asadbahauddin/thermoadapt-fryer/README.md

# ThermoAdapt Fryer

**Kontrol suhu minyak deep fryer berbahan bakar gas dengan Adaptive PID berbasis ESP32.**
Termasuk firmware mikrokontroler, telemetri WebSocket, logger data Python, serta
identifikasi sistem (FOPDT) dan tuning PID robust (SIMC) di MATLAB.

> Status: prototipe riset. Bagian yang **belum terverifikasi di hardware** ditandai di
> komentar kode. Jangan sambungkan servo ke katup gas sebelum `SERVO_SAFETY` diaktifkan.

## Struktur

| Folder / file | Isi |
|---|---|
| `dep_frayer/dep_frayer.ino` | Firmware ESP32: WiFi AP + web + WebSocket, MAX31855, servo katup gas, motor DC Z (BTS7960), stepper X (TB6600), 4 limit switch, LCD ILI9488, buzzer |
| `Python/` | Logger data uji via WebSocket: grafik live (suhu vs setpoint, bukaan servo) + CSV semua sensor/aktuator, auto-simpan CSV & PNG saat berhenti |
| `Program/` | Model Simulink Adaptive PID + simulasi (parameter plant masih asumsi) |
| `Program/step_test/` | Identifikasi FOPDT dari data step test + tuning PI SIMC + cek robustness (Ms, PM, GM) |
| `pin_scan.txt` | Sketch diagnostik pin limit switch |
| `FRITZINK.fzz` | Rangkaian (Fritzing) |

## Perangkat keras

ESP32 DevKit V1 30-pin · thermocouple K + MAX31855 · servo 180° pada katup gas ·
motor DC + BTS7960 (sumbu Z) · stepper NEMA + TB6600 (sumbu X) · TFT ILI9488 · 4 limit switch.

## Logger data (Python)

```
pip install -r Python/requirements.txt
python Python/logger.py            # laptop tersambung ke WiFi DeepFryer-ESP32
python Python/logger.py --demo     # coba tanpa hardware
python Python/uji_logger.py        # uji otomatis (parser, WebSocket, end-to-end)
```

Berhenti dengan menutup jendela grafik atau Ctrl+C. CSV (ditulis tiap sampel, aman bila
crash) dan PNG seluruh pengujian tersimpan di `Python/data/deepfryer_<tanggal>_<jam>.*`.
Satu baris per sampel suhu (1 Hz); waktu memakai jam ESP32 (`ms`) sehingga bebas jitter WiFi.
Kolom PID (firmware rev 16-17): `pid_aktif`, `pid_output_pct`, `setpoint_efektif_c`, `kp`, `ki`, `kd`
(gain yang SEDANG dipakai, berubah tiap detik saat Adaptive PID), `kp0`/`ki0`/`kd0` (gain dasar),
`pid_adaptif`, `lambda_p`/`lambda_i`/`lambda_d`,
`pid_umax_pct`. Grafik live: suhu vs setpoint vs setpoint efektif, dan sudut servo vs keluaran PID.
`suhu_c` adalah suhu tersaring firmware (Cascaded Filtering 3 tahap: Median-5 → Moving Average-5 → EMA, + hold saat sensor error);
`suhu_mentah_c`, `suhu_ditahan`, `sensor_error_total` mencatat bacaan mentah dan kondisi sensor.
Kolom `buzzer_aktif` sudah ada tetapi kosong karena
firmware belum mengirimnya.

## Alur tuning PID

1. Step test open-loop (PID mati, bukaan katup manual), rekam dengan logger Python.
2. `analisis_step_test('file.csv')` di MATLAB → model K, τ, L per titik kerja.
3. Gain PI SIMC yang aman di semua titik kerja (Ms terburuk ≤ 1.7).
4. Validasi di Simulink, lalu di alat.

Uji tanpa hardware: `uji_sintetis` di `Program/step_test/`.
