asadbahauddin/thermoadapt-fryer/FRITZINK_bb.png

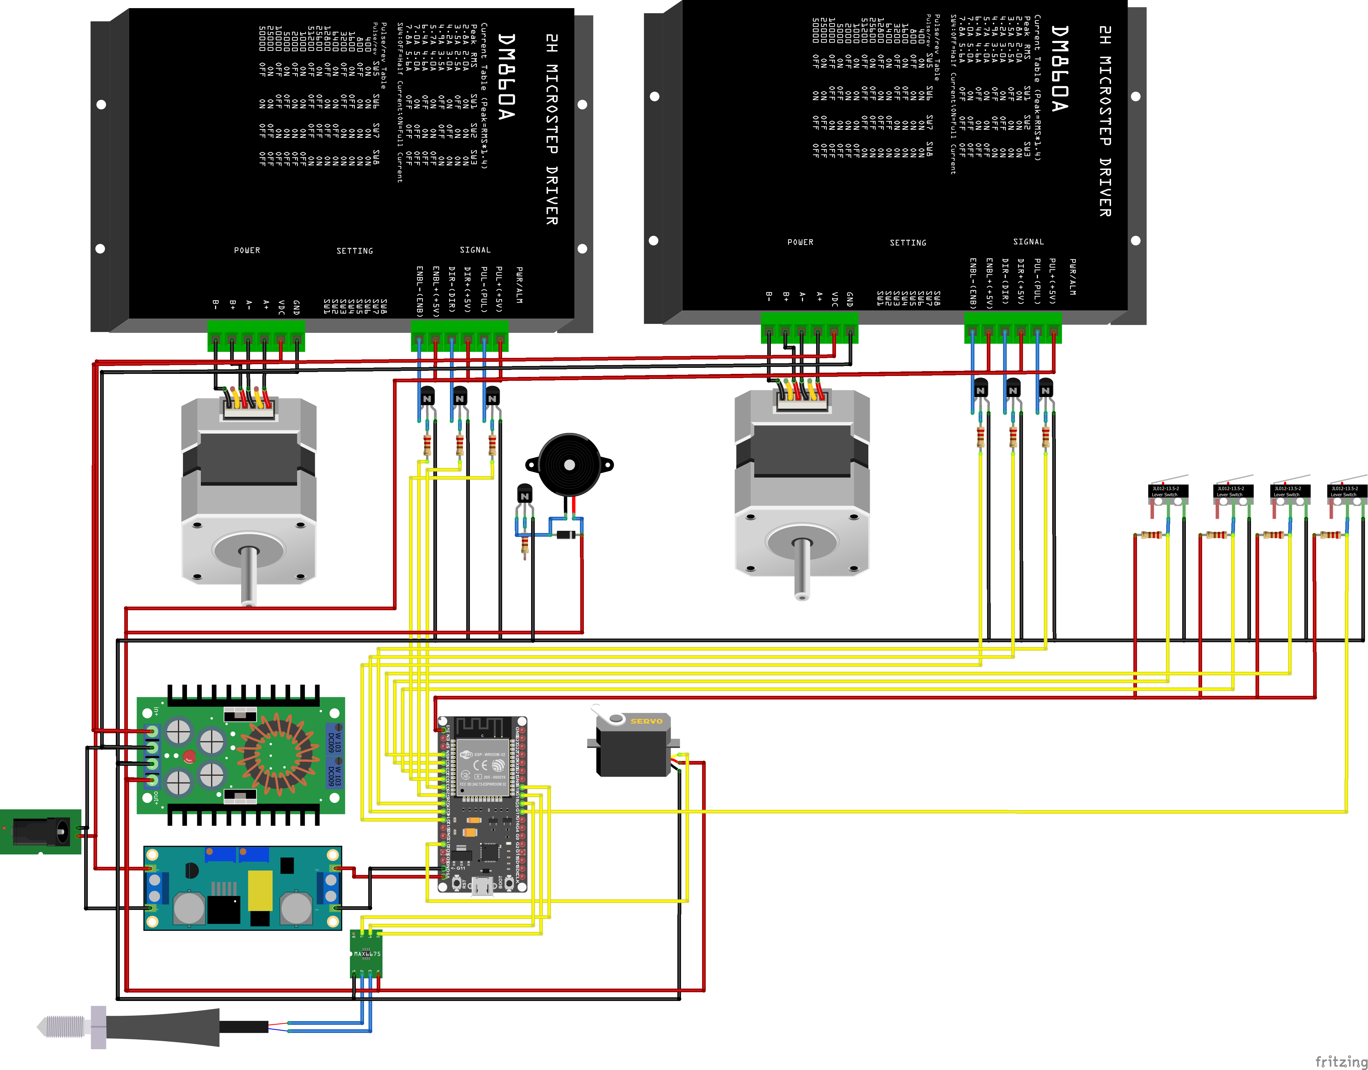
FRITZINK_bb.png
