asadbahauddin/thermoadapt-fryer/Program/deep_fryer_adaptive_pid_response.png

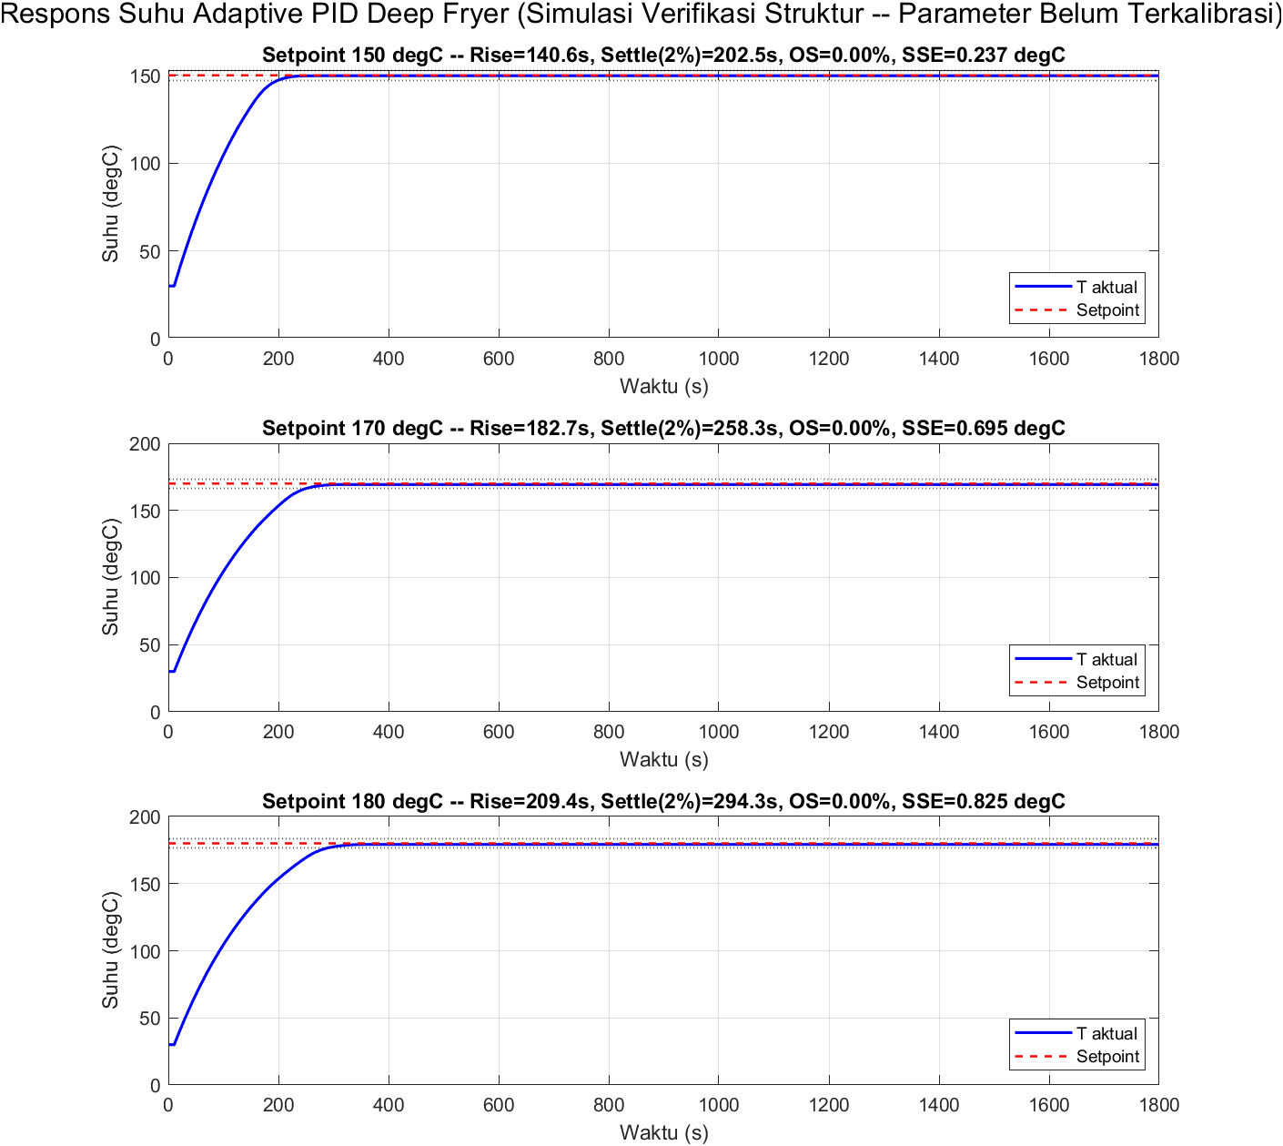
Program/deep_fryer_adaptive_pid_response.png
