asadbahauddin/thermoadapt-fryer/(list of files, drawings)

Other design files:
FRITZINK.fzz
