asadbahauddin/thermoadapt-fryer/dep_frayer/dep_frayer.ino

/*
 * DEEP FRYER CERDAS - MONITOR & KONTROL VIA WEB + LCD (rev 38)
 * ESP32 = WiFi Access Point (192.168.4.1) + WebSocket.
 * Isi: suhu MAX31855, 4 limit switch, Z = MOTOR DC (BTS7960), X = stepper (TB6600),
 *      SERVO katup gas 0-180 derajat (kalibrasi), BUZZER, LCD TFT mirror dari web.
 *
 * REV 38 (dari rev 37): integral TIDAK PERNAH dinolkan: dibekukan saat TAHAN AMAN (sensor error/
 *   data berhenti), diingat saat STOP PID/STOP dan dipakai lagi saat PID ON (berlaku kedua mode).
 *
 * REV 37 (dari rev 36): TAHAN overshoot membekukan integral (dulu dinolkan) -> tidak ada lagi
 *   penurunan suhu 7-18 C setelah tiap TAHAN (analisis log 31 Okt & 1 Nov, simulasi IAE -58..-89%).
 *
 * REV 36 (dari rev 35): Uji Sistem - Z naik 60% (55% kurang kuat), rentang stabil SP +-3 C
 *   (dulu SP-3..SP+7); tetap harus 30 dtk berturut-turut di rentang sebelum keranjang turun.
 *
 * REV 35 (dari rev 34): Uji Sistem - suhu dianggap stabil setelah 30 dtk (dulu 10 dtk)
 *   berturut-turut di SP-3..SP+7 sebelum keranjang diturunkan.
 *
 * REV 34 (dari rev 33): TOMBOL MODE PID + FEEDFORWARD BEBAN (analisis log 31 Okt)
 *   - Web: PID ADAPTIF ON ("pidm,1"), PID KONVENSIONAL ON ("pidm,0", gain dasar tetap), STOP PID.
 *   - Feedforward beban keripik: saat Uji Sistem menurunkan keranjang, keluaran + 25% meluruh
 *     (tau 90 dtk), ditahan saat suhu >= setpoint, batal saat TAHAN/PID mati. Gain dasar TIDAK
 *     diubah (identifikasi closed-loop: sudah di rentang SIMC). JSON temp: pf (FF %), am (mode).
 *
 * REV 33 (dari rev 32): UJI SISTEM / UJI KEMATANGAN OTOMATIS (perintah "uj,<detik>")
 *   - Z naik ke Z Atas -> X ke X Awal -> suhu di SP-3..SP+7 selama 10 dtk -> Z turun 50% sampai
 *     Z Bawah -> timer goreng (default 120 dtk, 5-1800 dari web) -> Z naik 55% sampai Z Atas ->
 *     X ke X Akhir (tetap di sana). Gerak uji tanpa batas waktu (limit switch yang menghentikan).
 *   - PID dinyalakan otomatis & tetap ON. STOP membatalkan uji. Gerak manual ditolak selama uji.
 *   - JSON "temp": uj (tahap 0-9), us (detik; tahap 5 = sisa timer), uf (timer); dicatat logger.
 *
 * REV 32 (dari rev 31): PEMBACAAN MAX31855 DIPERKUAT (analisis bacaan 200 C)
 *   - Tiap sampel: frame dibaca 2x berturut-turut; berbeda = data rusak di SPI -> ditolak.
 *   - Dekode sendiri dgn validasi datasheet (D16, D17, D3, 0x0/0xFFFFFFFF, cold junction -20..85 C).
 *     Library readCelsius() hanya cek D2..D0: frame rusak lolos sbg suhu "sah", 0x00000000 = 0 C.
 *   - Acuan cek kewajaran baru sah setelah 3 sampel konsisten (dulu 1: sampel rusak bisa jadi acuan).
 *   - Penghitung per jenis error + suhu chip di web (JSON "st": nf, nb, nm, nc, nj, cj) & logger.
 *
 * REV 31 (dari rev 30):
 *   - LCD DIMATIKAN (LCD_ENABLE 0): tidak diinisialisasi/digambar; bus SPI hanya untuk MAX31855.
 *     CS LCD (4) & CS touch (16) ditahan HIGH; GPIO15 (RESET LCD) tidak dikendalikan.
 *     Tombol "Reset LCD" membalas "LCD dimatikan". LCD_ENABLE 1 = perilaku rev 30.
 *   - Sudut servo paling minimum -1 derajat (manual, kalibrasi, TUTUP). TUTUP tersimpan -3 -> -1.
 *
 * REV 30 (dari rev 29): PENGAMAN 180 C DINONAKTIFKAN (keputusan pengguna, ada E-stop fisik)
 *   - PID_CUTOFF_ENABLE 0: tidak ada batas suhu otomatis di PID (kode tetap ada; ganti ke 1 untuk
 *     mengaktifkan lagi). TAHAN untuk sensor error / data berhenti / overshoot tetap ada.
 *   - Web: setpoint > 200 C minta konfirmasi (penangkal salah ketik, bukan batas).
 *   - Simulasi rev 29: tanpa batas, setpoint tinggi benar-benar dikejar; E-stop wajib memutus gas.
 *
 * REV 29 (dari rev 28): SETPOINT BEBAS
 *   - Setpoint menerima angka berapa pun (web & firmware), tanpa batas 20-165. Pengaman 180 C
 *     tetap: suhu >= 180 -> TAHAN AMAN (katup TUTUP, PID ON) sampai <= 175. Kode TAHAN 5 dihapus.
 *
 * REV 28 (dari rev 27): PID ON SELALU BISA DINYALAKAN
 *   - Dulu PID ON ditolak bila sensor tidak valid/HELD, suhu >= 175 C, setpoint > 165 C, step test
 *     berjalan, atau servo terkunci. Sekarang PID ON selalu berhasil; kondisi tidak aman ->
 *     langsung TAHAN AMAN (katup TUTUP) dan berjalan sendiri saat normal. Step test yang berjalan
 *     dihentikan otomatis.
 *   - Setpoint maks = 165 C di web & firmware (dulu web menerima sampai 200 tetapi PID menolak).
 *
 * REV 27 (dari rev 26): PID TIDAK PERNAH MATI OTOMATIS (permintaan pengguna)
 *   - PID hanya mati lewat PID OFF / STOP. Sensor error > 5 dtk, suhu >= 180 C, data suhu berhenti,
 *     setpoint > batas, dan overshoot -> TAHAN AMAN: katup TUTUP (api minimum), integral 0, PID
 *     tetap ON, lanjut sendiri saat kondisi normal (180 C: lanjut di <= 175 C). JSON "ph" = kode.
 *   - Setelah ESP restart PID tetap OFF (sengaja: api tidak menyala sendiri tanpa orang).
 *
 * REV 26 (dari rev 25): CEK KEWAJARAN SENSOR
 *   - Bacaan yang melompat lebih cepat dari SENSOR_MAX_RATE_C_S (5 C/dtk) + margin 2 C dianggap
 *     BACAAN SALAH (mis. 65 -> 200 C): nilai wajar terakhir ditahan (HELD), PID TETAP HIDUP.
 *     Bila bertahan > 3 dtk -> NAN; > 5 dtk -> PID mati "sensor error". Kenaikan nyata yang
 *     bertahap sampai 180 C tetap mematikan PID (batas akhir). Batas lolos melebar seiring waktu
 *     sejak sampel wajar terakhir (acuan TIDAK dihapus saat masa tahan habis; 65 -> 200 C baru
 *     diterima setelah ~27 dtk). Bacaan di luar -20..450 C selalu dianggap salah.
 *
 * REV 25 (dari rev 24):
 *   - WebSocket heartbeat (ping 5 dtk, 2x tanpa pong -> putus). Klien mati tidak lagi
 *     menghabiskan 5 jatah klien library (gejala: halaman tampil tapi "tidak bisa ditekan").
 *   - Jumlah klien WebSocket tampil di baris diagnosa web ("st": wc, wm).
 *   - Halaman web diuji di Chrome headless (klik mouse & sentuh HP, ESP tiruan): 55/55 tombol
 *     mengirim perintah, tanpa error JavaScript, tidak ada elemen yang menutupi tombol.
 *
 * REV 24 (dari rev 23):
 *   - OVERSHOOT tidak lagi mematikan PID: suhu >= setpoint + PID_HOLD_C (10 C) -> katup ditahan
 *     TUTUP, integral 0, PID tetap ON; normal lagi saat suhu <= setpoint + 7 C. PID MATI hanya
 *     di batas akhir TEMP_CUTOFF_C (180 C), sensor error, atau STOP. JSON "temp" + "ph" (tahan).
 *   - Step test web: hasil ditandai TIDAK VALID (gain tidak ditampilkan) bila R^2 < 0.9,
 *     kenaikan < 10 C, kemiringan tidak konsisten, atau durasi < 3 x dead time.
 *   - Gain default sementara: Kp 1.46, Ki 0.0054 (Ti 270 dtk), lambda_i 0.
 *
 * REV 23 (dari rev 22):
 *   - Reset LCD otomatis tiap 30 dtk DIMATIKAN (LCD_REINIT_MS 0): pengguna menilai rev 21 lebih
 *     stabil. Diganti tombol "Reset LCD" di web (perintah "lcdr") yang menjalankan urutan sama:
 *     pin RESET -> tft.init() -> MAX31855 begin() -> gambar ulang (non-blocking, di uiTask).
 *     Pin RESET saja TIDAK cukup: setelah reset hardware ILI9488 kembali ke kondisi awal
 *     (sleep, format warna & rotasi hilang) sehingga harus diinisialisasi ulang.
 *   - Watchdog, diagnosa, dan pola non-blocking rev 22 tetap.
 *
 * REV 22 (dari rev 21): ROBUST
 *   - LCD di-reset (hardware) + diinisialisasi ulang tiap LCD_REINIT_MS (30 dtk), lalu semua
 *     elemen digambar ulang. MAX31855 di-begin() ulang (bus SPI dipakai bersama LCD).
 *     Sampling suhu tertunda ~0.4 dtk saat itu; layar berkedip sesaat.
 *   - WATCHDOG: loop() dan uiTask diawasi; macet > WDT_TIMEOUT_S (10 dtk) -> ESP restart
 *     sendiri. Setelah restart katup ke TUTUP, PID mati, motor diam (aman, tidak lanjut sendiri).
 *   - Alasan boot terakhir (POWER_ON / TASK_WDT / BROWNOUT / PANIC ...), heap minimum,
 *     sisa stack uiTask, dan jumlah reset LCD tampil di web (JSON "st": rr, hp, sk, lr).
 *   - IP di LCD diformat tanpa String (tidak memecah heap tiap 150 ms).
 *   - NON-BLOCKING / MULTITASKING KOOPERATIF / BLINK WITHOUT DELAY:
 *       core 1 loop(): web, WebSocket, stepper, step test, servo (20 ms), motor DC (10 ms),
 *                      buzzer (pola ms), PID (tiap sampel 1 Hz), status (250 ms); semua berbasis
 *                      millis(), tanpa delay().
 *       core 0 uiTask: servis LCD (state machine reset), sampel suhu (200 ms), LCD (150 ms),
 *                      reset LCD (30 dtk); vTaskDelay(10 ms) menyerahkan CPU tiap putaran.
 *     Reset LCD dulu delay(210 ms) -> sekarang state machine millis(). Sisa tunggu: delay
 *     internal tft.init() library (~295 ms, tiap 30 dtk, hanya di core 0) dan
 *     delayMicroseconds(2) waktu setup CS MAX31855 (syarat datasheet).
 *
 * REV 21 (dari rev 20):
 *   - FILTER SUHU diganti CASCADED FILTERING 3 TAHAP: Median-5 -> Moving Average-5 -> EMA
 *     (alpha 0.3), menggantikan tolak-lonjakan + Savitzky-Golay rev 15. HOLD saat fault tetap.
 *     Jeda ~1.3 dtk, std noise ~34%, lonjakan 1-2 sampel dibuang (lihat blok FILTER).
 *   - Servo default hasil kalibrasi: TUTUP -3 derajat, BUKA 55 derajat. PID Umax default 100%
 *     (seluruh rentang). Nilai di flash (bila pernah disimpan dari web) tetap diutamakan.
 *
 * REV 20 (dari rev 19): PERBAIKAN "mentok di 0 derajat"
 *   - Tombol -1/+1 dan kotak "Sudut" (sva/svad) dulu memakai setServoAngle() yang DIAM-DIAM
 *     mengunci ke TUTUP..BUKA, sehingga di 0 derajat -1 tidak berbuat apa-apa. Sekarang semua
 *     perintah manual memakai setServoAngleManual(): -30..180 derajat, dibatasi pulsa, dan
 *     memberi pesan bila ditolak. PID & step test tetap dikunci TUTUP..BUKA.
 *   - Halaman web dikirim dengan header no-cache (HP tidak memakai halaman lama).
 *   - Versi firmware (FW_REV) tampil di judul halaman web.
 *
 * REV 19 (dari rev 18): kalibrasi boleh SUDUT NEGATIF (sampai SERVO_CAL_MIN_DEG, dibatasi pulsa
 *   >= SERVO_US_ABS_MIN), mis. TUTUP = -3 derajat bila di 0 derajat katup masih bocor.
 *
 * REV 18 (dari rev 17): KALIBRASI KATUP lewat kotak angka (tanpa slider)
 *   - Web: sudut uji 0..180 per 1 derajat ("svk,<deg>", bebas dari kunci TUTUP..BUKA), simpan
 *     sebagai TUTUP/BUKA ("svset,c|o"), koreksi pulsa 0/180 derajat ("svcal,<us0>,<us180>").
 *     Tersimpan di flash dan DIMUAT saat boot (rev 13 sempat memaku 0/55).
 *     Syarat: TUTUP < BUKA, selisih >= 5 derajat. Ditolak saat PID aktif / step test.
 *   - Slider sudut dihapus; diganti kotak sudut + tombol -1/+1.
 *   - Keputusan pengguna: TUTUP = katup RAPAT (api PADAM), tidak ada sudut api minimum.
 *     [Hasil kalibrasi di alat: servo mentok di -3 derajat dan katup masih menyisakan api kecil yang
 *      tidak mampu menaikkan suhu -> TUTUP = api minimum (berfungsi seperti pilot), BUKAN padam.]
 *     PID 0%, STOP, PID OFF, akhir step test -> gas berhenti. Saat katup membuka lagi gas keluar
 *     TANPA api kecuali ada pemantik/pilot yang selalu menyala. Harus ada orang di dekat mesin.
 *
 * REV 17 (dari rev 16): ADAPTIVE PID (BELUM diuji di alat)
 *   - Hukum adaptasi sama dgn model Simulink: Kp = Kp0 + lambda_p|e|, Ki = Ki0 + lambda_i|e|,
 *     Kd = Kd0 + lambda_d|dT/dt|, dibatasi PID_KP_MAX/KI_MAX/KD_MAX (dicek Ms, lihat konfigurasi).
 *   - Web: ADAPTIF ON/OFF (OFF = PID biasa sbg pembanding), lambda, gain yang sedang dipakai.
 *     Perintah "pida,<0|1>", "pidl,<lp>,<li>,<ld>"; disimpan di flash.
 *   - JSON "temp" + kpe/kie/kde (gain DIPAKAI tiap sampel); "st" + ad, lp, li, ld.
 *     kp/ki/kd di "st" = gain DASAR (Kp0/Ki0/Kd0).
 *   - Tanpa deadband integral (sesuai keputusan pengguna).
 *
 * REV 16 (dari rev 15): PID SUHU (pertama, BELUM diuji di alat)
 *   - Kontrol PID suhu -> bukaan katup (0..Umax persen dari rentang TUTUP..BUKA), update tiap
 *     sampel suhu TERKIRIM (1 Hz, dari nilai tersaring rev 15; dt dari gTempMs). Web: kotak
 *     "PID Suhu" (ON/OFF, Kp, Ki, Kd, Umax; disimpan di flash). Setpoint: "sp,<C>".
 *     Bentuk: u = Kp*e + I + D, Ki dalam %/(C*dtk) (= Kp/Ti), D pada PENGUKURAN (terfilter).
 *     Default dari step test web: Kp 1.9, Ti ~34 dtk (Ki 0.056), Kd 0. TEBAKAN AWAL, bukan optimum.
 *   - Setpoint efektif naik bertahap (PID_SP_RAMP_C_S) mulai dari suhu saat PID dinyalakan.
 *   - Anti-windup (integrasi bersyarat + batas), start tanpa loncatan (bumpless).
 *   - Saat suhu DITAHAN (HELD, rev 15): integral & derivatif dibekukan, keluaran tetap.
 *   - PENGAMAN: PID mati + katup TUTUP bila sensor error > SENSOR_FAULT_MS, tidak ada sampel
 *     suhu baru > SENSOR_FAULT_MS (uiTask macet), suhu >= setpoint + PID_OVER_C atau
 *     >= TEMP_CUTOFF_C - 5, tombol STOP, atau step test berjalan. Servo manual ditolak saat PID
 *     aktif. [rev 18: TUTUP kini dikalibrasi RAPAT = api PADAM, lihat REV 18.] PID tidak bisa mendinginkan.
 *   - Setpoint dibatasi <= PID_SP_MAX_C (TEMP_CUTOFF_C - 15) selama PID aktif.
 *   - JSON "temp" + pe (PID aktif), pu (keluaran %), se (setpoint efektif);
 *     "st" + kp, ki, kd, pm (Umax %). ("um" TETAP pulsa servo 0 derajat; Umax sengaja "pm".)
 *   - Perintah web > 63 karakter dibalas "terlalu panjang" (dulu dibuang diam-diam di 48).
 *   - Harus ada orang di dekat mesin. Tidak ada E-stop fisik.
 *
 * REV 15 (dari rev 14):
 *   - BTS7960 sesuai wiring terbaru: GPIO27 = RPWM | GPIO26 = LPWM | GPIO14 = R_EN + L_EN
 *     (RPWM/LPWM sempat tertukar di awal rev 15: 26/27 dibalik setelah dicek pengguna).
 *     GPIO14 mengeluarkan PWM singkat saat boot; dcInit() dijalankan PERTAMA di setup() dan
 *     menahan EN LOW, tetapi selama bootloader (sebelum setup) firmware belum berjalan:
 *     WAJIB pull-down 10k ke GND di EN (14), RPWM (27), dan LPWM (26).
 *     DC_POS_USES_RPWM dikembalikan ke true. ARAH NAIK/TURUN HARUS DIUJI ULANG.
 *   - SENSOR SUHU: sampling 200 ms, tolak lonjakan > SENSOR_MAX_JUMP_C, HOLD nilai terakhir
 *     maks SENSOR_HOLD_MS saat error, lalu Savitzky-Golay kausal (11 titik, orde 2).
 *     gTemp = nilai tersaring. Pesan "temp" (tetap 1 Hz) ditambah "tr" (mentah), "held", "ec".
 *     SENSOR_FILTER_ENABLE 0 = perilaku lama (tanpa tolak lonjakan/hold/SG).
 *
 * REV 14 (dari rev 13):
 *   - STEP TEST open-loop (tampil di web saja): servo dipindah ke satu bukaan tetap dari
 *     TUTUP, suhu dicatat tiap 1 dtk oleh browser, lalu web menghitung kemiringan (R), dead
 *     time (L) dan USULAN awal Kp/Ki/Kd (Ziegler-Nichols kurva reaksi, dan PI konservatif).
 *     Perintah: "stt,<sudut>,<batasC>,<menit>" (mulai), "stx" (batal), tombol STOP juga membatalkan.
 *     Pengaman: berhenti + katup ke TUTUP bila suhu >= batas, sensor error >5 dtk, batas waktu,
 *     atau dibatalkan. Selama test, perintah servo manual ditolak. Ada api menyala TANPA PID:
 *     harus ada orang di dekat mesin. Tidak ada E-stop fisik.
 *   - Data hilang bila browser terputus/ditutup saat test (firmware tidak menyimpan sampel).
 *
 * REV 13 (dari rev 12):
 *   - LIMIT SWITCH: penamaan dipetakan ulang (hasil pengujian fisik: Z Atas/Z Bawah dan
 *     X Awal/X Akhir sebelumnya tertukar):
 *       GPIO17 = Z Atas | GPIO35 = Z Bawah | GPIO39 = X Awal | GPIO34 = X Akhir
 *     Perilaku pengaman tidak berubah (tiap pin tetap memblok arah yang sama): "naik" (+) memeriksa
 *     switch Z Atas, "+" X memeriksa switch X Akhir. Semua interlock AKTIF.
 *   - SERVO: hanya TUTUP (0) dan BUKA (55). Tombol TUTUP/BUKA, bukaan %, penyetelan halus.
 *     Kalibrasi/simpan sudut/tes pulsa dihapus dari web. Sudut dikunci 0..55 di firmware
 *     dan sudut tutup/buka dipaku (tidak diambil dari flash).
 *
 * REV 12 (dari rev 11):
 *   - SETPOINT suhu: diatur dari web (perintah "sp,<C>", 20-200 C), disimpan di flash,
 *     digambar putus-putus (oranye) di grafik suhu web. BELUM ada PID.
 *   - Pesan WebSocket "temp" ditambah "sp", "seq", "ms"; pesan "st" ditambah "sp".
 *
 * REV 11 (dari v10):
 *   - STEPPER Z DIHAPUS dari kode. Pin 26/27/14 sekarang milik BTS7960
 *       (pemetaan rev 11 di bawah KELIRU, sudah diganti di rev 15: 27 = RPWM, 26 = LPWM, 14 = EN):
 *       GPIO26 = EN (R_EN + L_EN disatukan) | GPIO27 = LPWM | GPIO14 = RPWM
 *     Satu-satunya stepper: X (STEP32, DIR33, EN25).
 *     Pull-down 10k di EN, LPWM, RPWM ke GND (GPIO14 mengeluarkan PWM sesaat saat boot;
 *     karena EN ada di GPIO26 dan ditarik LOW, motor tetap diam saat boot).
 *     [Alasan ini TIDAK berlaku lagi sejak rev 15: EN sekarang di GPIO14; lihat REV 15.]
 *   - SERVO 180 derajat, MODE KALIBRASI TANPA PEMBATAS (servo belum dipasang ke gas):
 *       * Slider/tombol sudut 0-180, tombol relatif +-1/+-5/+-10.
 *       * "Simpan sebagai TUTUP/BUKA": menyimpan sudut yang sedang dipakai ke flash.
 *       * Kalibrasi pulsa: us untuk 0 derajat dan 180 derajat (default 500/2500, BELUM
 *         terverifikasi; sesuaikan dgn servo-mu).
 *       * Tes pulsa mentah (us) untuk mencari ujung jangkauan servo.
 *       * Kunci pengaman (sensor error / suhu lewat batas) DIMATIKAN (SERVO_SAFETY false).
 *         Nyalakan lagi sebelum servo terhubung ke gas!
 *       * Tanpa batas laju (SERVO_SLEW_DEG_S = 0): servo melompat ke target. Lonjakan arus
 *         servo bisa mengganggu rel 5V / pembacaan suhu.
 *       * HATI-HATI: pulsa di luar jangkauan mekanik servo membuat servo menekan stopper
 *         (panas, bunyi dengung, bisa rusak). Cari ujung jangkauan pelan-pelan dgn tes pulsa
 *         mentah, jangan langsung ke nilai ekstrem.
 *   - Motor DC Z: duty dibatasi MOTOR_RATED_V / MOTOR_SUPPLY_V = 12/24 = 50% ("100%" di web =
 *     rata-rata 12 V; motor tetap melihat pulsa 24 V). PWM 20 kHz, naik bertahap, batas waktu
 *     gerak 8 s, berhenti seketika bila limit kena (BENCH_MODE false & limit interlock).
 *   - LCD: reset manual ke GPIO15 sebelum tft.init(). User_Setup.h: TFT_RST -1.
 *   - Buzzer aktif di GPIO2 (via BC547). Bip pendek saat boot, kotak "Cek Buzzer" di web.
 *
 * LIBRARY: TFT_eSPI (Bodmer), Adafruit MAX31855 (+BusIO), WebSockets (Markus Sattler),
 *          AccelStepper. WiFi, WebServer, Preferences bawaan core.
 * User_Setup.h: lihat User_Setup_DeepFryer.txt.
 *
 * PERINGATAN:
 *   - BENCH_MODE true: interlock limit & batas jog NONAKTIF. WAJIB false sebelum motor
 *     dipasang ke mekanik.
 *   - Belum ada E-stop fisik. Firmware ini belum dikompilasi/diuji di hardware oleh penulisnya.
 */

#include <WiFi.h>
#include <WebServer.h>
#include <WebSocketsServer.h>
#include <SPI.h>
#include <Preferences.h>
#include <TFT_eSPI.h>
#include <Adafruit_MAX31855.h>
#include <AccelStepper.h>
#include <esp_task_wdt.h>         // rev 22: watchdog (ESP restart sendiri bila macet)

#define FW_REV "rev 38"     // tampil di judul halaman web: cek apakah firmware terbaru sudah ter-upload

// ---- ROBUST (rev 22) ----
#define LCD_ENABLE      0         // rev 31: 0 = LCD DIMATIKAN; bus SPI hanya untuk MAX31855 (fokus termokopel).
                                  //   CS LCD (TFT_CS) & CS touch (TOUCH_CS) ditahan HIGH. GPIO15 (RESET LCD)
                                  //   sengaja TIDAK dikendalikan (bila RESET disolder ke 3V3, LOW = hubung singkat).
#define LCD_REINIT_MS   0UL       // rev 23: reset LCD otomatis MATI (rev 22 tiap 30 dtk terasa kurang stabil);
                                  // reset manual lewat tombol "Reset LCD" di web. >0 = reset otomatis tiap N ms
#define WDT_TIMEOUT_S   10        // loop() atau uiTask macet > 10 dtk -> ESP restart
#define WS_PING_MS          5000  // rev 25: heartbeat WebSocket (buang klien mati)
#define WS_PONG_TIMEOUT_MS  3000
#define WS_PONG_MISS        2
                                  // (setelah restart: katup ke TUTUP, PID mati, motor diam)

// ---------------- PIN ----------------
#define PIN_MAX_SCK 18
#define PIN_MAX_CS  5
#define PIN_MAX_SO  19

#define PIN_X_STEP 32
#define PIN_X_DIR  33
#define PIN_X_EN   25

// BTS7960 (rev 15, wiring terbaru; dicek kontinuitas oleh pengguna).
// Pull-down 10k ke GND di ketiga pin: GPIO14 mengeluarkan PWM singkat saat boot.
#define PIN_DC_RPWM 27
#define PIN_DC_LPWM 26
#define PIN_DC_EN   14     // R_EN + L_EN BTS7960 (disatukan)

#define PIN_SERVO   13
#define PIN_TFT_RST 15     // RESET modul layar (dipulsa manual di uiTask)
#define PIN_BUZZ     2     // buzzer aktif via BC547 (GPIO2 = pin strapping)
#define BUZZER_ACTIVE_HIGH true

// ---------------- LIMIT SWITCH (TABEL KONFIGURASI) ----------------
// activeHigh = true : HIGH berarti KENA. false : LOW berarti KENA (bebas = HIGH).
// verified   = true : tampil normal. false = kuning (?)
// interlock  = true : dipakai sebagai pengaman gerak (hanya jika BENCH_MODE false)
enum { LS_ZATAS = 0, LS_ZBAWAH, LS_XAWAL, LS_XAKHIR, LS_COUNT };

struct LimitCfg { const char* name; uint8_t pin; bool activeHigh; bool verified; bool interlock; };
LimitCfg LS[LS_COUNT] = {
  // PEMETAAN (rev 13, hasil pengujian fisik): GPIO17 = Z Atas | GPIO35 = Z Bawah |
  //                                           GPIO39 = X Awal | GPIO34 = X Akhir
  // interlock = true: gerak berhenti saat limit di arah geraknya kena. Semua AKTIF.
  // Jika satu switch ternyata tidak bereaksi/terbalik, set interlock false untuk pin itu.
  { "Z Atas",  17, false, true, true },
  { "Z Bawah", 35, false, true, true },
  { "X Awal",  39, false, true, true },
  { "X Akhir", 34, false, true, true },
};

// ---------------- KONFIGURASI ----------------
const char* AP_SSID = "DeepFryer-ESP32";
const char* AP_PASS = "fryer1234";             // minimal 8 karakter
IPAddress AP_IP(192, 168, 4, 1);
IPAddress AP_GW(192, 168, 4, 1);
IPAddress AP_MASK(255, 255, 255, 0);

#define BENCH_MODE             false   // false = interlock limit AKTIF (Z DC berhenti di Z Atas/Z Bawah; X jog tanpa limit terverifikasi dibatasi 200 step). true = meja uji tanpa pengaman
#define EN_HIGH_MEANS_ENABLED  false   // TB6600 (X): GPIO LOW = driver AKTIF (hasil ukur)
#define Z_PLUS_TOWARD_ATAS     true    // arah + Z (naik) menuju limit "atas"
#define X_PLUS_TOWARD_AKHIR    true    // arah + (KANAN) menuju switch GPIO34 ("X Akhir" setelah pemetaan ulang)
#define X_DIR_INVERT           false

#define MAX_JOG_STEPS        2000000000L
#define MAX_JOG_UNVERIFIED   200
#define DEFAULT_SPEED_X  3000
#define DEFAULT_ACCEL_X  3000
#define MIN_SPEED 50
#define MAX_SPEED 10000
#define MIN_ACCEL 50
#define MAX_ACCEL 12000

// ---- MOTOR DC Z (BTS7960) ----
#define MOTOR_SUPPLY_V      24.0f    // tegangan catu modul BTS7960 (ukur dgn multimeter)
#define MOTOR_RATED_V       12.0f    // tegangan motor; duty maks = RATED / SUPPLY
#define DC_POS_USES_RPWM    true     // positif (naik) memakai RPWM (GPIO27); false = LPWM (GPIO26)
                                     // Dikembalikan ke default (rev 15): koreksi "false" sebelumnya
                                     // dibuat saat pin masih keliru. ARAH BELUM TERVERIFIKASI: uji
                                     // "Naik 25%" sambil tangan di saklar catu daya; bila terbalik
                                     // ubah ke false. Interlock limit Z bergantung pada arah ini.
#define DC_PWM_FREQ         20000
#define DC_PWM_BITS         10
#define DC_LEDC_CH_R        2        // hanya core ESP32 v2 (servo memakai kanal 0)
#define DC_LEDC_CH_L        3
#define DC_RAMP_PCT_S       100.0f   // laju naik/turun keluaran (persen per detik)
#define DC_MAX_PCT          100      // batas perintah motor DC Z (persen web); belum diuji dengan beban, turunkan ke 50 bila perlu
#define DC_MAX_RUN_MS       8000UL   // batas waktu 1x gerak
#define DC_BRAKE_WHEN_IDLE  true     // true: EN HIGH saat diam (rem); false: EN LOW (bebas)

// ---- SERVO / KATUP (kalibrasi, tanpa pembatas) ----
#define SERVO_FREQ_HZ           50
#define SERVO_PWM_BITS          14
#define SERVO_LEDC_CH           0        // hanya core ESP32 v2
#define SERVO_US_ABS_MIN        300      // batas kewajaran input pulsa mentah
#define SERVO_US_ABS_MAX        3000
#define DEFAULT_SERVO_US_MIN    500      // us untuk 0 derajat   (BELUM terverifikasi)
#define DEFAULT_SERVO_US_MAX    2500     // us untuk 180 derajat (BELUM terverifikasi)
#define DEFAULT_SERVO_CLOSED_DEG -1      // rev 31: TUTUP = -1 derajat (sudut minimum untuk uji berikut).
                                         // rev 21 sempat -3 (servo mentok, api sangat kecil)
                                         // (servo mentok; api sangat kecil yang tidak menaikkan suhu)
#define DEFAULT_SERVO_OPEN_DEG   55      // sudut katup BUKA  (hasil kalibrasi: membuka di 55 derajat)
#define SERVO_SLEW_DEG_S        0.0f     // 0 = tanpa batas laju (melompat ke target)
#define SERVO_MIN_SPAN_DEG      5        // rev 18: BUKA - TUTUP minimal (derajat)
#define SERVO_CAL_MIN_DEG       -1       // rev 31: SUDUT PALING MINIMUM -1 (manual, kalibrasi, TUTUP).
                                         // TUTUP tersimpan < -1 (mis. -3) gagal servoAnglesOk -> default -1.
                                         // rev 19: kalibrasi boleh di bawah 0 derajat (sudut negatif =
                                         // pulsa < pulsa 0 derajat, mis. -1 = 500 - 11 = ~489 us).
                                         // Batas sebenarnya: pulsa >= SERVO_US_ABS_MIN (~ -18 derajat default)

#define SERVO_SAFETY           false    // true: paksa katup ke sudut TUTUP bila sensor error/suhu lewat batas
#define SENSOR_FAULT_MS        5000UL
#define TEMP_CUTOFF_C          180.0f   // NILAI AWAL: cek titik asap minyak
#define PID_CUTOFF_ENABLE      0        // rev 30: 0 = PID TANPA batas suhu (keputusan pengguna: ada E-stop
                                        // fisik). 1 = suhu >= TEMP_CUTOFF_C -> TAHAN AMAN (katup TUTUP).
                                        // E-stop HARUS memutus GAS (solenoid/keran), bukan hanya listrik.

// ---- PENANGANAN SENSOR SUHU (rev 15) ----
#define SENSOR_FILTER_ENABLE   1        // 0 = perilaku lama: gTemp = bacaan mentah (tanpa filter cascade/hold)
#define SENSOR_SAMPLE_MS       200UL    // periode baca MAX31855 (konversi internal ~100 ms)
#define SENSOR_PUBLISH_EVERY   5        // kirim ke web/logger & grafik LCD tiap 5 sampel = 1 Hz (seperti sebelumnya)
                                        // (minyak fisik tidak berubah 5 C dalam 200 ms)
#define SENSOR_HOLD_MS         3000UL   // tahan nilai tersaring terakhir maks selama ini saat error
// rev 26: CEK KEWAJARAN. Minyak tidak bisa berubah > SENSOR_MAX_RATE_C_S. Bacaan yang melompat lebih
// jauh dari (margin + laju x waktu sejak sampel wajar terakhir) = BACAAN SALAH (bukan suhu nyata):
// nilai terakhir DITAHAN dan PID TETAP HIDUP. Bila bacaan salah bertahan > SENSOR_HOLD_MS -> NAN,
// dan > SENSOR_FAULT_MS -> PID mati "sensor error" (tetap aman). Kenaikan nyata bertahap tetap lolos.
#define SENSOR_MAX_RATE_C_S    5.0f     // C per detik (pemanasan/ubi masuk jauh di bawah ini)
#define SENSOR_JUMP_MARGIN_C   2.0f     // toleransi noise + kuantisasi 0.25 C
#define SENSOR_REF_N           3        // rev 32: acuan baru sah setelah 3 sampel berturut-turut konsisten
#define SENSOR_RANGE_MIN_C    -20.0f    // di luar rentang ini = bacaan salah (mencegah sampah jadi acuan)
#define SENSOR_RANGE_MAX_C    450.0f
static_assert(SENSOR_HOLD_MS < SENSOR_FAULT_MS, "SENSOR_HOLD_MS harus < SENSOR_FAULT_MS (pengaman sensor)");

// ---- PID SUHU (rev 16) ----
#define PID_DEFAULT_KP     1.46f     // rev 24: PI konservatif step test 28 Okt (Ti 270 dtk). SEMENTARA:
#define PID_DEFAULT_KI     0.0054f   //   step test itu R^2 0.296 (tidak valid); ulangi step test lebih
                                     //   besar & lama. Ki lama 0.056 (Ti 34 dtk) terlalu cepat utk L ~80 dtk.
#define PID_DEFAULT_KD     0.0f      // mulai 0: derivatif memperbesar noise sensor
#define PID_DEFAULT_UMAX   100.0f    // rev 21: PID boleh memakai seluruh rentang TUTUP(-3)..BUKA(55)
                                     // (40% hanya sampai ~20 derajat). Bisa diturunkan dari web.
#define PID_SP_RAMP_C_S    0.15f     // laju maks perubahan setpoint efektif (C/dtk) = 9 C/menit
                                     // (simulasi model dugaan: ramp 0.30 -> overshoot ~7 C, 0.15 -> ~4 C)
#define PID_HOLD_C         10.0f     // rev 24: suhu >= setpoint + ini -> katup TUTUP, PID TETAP ON
#define PID_HOLD_HYST_C    3.0f      //   keluar dari tahan bila suhu <= setpoint + HOLD - HYST
                                     // PID baru MATI total bila suhu >= TEMP_CUTOFF_C (batas akhir)
#define PID_D_FILTER       0.8f      // filter derivatif orde-1 (0..1; makin besar makin halus)
// rev 34: FEEDFORWARD BEBAN KERIPIK (Uji Sistem). Saat keranjang mulai turun (tahap 4), keluaran
// ditambah FF = PID_FF_PCT * exp(-t / PID_FF_TAU_S). Sama untuk mode adaptif & konvensional.
// FF ditahan (= 0) selama suhu >= setpoint efektif dan dibatalkan saat TAHAN overshoot/PID mati.
// Simulasi plant terkalibrasi data 31 Okt (a 0.015 C/s per %, beban SP150 turun ke 137 C):
// suhu terendah 136.3 -> 142.2 C, IAE -29%, suhu maks +0.4 C (L 10 s); tetap aman pada L 30 s.
#define PID_FF_PCT         25.0f     // 0 = feedforward MATI
#define PID_FF_TAU_S       90.0f

// ---- ADAPTIVE PID (rev 17), hukum adaptasi SAMA dgn model Simulink (build_deep_fryer_model.m) ----
//   Kp(k) = min(Kp0 + lambda_p*|e(k)|,     max(Kp0, PID_KP_MAX))
//   Ki(k) = min(Ki0 + lambda_i*|e(k)|,     max(Ki0, PID_KI_MAX))
//   Kd(k) = min(Kd0 + lambda_d*|dT/dt|,    max(Kd0, PID_KD_MAX))   (dT/dt terfilter, C/dtk)
// e = setpoint EFEKTIF - suhu. Adaptif OFF (atau semua lambda = 0) = PID biasa (pembanding).
// Batas "max(K0, K_MAX)": adaptasi tidak pernah MENURUNKAN gain di bawah nilai dasar.
// Integral disimpan dalam satuan keluaran (I += Ki(k)*e*dt), BUKAN Ki(k)*sum(e) seperti di
// Simulink: perubahan Ki tidak menimbulkan loncatan keluaran (bentuk Simulink terbukti memicu
// umpan balik positif, lihat catatan FIX #2 di model).
// BATAS (dicek dgn Ms, model FOPDT dugaan K 1.9-4 C/%, tau 180-600 s, L 10-20 s, Ts 1 s):
//   Kp 6 / Ki 0.2 -> Ms 2.6..125 (TIDAK aman). Kp 3 / Ki 0.065 / Kd 5 -> Ms tidak lebih buruk
//   dari gain dasar (1.9/0.056). Ki paling cepat merusak kestabilan -> hampir tidak diadaptasi.
//   Catatan: gain dasar sendiri Ms 2.9-3.8 bila dead time ternyata ~20 s -> verifikasi step test.
#define PID_ADAPT_DEFAULT  true
#define PID_DEFAULT_LP     0.06f     // %/(C*C):  Kp = 1.9 -> 3.0 pada |e| ~ 18 C
#define PID_DEFAULT_LI     0.0f      // rev 24: Ki TIDAK diadaptasi (dead time ~80 dtk: Ki besar = overshoot)
#define PID_DEFAULT_LD     5.0f      // Kd naik saat suhu berubah cepat (|dT/dt| 1 C/dtk -> +5)
#define PID_KP_MAX         3.0f
#define PID_KI_MAX         0.065f
#define PID_KD_MAX         5.0f

// ---- SETPOINT SUHU (rev 12) ----
// Saat ini HANYA referensi untuk grafik web & logger; belum ada PID yang memakainya.
#define DEFAULT_SETPOINT_C     160.0f
// rev 29: setpoint BEBAS (tanpa batas min/maks). Pengaman: TEMP_CUTOFF_C (180 C) -> TAHAN AMAN.

// ---------------- OBJEK ----------------
Adafruit_MAX31855 thermocouple(PIN_MAX_CS);
TFT_eSPI tft = TFT_eSPI();
AccelStepper stepX(AccelStepper::DRIVER, PIN_X_STEP, PIN_X_DIR);
WebServer server(80);
WebSocketsServer ws(81);
Preferences prefs;

volatile float gTemp = NAN;
volatile bool  gTempFresh = false;
volatile uint32_t gLastValidMs = 0;
char gMsg[64] = "";
volatile uint8_t gFault = 0;
bool driversEnabled = false;                 // driver stepper X
int  spdX = DEFAULT_SPEED_X, accX = DEFAULT_ACCEL_X;
unsigned long lastStatus = 0;

volatile uint32_t gRaw = 0;
volatile uint32_t gTempSeq = 0;              // nomor urut sampel suhu (deteksi paket hilang)
volatile uint32_t gTempMs  = 0;              // millis() saat sampel suhu diambil
volatile float gSetpoint = DEFAULT_SETPOINT_C;
volatile float gTempRaw = NAN;               // bacaan mentah MAX31855 terakhir (NAN bila fault)
volatile bool  gTempHeld = false;            // true: gTemp = nilai ditahan (sensor error sesaat)
volatile uint32_t gErrCount = 0;             // jumlah sampel tidak valid (fault/lonjakan) sejak boot
// rev 32: penghitung per jenis (sejak boot) -> menunjukkan SUMBER masalah di web & logger
volatile uint32_t gCntFault = 0;             // fault termokopel dari MAX31855 (open/short GND/short VCC)
volatile uint32_t gCntFrame = 0;             // frame tidak sah (0x00000000, 0xFFFFFFFF, bit D17/D3 = 1)
volatile uint32_t gCntMismatch = 0;          // 2 pembacaan berturut-turut BERBEDA = data rusak di kabel SPI
volatile uint32_t gCntCj = 0;                // suhu cold junction (chip) di luar -20..85 C = frame rusak
volatile uint32_t gCntJump = 0;              // lompatan suhu mustahil (cek kewajaran rev 26)
volatile float    gCjTemp = NAN;             // suhu cold junction (suhu chip MAX31855), C
volatile bool  pidOn = false;                // PID suhu aktif (rev 16)
volatile bool  gUiForce = false;             // rev 22: paksa gambar ulang semua elemen LCD
volatile uint32_t gLcdResets = 0;            // rev 22: jumlah reset LCD sejak boot
volatile bool  gLcdResetReq = false;         // rev 23: permintaan reset LCD manual dari web (loop -> uiTask)
TaskHandle_t   gUiTask = nullptr;            // rev 22: untuk cek sisa stack uiTask
char gResetWhy[24] = "?";                    // rev 22: alasan reset/boot terakhir

// Snapshot sampel TERKIRIM (1 Hz) untuk PID (rev 16). Ditulis uiTask (core 0), dibaca loop()
// (core 1). volatile menjamin tiap nilai 32-bit utuh, tapi TIDAK menjamin suhu/waktu/flag
// berasal dari sampel yang sama -> dibaca/ditulis bersama di dalam critical section.
portMUX_TYPE gSnapMux = portMUX_INITIALIZER_UNLOCKED;
struct TempSnap { float t; uint32_t ms; bool held; };
TempSnap gPub = { NAN, 0, false };
TempSnap readPubSnap() {
  portENTER_CRITICAL(&gSnapMux);
  TempSnap s = gPub;
  portEXIT_CRITICAL(&gSnapMux);
  return s;
}

// servo state
int   svUsMin = DEFAULT_SERVO_US_MIN;
int   svUsMax = DEFAULT_SERVO_US_MAX;
int   svClosedDeg = DEFAULT_SERVO_CLOSED_DEG;
int   svOpenDeg   = DEFAULT_SERVO_OPEN_DEG;
volatile float svTargetDeg = DEFAULT_SERVO_CLOSED_DEG;
volatile float svCurDeg    = DEFAULT_SERVO_CLOSED_DEG;
volatile int   svRawUs     = 0;              // >0: mode tes pulsa mentah
volatile uint8_t svLock    = 0;              // 0 normal, 1 sensor error, 2 suhu lewat batas

// Baca frame mentah 32-bit MAX31855 (bus SPI bersama; hanya dari uiTask)
uint32_t maxReadRaw() {
  SPI.beginTransaction(SPISettings(1000000, MSBFIRST, SPI_MODE0));
  digitalWrite(PIN_MAX_CS, LOW);
  delayMicroseconds(2);
  uint32_t v = 0;
  for (int i = 0; i < 4; i++) v = (v << 8) | SPI.transfer(0x00);
  digitalWrite(PIN_MAX_CS, HIGH);
  SPI.endTransaction();
  return v;
}

// rev 32: dekode SATU frame MAX31855 dgn validasi lengkap (datasheet): D16 = fault, D17 & D3 selalu 0,
// D2..D0 = jenis fault, D31..D18 suhu termokopel (14 bit, 0.25 C), D15..D4 cold junction (12 bit,
// 0.0625 C). Library Adafruit readCelsius() hanya memeriksa D2..D0, sehingga frame rusak lolos
// sebagai suhu "sah" (mis. 200 C) dan 0x00000000 terbaca 0 C.
// Kode *code: 0 ok | 1/2/4 fault termokopel | 0x10 frame tidak sah | 0x40 cold junction tidak wajar
float maxDecode(uint32_t v, uint8_t* code) {
  *code = 0;
  if (v == 0x00000000UL || v == 0xFFFFFFFFUL || (v & 0x00020008UL)) { *code = 0x10; return NAN; }
  if (v & 0x00010000UL) { *code = (v & 0x7) ? (uint8_t)(v & 0x7) : 0x10; return NAN; }
  int16_t cj = (int16_t)((v >> 4) & 0x0FFF);
  if (cj & 0x0800) cj -= 0x1000;
  float cjC = cj * 0.0625f;
  gCjTemp = cjC;
  if (cjC < -20.0f || cjC > 85.0f) { *code = 0x40; return NAN; }
  int32_t t = (int32_t)((v >> 18) & 0x3FFF);
  if (t & 0x2000) t -= 0x4000;
  return t * 0.25f;
}

const char* rawDiag(uint32_t v) {
  if (v == 0x00000000UL) return "SO stuck LOW: cek VCC 3V3, GND, CS5, SO19";
  if (v == 0xFFFFFFFFUL) return "SO stuck HIGH/mengambang: SO19 atau CS5 tdk terhubung";
  if (v & 0x00020008UL)  return "frame tidak valid (bit17/bit3=1): noise atau wiring buruk";
  if (v & 0x00010000UL) {
    if (v & 1) return "FAULT: thermocouple LEPAS (open)";
    if (v & 2) return "FAULT: thermocouple short ke GND";
    if (v & 4) return "FAULT: thermocouple short ke VCC";
    return "FAULT (bit16=1)";
  }
  return "frame valid";
}

// ---------------- HALAMAN WEB ----------------
const char INDEX_HTML[] PROGMEM = R"rawliteral(
<!DOCTYPE html>
<html lang="id">
<head>
<meta charset="utf-8">
<meta name="viewport" content="width=device-width, initial-scale=1">
<title>Deep Fryer Monitor</title>
<style>
  body{font-family:system-ui,Arial,sans-serif;background:#111;color:#eee;margin:0;padding:12px;text-align:center}
  h1{font-size:18px;margin:4px 0;color:#aaa}
  h2{font-size:14px;margin:0 0 8px;color:#aaa;text-transform:uppercase;letter-spacing:1px}
  .box{background:#1b1b1b;border-radius:8px;padding:12px;margin:10px auto;max-width:640px}
  #temp{font-size:64px;font-weight:700;margin:4px 0}
  .ok{color:#4ade80}.err{color:#f87171}
  canvas{width:100%;height:160px;background:#151515;border-radius:6px}
  .grid{display:grid;grid-template-columns:repeat(auto-fit,minmax(120px,1fr));gap:8px}
  .led{padding:8px;border-radius:6px;font-size:13px;background:#222}
  .led b{display:block;font-size:12px;margin-top:4px}
  .led i{display:block;font-size:11px;color:#999;font-style:normal;margin-top:2px}
  .on{background:#4a1515;color:#f87171}.off{background:#12301c;color:#4ade80}.unk{background:#3a3210;color:#fbbf24}
  button{background:#2a2a2a;color:#eee;border:1px solid #444;border-radius:6px;padding:10px 6px;font-size:14px;margin:3px;min-width:56px}
  button:active{background:#444}
  .stop{background:#7f1d1d;border-color:#ef4444;font-weight:700;width:90%;padding:14px}
  .pos{font-size:20px;margin:6px 0}
  input{width:70px;background:#111;color:#eee;border:1px solid #444;border-radius:4px;padding:6px}
  input[type=range]{width:85%;padding:0}
  #log{font-size:12px;color:#fbbf24;min-height:16px;margin-top:6px}
  small{color:#777}
</style>
</head>
<body>
  <h1>Deep Fryer - Monitor &amp; Kontrol <small id="fw" style="color:#777">(firmware ?)</small></h1>
  <div id="bench" class="err" style="font-weight:700"></div>

  <div class="box">
    <h2>Suhu Minyak</h2>
    <div id="temp">--.- &deg;C</div>
    <div id="status" class="err">Menghubungkan...</div>
    <canvas id="c" width="640" height="160"></canvas>
    <div><small><span style="color:#4ade80">&#9473; suhu</span> &nbsp;
      <span style="color:#f59e0b">&#9476; setpoint</span></small></div>
    <div style="margin-top:6px">Setpoint: <b id="spv">--</b> &deg;C &nbsp;
      <input id="spin" type="text" inputmode="decimal" placeholder="mis. 160"
             onkeydown="if(event.key==='Enter')sendSp()">
      <button onclick="sendSp()">Set</button></div>
    <div><small>Cara uji: isi setpoint &rarr; Set &rarr; klik <b>PID ADAPTIF ON</b> atau <b>PID KONVENSIONAL ON</b> di kotak PID Suhu.</small></div>
    <small>Setpoint bebas, TANPA batas suhu otomatis (pakai E-stop bila perlu). Setpoint &gt; 200 &deg;C
    minta konfirmasi untuk mencegah salah ketik.</small>
  </div>

  <div class="box">
    <h2>PID Suhu</h2>
    <div class="pos"><span id="pids" class="err">PID mati</span>
      <small>&nbsp; keluaran <b id="pidu">0.0</b>% &nbsp; setpoint efektif <b id="pide">--</b> &deg;C</small></div>
    <button onclick="send('pidm,1')" style="font-size:1.1em">PID ADAPTIF ON</button>
    <button onclick="send('pidm,0')" style="font-size:1.1em">PID KONVENSIONAL ON</button>
    <button class="stop" onclick="send('pid,0')" style="font-size:1.1em;width:auto">STOP PID</button>
    <div style="margin-top:8px">
      Kp <input id="pkp" type="number" step="0.1" min="0" max="50">
      Ki <input id="pki" type="number" step="0.001" min="0" max="5">
      Kd <input id="pkd" type="number" step="0.1" min="0" max="200">
      Umax <input id="pum" type="number" step="1" min="5" max="100"> %
      <button onclick="pidSet()">Simpan</button></div>
    <div style="margin-top:8px">Mode: <b id="pada">--</b> &nbsp; <small>feedforward beban <b id="pff">0</b>%</small></div>
    <div style="margin-top:6px">
      &lambda;p <input id="plp" type="number" step="0.01" min="0" max="1">
      &lambda;i <input id="pli" type="number" step="0.0001" min="0" max="0.01">
      &lambda;d <input id="pld" type="number" step="0.5" min="0" max="50">
      <button onclick="pidLam()">Simpan &lambda;</button></div>
    <div style="margin-top:6px">Gain dipakai: Kp <b id="kpe">--</b> &nbsp; Ki <b id="kie">--</b> &nbsp; Kd <b id="kde">--</b></div>
    <small>Adaptive PID: Kp = Kp0 + &lambda;p&middot;|e|, Ki = Ki0 + &lambda;i&middot;|e|, Kd = Kd0 + &lambda;d&middot;|dT/dt|,
    dibatasi Kp &le; 3, Ki &le; 0,065, Kd &le; 5 (atau nilai dasar bila lebih besar). Kp/Ki/Kd di atas = nilai DASAR.</small><br>
    <small>u = Kp&middot;e + &int;Ki&middot;e + D (D pada pengukuran). Satuan: % bukaan per &deg;C. Ki = Kp/Ti.
    Setpoint diatur di kotak Suhu Minyak. Setpoint efektif naik bertahap 0,15 &deg;C/dtk.
    PID hanya MATI bila Anda menekan STOP PID / STOP. Konvensional = gain dasar tetap (tanpa adaptasi).
    Feedforward: saat Uji Sistem menurunkan keranjang, katup ditambah 25% yang meluruh (&tau; 90 dtk), hanya selama suhu &lt; setpoint. TAHAN (katup TUTUP, PID tetap ON, lanjut sendiri):
    suhu &ge; setpoint+10 &deg;C (lanjut di +7). Integral tidak pernah dinolkan: dibekukan saat TAHAN, diingat saat STOP, sensor error &gt;5 dtk, data suhu berhenti.
    Tidak ada batas suhu otomatis: gunakan E-stop (harus memutus gas).
    TUTUP = sudut terkecil hasil kalibrasi (di alat ini masih api kecil, bukan padam). Servo BUKAN pemutus gas:
    mematikan api tetap lewat keran/solenoid. Harus ada orang di dekat mesin.</small>
  </div>

  <div class="box">
    <h2>Servo Katup Gas</h2>
    <div class="pos">Sudut: <span id="sva">0</span>&deg;
      <small>(target <span id="svg">0</span>&deg; | &asymp; <span id="svp">0</span>% bukaan <span id="svr"></span>)</small><br>
      <small>Pulsa dikirim ke servo: <b id="svus">-</b> &micro;s (bila angka ini turun tapi servo tidak bergerak,
      servo sudah mentok secara mekanis)</small></div>
    <div id="svl" class="err" style="font-weight:700;min-height:18px"></div>
    <button onclick="send('sv,0')" style="font-size:1.2em">TUTUP (<span class="lcd">0</span>&deg;)</button>
    <button onclick="send('sv,100')" style="font-size:1.2em">BUKA (<span class="lod">55</span>&deg;)</button><br>
    <div style="margin-top:8px">Bukaan:
      <button onclick="send('sv,0')">0%</button>
      <button onclick="send('sv,25')">25%</button>
      <button onclick="send('sv,50')">50%</button>
      <button onclick="send('sv,75')">75%</button>
      <button onclick="send('sv,100')">100%</button></div>
    <div style="margin-top:8px">Sudut: <input id="sva_in" type="text" inputmode="text" placeholder="derajat"
        onkeydown="if(event.key==='Enter')svAngle()"> &deg; <button onclick="svAngle()">Gerak</button>
      &nbsp; <button onclick="send('svad,-1')">-1&deg;</button><button onclick="send('svad,1')">+1&deg;</button></div>
    <small>Manual (kotak sudut, -1/+1): -1..180&deg; (-1&deg; = sudut paling minimum).
    PID &amp; step test dikunci antara TUTUP (<span class="lcd">0</span>&deg;) dan BUKA (<span class="lod">55</span>&deg;).</small>

    <div style="margin-top:12px;border-top:1px solid #333;padding-top:8px;text-align:left">
      <b>Kalibrasi katup</b> (PID harus OFF, step test tidak berjalan)<br>
      Sudut uji: <input id="svk_in" type="text" inputmode="text" placeholder="-1..180"
        onkeydown="if(event.key==='Enter')svCalGo(0)"> &deg;
      <button onclick="svCalGo(0)">Gerak</button>
      <button onclick="svCalGo(-1)">-1&deg;</button><button onclick="svCalGo(1)">+1&deg;</button><br>
      <button onclick="send('svset,c')">Simpan sudut ini sbg TUTUP</button>
      <button onclick="send('svset,o')">Simpan sudut ini sbg BUKA</button><br>
      Tersimpan: TUTUP <b id="svcd">-</b>&deg;, BUKA <b id="svod">-</b>&deg;<br>
      Pulsa servo: 0&deg; = <input id="sumin" type="text" inputmode="numeric"> &micro;s,
      180&deg; = <input id="sumax" type="text" inputmode="numeric"> &micro;s
      <button onclick="svCalPulse()">Simpan pulsa</button><br>
      <small>Cara: gerakkan per 1&deg; ke arah menutup sampai api sekecil mungkin, lalu "Simpan sbg TUTUP".
      Sudut paling minimum -1&deg;. Berhenti di sudut terakhir yang servonya masih DIAM; bila berdengung/menekan
      stopper, naikkan 1&deg;. Api kecil di TUTUP harus tidak mampu menaikkan suhu (uji: minyak panas, TUTUP
      10 menit, suhu turun/diam). <b>PERINGATAN:</b> servo BUKAN pemutus gas; bila api di TUTUP sampai padam,
      gas keluar TANPA api saat katup membuka lagi. Harus ada orang di dekat mesin.</small>
    </div>
  </div>

  <div class="box">
    <h2>Uji Sistem (Kematangan)</h2>
    <div>Timer goreng: <input id="ujf" type="number" value="120" min="5" max="1800" step="5"> detik
      <button onclick="ujStart()" style="font-size:1.1em">MULAI UJI</button>
      <button class="stop" onclick="send('stop')" style="width:auto">STOP</button></div>
    <div id="ujs" class="pos" style="margin:6px 0">Siap.</div>
    <small>Urutan: Z naik ke Z Atas &rarr; X ke X Awal &rarr; tunggu suhu di setpoint &plusmn;3 &deg;C selama
    30 dtk &rarr; Z TURUN 50% sampai Z Bawah &rarr; timer &rarr; Z NAIK 60% sampai Z Atas &rarr; X ke X Akhir
    (berhenti di sana). PID dinyalakan otomatis dan tetap ON. Gerak tanpa batas waktu: berhenti oleh limit
    switch, jadi pastikan keempat limit berfungsi. STOP membatalkan uji (PID ikut mati).</small>
  </div>

  <div class="box">
    <h2>Step Test (open-loop)</h2>
    <div>Bukaan: <input id="stang" type="number" value="30" min="1" max="55" step="1"> &deg; (maks <span class="lod">55</span>)
      &nbsp; Batas suhu: <input id="stmax" type="number" value="170" min="60" max="175"> &deg;C
      &nbsp; Durasi: <input id="stdur" type="number" value="20" min="1" max="60"> menit</div>
    <button onclick="startStep()" style="font-size:1.1em">MULAI TEST</button>
    <button class="stop" onclick="send('stx')" style="width:auto">BATAL</button>
    <div id="sts" style="margin:6px 0">Siap.</div>
    <canvas id="sc" width="640" height="200"></canvas>
    <div id="sres" style="text-align:left;margin-top:6px;font-size:14px"></div>
    <small>Mulai dari minyak DINGIN dan stabil. Katup dibuka ke bukaan tetap; suhu direkam tiap 1 dtk
    oleh browser (jangan tutup/refresh halaman). Berhenti sendiri bila suhu mencapai batas atau waktu habis.
    Api menyala TANPA PID: harus ada orang di dekat mesin. Hasil Kp/Ki/Kd hanya USULAN awal.</small>
  </div>

  <div class="box" id="dcbox">
    <h2>Motor DC Z (BTS7960)</h2>
    <div class="pos">Keluaran: <span id="dcc">0</span>% <small>(target <span id="dct">0</span>%, rata-rata &asymp; <span id="dcv">0.0</span> V)</small></div>
    <input id="dcs" type="range" min="-100" max="100" value="0"
           oninput="$('dcsv').textContent=this.value" onchange="send('dcz,'+this.value)">
    <div>Slider: <span id="dcsv">0</span>% (positif = naik, negatif = turun)</div>
    <button onclick="send('dcz,-100')">Turun 100%</button>
    <button onclick="send('dcz,-50')">Turun 50%</button>
    <button onclick="send('dcz,-25')">Turun 25%</button><br>
    <button onclick="send('dcz,25')">Naik 25%</button>
    <button onclick="send('dcz,50')">Naik 50%</button>
    <button onclick="send('dcz,100')">Naik 100%</button><br>
    <button onclick="send('dcz,0')">Berhenti halus</button>
    <button class="stop" onclick="send('stop')">STOP SEKETIKA</button><br>
    <small>100% = rata-rata 12 V (duty dibatasi di firmware). Berhenti otomatis saat limit kena
    atau lewat batas waktu.<br>Pin: RPWM GPIO27, LPWM GPIO26, EN GPIO14 (arah belum diverifikasi).</small>
  </div>

  <div class="box">
    <h2>Cek Buzzer</h2>
    <button onclick="send('bz,1')">Bip pendek</button>
    <button onclick="send('bz,2')">Bip ganda</button>
    <button onclick="send('bz,3')">Bip panjang</button>
    <button onclick="send('bz,4')">Tes urutan</button>
    <button onclick="send('bz,0')">Diam</button><br>
    <small>Tes urutan: 3 bip pendek lalu 1 panjang.</small>
  </div>

  <div class="box">
    <h2>Limit Switch</h2>
    <div class="grid" id="leds"></div>
    <small>Kuning = belum terverifikasi (hanya tampil, tidak jadi pengaman).<br>
    GPIO mentah (H/L) ditampilkan untuk membantu identifikasi switch.</small>
  </div>

  <div class="box">
    <h2>Driver &amp; Kecepatan Stepper X</h2>
    <button id="enbtn" onclick="toggleEn()">Driver X: ?</button><br>
    <div>X: speed <input id="spdX" type="number" min="50" max="10000"> step/s
    accel <input id="accX" type="number" min="50" max="12000">
    <button onclick="setSA('X')">Set X</button></div>
  </div>

  <div id="cards"></div>

  <div class="box">
    <button class="stop" onclick="send('stop')">STOP SEMUA GERAK</button>
    <div id="log"></div>
  </div>
  <small id="info"></small><br>
  <small id="diag"></small><br>
  <button onclick="send('lcdr')">Reset LCD</button> <small>(LCD saat ini dimatikan di firmware)</small>
  <small>Pin RESET LCD + inisialisasi ulang + gambar ulang (~0,5 dtk). Pakai bila layar putih/membeku.</small>

<script>
  const MAXPTS = 120, data = [];
  const $ = id => document.getElementById(id);
  const cv = $('c'), g = cv.getContext('2d');
  let sock = null, enState = 0, ledsBuilt = false;

  function send(m){ if (sock && sock.readyState === 1) sock.send(m); else $('log').textContent='Belum terhubung'; }
  function setSA(ax){ send('spd,'+ax+','+$('spd'+ax).value); send('acc,'+ax+','+$('acc'+ax).value); clean(['spd'+ax,'acc'+ax]); }
  function toggleEn(){ send('en,' + (enState ? 0 : 1)); }
  function pidSet(){
    const k = ['pkp','pki','pkd','pum'].map(id => parseFloat($(id).value));
    if (k.some(x => !isFinite(x))) { $('log').textContent = 'Parameter PID tidak valid'; return; }
    // dibulatkan supaya perintah tidak melebihi panjang maksimum di firmware
    send('pidk,' + k[0].toFixed(3) + ',' + k[1].toFixed(5) + ',' + k[2].toFixed(3) + ',' + k[3].toFixed(1));
    clean(['pkp','pki','pkd','pum']);
  }
  // ---- servo & kalibrasi (rev 18) ----
  let svCd = 0, svOd = 55, svSg = 0;
  function num(id){ return parseFloat(String($(id).value).replace(',', '.')); }
  function svAngle(){
    const d = Math.round(num('sva_in'));
    if (!isFinite(d)) { $('log').textContent = 'Sudut tidak valid'; return; }
    send('sva,' + d); clean(['sva_in']);
  }
  function svCalGo(step){
    const now = Math.round(num('svk_in'));                 // dasar = isi kotak (langsung terbarui tiap klik)
    let d = step === 0 ? now : (isFinite(now) ? now : svSg) + step;
    if (!isFinite(d) || d < -1 || d > 180) { $('log').textContent = 'Sudut uji harus -1..180'; return; }
    $('svk_in').value = d; clean(['svk_in']);
    send('svk,' + d);
  }
  function svCalPulse(){
    const a = Math.round(num('sumin')), b = Math.round(num('sumax'));
    if (!isFinite(a) || !isFinite(b)) { $('log').textContent = 'Pulsa tidak valid'; return; }
    send('svcal,' + a + ',' + b); clean(['sumin','sumax']);
  }
  function pidLam(){
    const l = ['plp','pli','pld'].map(id => parseFloat($(id).value));
    if (l.some(x => !isFinite(x))) { $('log').textContent = 'Lambda tidak valid'; return; }
    send('pidl,' + l[0].toFixed(4) + ',' + l[1].toFixed(5) + ',' + l[2].toFixed(3));
    clean(['plp','pli','pld']);
  }
  function ujStart(){
    const f = parseInt($('ujf').value, 10);
    if (!(f >= 5 && f <= 1800)) { $('log').textContent = 'Timer 5-1800 detik'; return; }
    send('uj,' + f);
  }
  const UJ_TAHAP = {0:'Siap.', 1:'1/7 Z naik ke Z Atas', 2:'2/7 X ke X Awal', 3:'3/7 Menunggu suhu dekat setpoint',
    4:'4/7 Z TURUN', 5:'5/7 MENGGORENG', 6:'6/7 Z NAIK', 7:'7/7 X ke X Akhir', 8:'SELESAI (X di X Akhir)', 9:'DIBATALKAN'};
  function ujFeed(m){
    let s = UJ_TAHAP[m.uj] || ('tahap ' + m.uj);
    if (m.uj === 3) s += ' - di rentang ' + m.us + '/30 dtk';
    else if (m.uj === 5) s += ' - sisa ' + Math.floor(m.us / 60) + ':' + String(m.us % 60).padStart(2, '0');
    else if (m.uj >= 1 && m.uj <= 7) s += ' (' + m.us + ' dtk)';
    $('ujs').textContent = s;
    $('ujs').className = (m.uj === 9) ? 'pos err' : (m.uj === 8 ? 'pos ok' : 'pos');
  }
  function sendSp(){
    const v = parseFloat(String($('spin').value).replace(',', '.'));   // "160,5" juga diterima
    if (!isFinite(v)) { $('log').textContent = 'Setpoint harus berupa angka'; return; }   // rev 29: bebas
    // rev 30: bukan batas, hanya penangkal salah ketik (mis. 1600 untuk 160)
    if (v > 200 && !confirm('Setpoint ' + v + ' C (di atas 200 C). Yakin? Tidak ada batas suhu otomatis.')) return;
    send('sp,' + v.toFixed(1));
    clean(['spin']);
    $('log').textContent = 'Mengirim setpoint ' + v.toFixed(1) + ' C...';
  }

  // ---------- STEP TEST: rekam, gambar, identifikasi ----------
  let stPts = [], stRun = false, stFit = null;
  const SC = $('sc'), sg = SC.getContext('2d');

  function startStep(){
    const a = parseFloat($('stang').value), mx = parseFloat($('stmax').value), du = parseInt($('stdur').value);
    if (!isFinite(a) || !isFinite(mx) || !isFinite(du)) { $('log').textContent = 'Parameter step test tidak valid'; return; }
    stPts = []; stFit = null; $('sres').innerHTML = '';
    send('stt,' + a + ',' + mx + ',' + du);
  }

  function regress(p, i0, i1){            // regresi linear t -> T pada p[i0..i1-1]
    let n = i1 - i0, sx = 0, sy = 0, sxx = 0, sxy = 0, syy = 0;
    for (let i = i0; i < i1; i++) { const x = p[i][0], y = p[i][1]; sx += x; sy += y; sxx += x*x; sxy += x*y; syy += y*y; }
    const den = n*sxx - sx*sx;
    if (den === 0) return null;
    const s = (n*sxy - sx*sy) / den, a = (sy - s*sx) / n;
    const ssTot = syy - sy*sy/n;
    let ssRes = 0; for (let i = i0; i < i1; i++) { const e = p[i][1] - (a + s*p[i][0]); ssRes += e*e; }
    return {s: s, a: a, r2: ssTot > 0 ? 1 - ssRes/ssTot : 0};
  }

  function drawStep(){
    sg.clearRect(0,0,SC.width,SC.height);
    if (stPts.length < 2) return;
    const tmax = Math.max(60, stPts[stPts.length-1][0]);
    let lo = Infinity, hi = -Infinity;
    stPts.forEach(p => { lo = Math.min(lo, p[1]); hi = Math.max(hi, p[1]); });
    if (hi - lo < 5) { const m=(hi+lo)/2; lo=m-2.5; hi=m+2.5; }
    const X = t => 30 + t/tmax*(SC.width-40), Y = v => SC.height-14 - (v-lo)/(hi-lo)*(SC.height-28);
    sg.strokeStyle='#4ade80'; sg.lineWidth=2; sg.beginPath();
    stPts.forEach((p,i)=>{ if(i) sg.lineTo(X(p[0]),Y(p[1])); else sg.moveTo(X(p[0]),Y(p[1])); });
    sg.stroke();
    if (stFit){                              // garis singgung + garis dead time
      sg.strokeStyle='#f59e0b'; sg.setLineDash([6,4]); sg.beginPath();
      const t1 = Math.max(0, (lo - stFit.a)/stFit.s), t2 = Math.min(tmax, (hi - stFit.a)/stFit.s);
      sg.moveTo(X(t1), Y(stFit.a + stFit.s*t1)); sg.lineTo(X(t2), Y(stFit.a + stFit.s*t2));
      sg.stroke(); sg.setLineDash([]);
    }
    sg.fillStyle='#777'; sg.font='12px sans-serif';
    sg.fillText(hi.toFixed(1)+' C',2,12); sg.fillText(lo.toFixed(1)+' C',2,SC.height-2);
    sg.fillText(Math.round(tmax)+' s',SC.width-50,SC.height-2);
  }

  function analyzeStep(){
    const p = stPts, n = p.length;
    if (n < 30) { $('sres').textContent = 'Data terlalu sedikit (<30 detik): tidak bisa dianalisis.'; return; }
    // rev 24: jendela = 1/5 durasi (60..300 dtk). Jendela tetap 60 dtk memilih potongan curam akibat
    // noise -> kemiringan terlalu besar & dead time salah (uji: L asli 80 dtk terbaca 225 dtk).
    const W = Math.max(Math.min(60, Math.floor(n/2)), Math.min(300, Math.floor(n/5)));
    let best = null;
    for (let i = 0; i + W <= n; i++) {
      const f = regress(p, i, i + W);
      if (f && (best === null || f.s > best.s)) best = f;
    }
    if (!best || !(best.s > 0)) { $('sres').textContent = 'Suhu tidak naik: respons tidak valid (cek api/sensor).'; return; }
    const k = Math.min(5, n);
    let T0 = 0; for (let i = 0; i < k; i++) T0 += p[i][1]; T0 /= k;
    const rise = p[n-1][1] - T0;
    const L = (T0 - best.a) / best.s;                  // waktu garis singgung memotong T0 (dtk)
    const ang = parseFloat($('stang').value), u = (ang - svCd) / (svOd - svCd) * 100;   // % bukaan dari TUTUP..BUKA tersimpan
    const Kp_ = best.s / u;                            // gain proses: degC/dtk per % bukaan
    stFit = best; drawStep();
    let h = '<b>Hasil identifikasi</b><br>'
      + 'Kenaikan total: ' + rise.toFixed(1) + ' &deg;C dalam ' + p[n-1][0] + ' dtk (bukaan ' + ang + '&deg; = ' + u.toFixed(0) + '%)<br>'
      + 'Kemiringan maks R = ' + (best.s*60).toFixed(2) + ' &deg;C/menit (R&sup2; ' + best.r2.toFixed(3) + ', jendela ' + W + ' dtk)<br>';
    if (!(L > 0) || !isFinite(L)) {
      h += '<span class="err">Dead time tidak valid (L=' + L.toFixed(1) + ' dtk): kemungkinan awal data tidak bersih/api sudah menyala sebelum test.</span>';
      $('sres').innerHTML = h; return;
    }
    h += 'Dead time L = ' + L.toFixed(1) + ' dtk<br>';
    // rev 24: uji kelayakan. Hasil tidak layak -> Kp/Ki/Kd TIDAK ditampilkan.
    const dur = p[n-1][0], alasan = [];
    if (best.r2 < 0.9) alasan.push('R&sup2; ' + best.r2.toFixed(3) + ' &lt; 0,9 (garis tidak cocok dgn data)');
    if (rise < 10) alasan.push('kenaikan total ' + rise.toFixed(1) + ' &deg;C &lt; 10 &deg;C (terlalu kecil dibanding noise sensor)');
    if (best.s * W > Math.max(rise, 0) * 1.5 + 1) alasan.push('kemiringan maks tidak sesuai kenaikan total (noise/lonjakan)');
    if (dur < 3 * L) alasan.push('durasi ' + dur + ' dtk &lt; 3 &times; dead time (' + (3*L).toFixed(0) + ' dtk)');
    if (alasan.length) {
      h += '<div class="err" style="font-weight:700;margin-top:6px">HASIL TIDAK VALID - JANGAN pakai untuk tuning:<br>- '
        + alasan.join('<br>- ') + '<br>Ulangi: bukaan lebih besar (mis. 30-40%), tahan sampai suhu naik &ge; 20 &deg;C '
        + '(&ge; 20-40 menit), rekam dgn logger Python.</div>';
      $('sres').innerHTML = h; return;
    }
    const kZN = 1.2/(Kp_*L), tiZN = 2*L, tdZN = 0.5*L;
    const kPI = 0.9/(Kp_*L), tiPI = 3.33*L;
    h += '<br><b>Usulan awal (satuan: output % bukaan per &deg;C, waktu dtk)</b><br>'
      + 'PI konservatif: Kp = ' + kPI.toFixed(2) + ', Ti = ' + tiPI.toFixed(0) + ' dtk, Ki = ' + (kPI/tiPI).toFixed(4) + '/dtk<br>'
      + 'PID Z-N kurva reaksi: Kp = ' + kZN.toFixed(2) + ', Ti = ' + tiZN.toFixed(0) + ' dtk, Td = ' + tdZN.toFixed(0)
      + ' dtk, Ki = ' + (kZN/tiZN).toFixed(4) + ', Kd = ' + (kZN*tdZN).toFixed(2) + '<br>'
      + '<small>Peringatan: model integrator + dead time hanya berlaku di rentang suhu yang diuji; dead time mencakup '
      + 'lag sensor/probe; Z-N agresif (overshoot), mulai dari PI konservatif. Ulangi test bila R&sup2; &lt; 0,98 atau hasil aneh.</small>';
    $('sres').innerHTML = h;
  }

  function stepFeed(m){                    // dipanggil dari pesan 'temp'
    const names = {0:'Siap.', 1:'BERJALAN', 2:'SELESAI', 3:'BERHENTI (pengaman/batal)'};
    if (m.st === 1) {
      if (!stRun) { stRun = true; if (stPts.length && stPts[stPts.length-1][0] > m.te) stPts = []; }
      if (m.ok && m.t !== null && (stPts.length === 0 || m.te > stPts[stPts.length-1][0])) stPts.push([m.te, m.t]);
      $('sts').textContent = 'BERJALAN: ' + m.te + ' dtk' + (m.t !== null ? ', suhu ' + m.t.toFixed(1) + ' C' : '');
      drawStep();
    } else {
      if (stRun) { stRun = false; $('sts').textContent = names[m.st] || 'Selesai'; analyzeStep(); }
    }
  }

  function card(ax, name){
    const steps = [-5000,-1000,-200,-50,50,200,1000,5000];
    const btns = steps.map(s => '<button onclick="send(\'jog,'+ax+','+s+'\')">'+(s>0?'+':'')+s+'</button>').join('');
    return '<div class="box"><h2>Stepper '+name+'</h2>'
      + '<div class="pos">Posisi: <span id="pos_'+ax+'">0</span> step <small id="mv_'+ax+'"></small></div>'
      + '<div>Level pin DIR: <b id="dir_'+ax+'">?</b></div>'
      + btns + '<br><button onclick="send(\'jog,'+ax+',-1000000000\')">&#9664; Putar terus KIRI (-)</button>'
      + '<button onclick="send(\'jog,'+ax+',1000000000\')">Putar terus KANAN (+) &#9654;</button>'
      + '<br><button onclick="send(\'dir,'+ax+',0\')">DIR=LOW (tahan)</button><button onclick="send(\'dir,'+ax+',1\')">DIR=HIGH (tahan)</button>'
      + '</div>';
  }
  $('cards').innerHTML = card('X','X (Conveyor)');

  // data[i] = {t: suhu|null, sp: setpoint|null}; skala Y mencakup suhu DAN setpoint
  function draw(){
    g.clearRect(0,0,cv.width,cv.height);
    const v = [];
    data.forEach(p => { if (p.t !== null) v.push(p.t); if (p.sp !== null) v.push(p.sp); });
    if (v.length < 2) return;
    let lo = Math.min(...v), hi = Math.max(...v);
    if (hi - lo < 5) { const m=(hi+lo)/2; lo=m-2.5; hi=m+2.5; }
    const X = i => i*(cv.width/(MAXPTS-1));
    const Y = val => cv.height-10 - (val-lo)/(hi-lo)*(cv.height-20);
    function line(key, color, dash){
      g.strokeStyle=color; g.lineWidth=2; g.setLineDash(dash); g.beginPath();
      let started=false;
      data.forEach((p,i)=>{
        const val = p[key];
        if (val === null) { started=false; return; }
        if(!started){g.moveTo(X(i),Y(val));started=true;} else g.lineTo(X(i),Y(val));
      });
      g.stroke(); g.setLineDash([]);
    }
    line('sp', '#f59e0b', [6,4]);
    line('t',  '#4ade80', []);
    g.fillStyle='#777'; g.font='12px sans-serif';
    g.fillText(hi.toFixed(1)+' C',4,12); g.fillText(lo.toFixed(1)+' C',4,cv.height-2);
  }

  const NAMES = ['Z Atas','Z Bawah','X Awal','X Akhir'];
  function updLeds(m){
    if (!ledsBuilt){
      $('leds').innerHTML = NAMES.map((n,i)=>'<div class="led" id="led'+i+'">'+n+'<b></b><i></i></div>').join('');
      ledsBuilt = true;
    }
    for (let i=0;i<4;i++){
      const el = $('led'+i);
      const hit = m.ls[i], ver = m.vr[i];
      el.className = 'led ' + (!ver ? 'unk' : (hit ? 'on' : 'off'));
      el.querySelector('b').textContent = (hit ? 'KENA' : 'BEBAS') + (ver ? '' : ' (?)');
      el.querySelector('i').textContent = 'GPIO ' + m.pn[i] + ' = ' + (m.raw[i] ? 'H' : 'L') + (m.il[i] ? '' : ' | tanpa interlock');
    }
  }

  // Isian yang sudah diketik pengguna (dirty) TIDAK ditimpa status dari ESP sampai dikirim.
  // Dulu: klik tombol membuat isian kehilangan fokus sesaat, status (tiap 250 ms) menimpanya,
  // sehingga nilai LAMA yang terkirim -> setpoint/Kp "tidak bisa diubah".
  function setField(id, val){ const el=$(id); if (document.activeElement !== el && !el.dirty) el.value = val; }
  document.addEventListener('input', ev => { if (ev.target.tagName === 'INPUT' && ev.target.type !== 'range') ev.target.dirty = true; });
  function clean(ids){ ids.forEach(id => { $(id).dirty = false; }); }

  function onMsg(m){
    if (m.type === 'temp'){
      const sp = (typeof m.sp === 'number') ? m.sp : null;
      if (sp !== null) $('spv').textContent = sp.toFixed(1);
      if (m.ok && m.t !== null){
        $('temp').innerHTML = m.t.toFixed(1)+' &deg;C';
        if (m.held) { $('status').textContent='HELD: nilai ditahan (sensor error sesaat)'; $('status').className='err'; }
        else { $('status').textContent='Sensor OK'; $('status').className='ok'; }
        data.push({t: m.t, sp: sp});
      } else {
        $('temp').innerHTML='ERR';
        $('status').textContent='SENSOR ERROR: ' + ({1:'thermocouple LEPAS (open circuit)',2:'short ke GND',4:'short ke VCC',16:'frame data rusak (cek kabel SPI)',32:'data berubah saat dibaca (gangguan kabel SPI)',64:'suhu chip tidak wajar (frame rusak)'}[m.f] || 'tidak ada data (cek SCK/CS/SO & VCC 3V3)'); $('status').className='err'; data.push({t: null, sp: sp});
      }
      if (data.length > MAXPTS) data.shift();
      if (typeof m.st === 'number') stepFeed(m);
      if (typeof m.uj === 'number') ujFeed(m);
      if (typeof m.pe === 'number') {
        const TAHAN = {1:'overshoot', 2:'SENSOR ERROR', 3:'SUHU >= 180 C', 4:'DATA SUHU BERHENTI'};
        const MODE = (typeof m.am === 'number') ? (m.am ? ' ADAPTIF' : ' KONVENSIONAL') : '';
        $('pids').textContent = m.pe ? (m.ph ? 'PID' + MODE + ' AKTIF - TAHAN AMAN (' + (TAHAN[m.ph] || m.ph) + ', katup TUTUP)' : 'PID' + MODE + ' AKTIF') : 'PID mati';
        if (typeof m.pf === 'number') $('pff').textContent = m.pf.toFixed(1);
        $('pids').className = m.pe ? 'ok' : 'err';
        $('pidu').textContent = m.pu.toFixed(1);
        $('pide').textContent = (m.pe && typeof m.se === 'number') ? m.se.toFixed(1) : '--';
      }
      if (typeof m.kpe === 'number') {
        $('kpe').textContent = m.kpe.toFixed(3); $('kie').textContent = m.kie.toFixed(4); $('kde').textContent = m.kde.toFixed(3);
      }
      $('info').textContent = 'Uptime ' + m.up + ' s | MAX31855 raw ' + m.raw + ' | ' + m.d
        + (typeof m.ec === 'number' ? ' | error sensor: ' + m.ec : '')
        + (typeof m.tr === 'number' ? ' | mentah ' + m.tr.toFixed(2) + ' C' : (m.tr === null ? ' | mentah: -' : ''));
      draw();
    } else if (m.type === 'st'){
      updLeds(m);
      $('bench').textContent = m.bn ? 'MODE BENCH: pengaman limit & batas jog NONAKTIF' : '';
      $('pos_X').textContent = m.xp;
      $('mv_X').textContent = m.xm ? '(bergerak)' : '';
      $('dir_X').textContent = m.dx ? 'HIGH (GPIO 3.3V)' : 'LOW (GPIO 0V)';
      enState = m.en;
      $('enbtn').textContent = 'Driver X: ' + (m.en ? 'AKTIF (klik = matikan)' : 'MATI (klik = aktifkan)');
      setField('spdX', m.sx); setField('accX', m.ax);
      if (typeof m.sp === 'number') { $('spv').textContent = m.sp.toFixed(1); setField('spin', m.sp); }
      // Umax memakai key "pm"; "um" tetap pulsa servo 0 derajat (kotak tersembunyi sumin)
      if (typeof m.kp === 'number') { setField('pkp', m.kp); setField('pki', m.ki); setField('pkd', m.kd); setField('pum', m.pm); }
      if (typeof m.ad === 'number') {
        $('pada').textContent = m.ad ? 'PID ADAPTIF' : 'PID KONVENSIONAL (gain dasar tetap)'; $('pada').className = m.ad ? 'ok' : '';
        setField('plp', m.lp); setField('pli', m.li); setField('pld', m.ld);
      }

      // servo
      $('sva').textContent = m.sa; $('svg').textContent = m.sg;
      const span = m.od - m.cd;
      $('svp').textContent = span ? Math.round((m.sa - m.cd) / span * 100) : 0;
      $('svr').textContent = m.sr ? '| PULSA MENTAH ' + m.sr + ' us' : '';
      if (typeof m.fw === 'string') $('fw').textContent = '(firmware ' + m.fw + ')';
      if (typeof m.rr === 'string')                         // rev 22: diagnosa ketahanan
        $('diag').textContent = 'Boot terakhir: ' + m.rr + ' | heap min ' + m.hp + ' B | sisa stack LCD '
          + m.sk + ' B | reset LCD ' + m.lr + 'x'
          + (typeof m.wc === 'number' ? ' | klien WS ' + m.wc + '/' + m.wm : '')
          + (typeof m.nf === 'number' ? ' || SENSOR sejak boot: fault TC ' + m.nf + ', frame rusak ' + m.nb
             + ', baca-2x beda ' + m.nm + ', CJ aneh ' + m.nc + ', lompatan ' + m.nj
             + ' | suhu chip ' + (m.cj > -90 ? m.cj.toFixed(1) + ' C' : '-') : '');
      $('svus').textContent = m.sr ? m.sr : Math.round(m.um + (m.ux - m.um) * m.sa / 180);
      $('svcd').textContent = m.cd; $('svod').textContent = m.od;
      svCd = m.cd; svOd = m.od; svSg = m.sg;
      document.querySelectorAll('.lcd').forEach(el => el.textContent = m.cd);
      document.querySelectorAll('.lod').forEach(el => el.textContent = m.od);
      $('stang').max = m.od;
      setField('sva_in', m.sg); setField('svk_in', m.sg);
      setField('sumin', m.um); setField('sumax', m.ux);
      $('svl').textContent = m.sl == 1 ? 'TERKUNCI: sensor suhu bermasalah, katup dipaksa ke sudut TUTUP'
                           : m.sl == 2 ? 'TERKUNCI: suhu melewati batas ' + m.tc + ' C, katup dipaksa ke sudut TUTUP' : '';

      // motor DC Z
      $('dcc').textContent = m.dcc; $('dct').textContent = m.dct;
      $('dcv').textContent = (Math.abs(m.dcc) / 100 * (m.dcm / 100) * m.dcv).toFixed(1);
      if (document.activeElement !== $('dcs')) { $('dcs').value = m.dct; $('dcsv').textContent = m.dct; }
    } else if (m.type === 'msg'){
      $('log').textContent = m.text;
    }
  }

  function connect(){
    sock = new WebSocket('ws://' + location.hostname + ':81/');
    sock.onopen  = () => { $('status').textContent='Terhubung'; $('status').className='ok'; };
    sock.onclose = () => { $('status').textContent='Terputus, mencoba lagi...'; $('status').className='err'; setTimeout(connect,1500); };
    sock.onmessage = e => onMsg(JSON.parse(e.data));
  }
  connect();
</script>
</body>
</html>
)rawliteral";

// ---------------- LIMIT SWITCH ----------------
inline bool lsRaw(int i) { return digitalRead(LS[i].pin) == HIGH; }
inline bool lsHit(int i) { bool h = lsRaw(i); return LS[i].activeHigh ? h : !h; }

int limitIdx(char ax, int dir) {
  if (ax == 'Z') {
    bool toward = (dir > 0) ? Z_PLUS_TOWARD_ATAS : !Z_PLUS_TOWARD_ATAS;
    return toward ? LS_ZATAS : LS_ZBAWAH;
  } else {
    bool toward = (dir > 0) ? X_PLUS_TOWARD_AKHIR : !X_PLUS_TOWARD_AKHIR;
    return toward ? LS_XAKHIR : LS_XAWAL;
  }
}

bool limitBlocks(char ax, int dir) {
  if (BENCH_MODE) return false;
  int i = limitIdx(ax, dir);
  return LS[i].interlock && lsHit(i);
}
bool dirUnprotected(char ax, int dir) { if (BENCH_MODE) return false; return !LS[limitIdx(ax, dir)].interlock; }

// ---------------- UTIL ----------------
void sendMsg(const char* text) {
  strncpy(gMsg, text, sizeof(gMsg) - 1); gMsg[sizeof(gMsg) - 1] = 0;
  char b[160];
  snprintf(b, sizeof(b), "{\"type\":\"msg\",\"text\":\"%s\"}", text);
  ws.broadcastTXT(b);
  Serial.println(text);
}

void setDrivers(bool en) {                    // driver stepper X (TB6600)
  driversEnabled = en;
  bool level = EN_HIGH_MEANS_ENABLED ? en : !en;
  digitalWrite(PIN_X_EN, level ? HIGH : LOW);
}

void hardStop(AccelStepper& s) { s.setCurrentPosition(s.currentPosition()); }

void applySpeedAccel() {
  stepX.setMaxSpeed(spdX); stepX.setAcceleration(accX);
}

// ---------------- BUZZER (non-blocking, pola on/off bergantian dalam ms; 0 = akhir) ----------------
static const uint16_t BZ_PAT1[] = { 150, 0 };                                   // bip pendek
static const uint16_t BZ_PAT2[] = { 120, 120, 120, 0 };                         // bip ganda
static const uint16_t BZ_PAT3[] = { 800, 0 };                                   // bip panjang
static const uint16_t BZ_PAT4[] = { 100, 100, 100, 100, 100, 300, 600, 0 };     // tes: 3 pendek + 1 panjang
const uint16_t* bzPat = nullptr;
uint8_t  bzIdx = 0;
uint32_t bzNext = 0;

void buzzWrite(bool on) {
  digitalWrite(PIN_BUZZ, (on == BUZZER_ACTIVE_HIGH) ? HIGH : LOW);
}

void buzzInit() {
  pinMode(PIN_BUZZ, OUTPUT);
  buzzWrite(false);
}

void buzzPlay(int id) {
  switch (id) {
    case 1: bzPat = BZ_PAT1; break;
    case 2: bzPat = BZ_PAT2; break;
    case 3: bzPat = BZ_PAT3; break;
    case 4: bzPat = BZ_PAT4; break;
    default: bzPat = nullptr; buzzWrite(false); return;
  }
  bzIdx = 0;
  bzNext = millis();
}

void buzzerUpdate() {
  if (!bzPat) return;
  uint32_t now = millis();
  if ((int32_t)(now - bzNext) < 0) return;
  uint16_t d = bzPat[bzIdx];
  if (d == 0) { buzzWrite(false); bzPat = nullptr; return; }
  buzzWrite((bzIdx % 2) == 0);      // indeks genap = bunyi, ganjil = diam
  bzNext = now + d;
  bzIdx++;
}

// ---------------- MOTOR DC Z (BTS7960, PWM 20 kHz) ----------------
float        dcCur    = 0;        // keluaran terhaluskan, persen dari batas (-100..100)
volatile int dcTarget = 0;        // target persen (-100..100); positif = naik
uint32_t     dcRunStart = 0;
bool         dcLimitStop = false; // rev 33: true = gerak terakhir dihentikan limit (tahan pantulan kontak)
bool         dcNoTimeout = false; // rev 33: true = gerak Uji Sistem (berhenti oleh limit, tanpa batas waktu)

float dcCap() {                   // duty maksimum sebagai pecahan (RATED / SUPPLY, maks 1)
  float c = MOTOR_RATED_V / MOTOR_SUPPLY_V;
  return c > 1.0f ? 1.0f : c;
}

void dcPwmWrite(bool rSide, uint32_t duty) {
#if ESP_ARDUINO_VERSION_MAJOR >= 3
  ledcWrite(rSide ? PIN_DC_RPWM : PIN_DC_LPWM, duty);
#else
  ledcWrite(rSide ? DC_LEDC_CH_R : DC_LEDC_CH_L, duty);
#endif
}

void dcInit() {
  pinMode(PIN_DC_EN, OUTPUT);
  digitalWrite(PIN_DC_EN, LOW);            // EN LOW lebih dulu: motor lepas
#if ESP_ARDUINO_VERSION_MAJOR >= 3
  ledcAttach(PIN_DC_RPWM, DC_PWM_FREQ, DC_PWM_BITS);
  ledcAttach(PIN_DC_LPWM, DC_PWM_FREQ, DC_PWM_BITS);
#else
  ledcSetup(DC_LEDC_CH_R, DC_PWM_FREQ, DC_PWM_BITS);
  ledcSetup(DC_LEDC_CH_L, DC_PWM_FREQ, DC_PWM_BITS);
  ledcAttachPin(PIN_DC_RPWM, DC_LEDC_CH_R);
  ledcAttachPin(PIN_DC_LPWM, DC_LEDC_CH_L);
#endif
  dcPwmWrite(true, 0);
  dcPwmWrite(false, 0);
}

// tulis keluaran: hanya SATU sisi PWM yang aktif; sisi lain 0
void dcWrite(float pct) {
  if (pct == 0) { dcPwmWrite(true, 0); dcPwmWrite(false, 0); return; }
  float a = fabsf(pct) / 100.0f * dcCap();                    // 0..cap
  uint32_t duty = (uint32_t)(a * (float)((1UL << DC_PWM_BITS) - 1));
  bool useR = (pct > 0) ? DC_POS_USES_RPWM : !DC_POS_USES_RPWM;
  dcPwmWrite(!useR, 0);
  dcPwmWrite(useR, duty);
}

void dcStop() {                   // berhenti SEKETIKA
  dcTarget = 0; dcCur = 0;
  dcWrite(0);
}

void dcSetTarget(int pct) {
  pct = constrain(pct, -DC_MAX_PCT, DC_MAX_PCT);
  if (pct != 0 && limitBlocks('Z', pct > 0 ? 1 : -1)) {
    sendMsg("Ditolak: limit Z di arah itu sedang kena"); return;
  }
  dcTarget = pct;
  dcRunStart = millis();
  dcNoTimeout = false;
  dcLimitStop = false;
}

// dipanggil tiap loop; kerja tiap 10 ms
void dcUpdate() {
  static uint32_t last = 0;
  uint32_t now = millis();
  if (now - last < 10) return;
  float dt = (now - last) / 1000.0f;
  last = now;

  if (dcTarget != 0 && limitBlocks('Z', dcTarget > 0 ? 1 : -1)) {
    dcStop(); dcLimitStop = true; sendMsg("Limit Z kena: motor DC berhenti");
  }
  if (dcTarget != 0 && !dcNoTimeout && (now - dcRunStart) > DC_MAX_RUN_MS) {
    dcStop(); sendMsg("Batas waktu motor DC: berhenti"); buzzPlay(3);
  }

  float diff = (float)dcTarget - dcCur;
  float step = DC_RAMP_PCT_S * dt;
  float next = (fabsf(diff) <= step) ? (float)dcTarget : dcCur + (diff > 0 ? step : -step);
  if ((dcCur > 0 && next < 0) || (dcCur < 0 && next > 0)) next = 0;   // lewati 0 dulu
  dcCur = next;
  dcWrite(dcCur);

  bool active = (dcTarget != 0) || (dcCur != 0);
  digitalWrite(PIN_DC_EN, (active || DC_BRAKE_WHEN_IDLE) ? HIGH : LOW);
}

// ---------------- SERVO (LEDC langsung, 0-180 derajat) ----------------
void servoPwmBegin() {
#if ESP_ARDUINO_VERSION_MAJOR >= 3
  ledcAttach(PIN_SERVO, SERVO_FREQ_HZ, SERVO_PWM_BITS);
#else
  ledcSetup(SERVO_LEDC_CH, SERVO_FREQ_HZ, SERVO_PWM_BITS);
  ledcAttachPin(PIN_SERVO, SERVO_LEDC_CH);
#endif
}

void servoPwmWrite(uint32_t duty) {
#if ESP_ARDUINO_VERSION_MAJOR >= 3
  ledcWrite(PIN_SERVO, duty);
#else
  ledcWrite(SERVO_LEDC_CH, duty);
#endif
}

void servoWriteUs(float us) {
  us = constrain(us, (float)SERVO_US_ABS_MIN, (float)SERVO_US_ABS_MAX);
  uint32_t maxDuty = (1UL << SERVO_PWM_BITS) - 1;
  servoPwmWrite((uint32_t)(us / (1000000.0f / SERVO_FREQ_HZ) * maxDuty));
}

float servoUsFromDeg(float deg) {
  return (float)svUsMin + (float)(svUsMax - svUsMin) * deg / 180.0f;
}

bool servoPulseOk(int a, int b) {
  return a >= SERVO_US_ABS_MIN && a <= SERVO_US_ABS_MAX && b >= SERVO_US_ABS_MIN && b <= SERVO_US_ABS_MAX && abs(a - b) >= 200;
}

bool servoAnglesOk(int c, int o) {
  return c >= SERVO_CAL_MIN_DEG && o <= 180 && o - c >= SERVO_MIN_SPAN_DEG;
}

void servoSaveCal() {
  prefs.begin("fryer", false);
  prefs.putInt("usmin", svUsMin); prefs.putInt("usmax", svUsMax);
  prefs.putInt("cdeg", svClosedDeg); prefs.putInt("odeg", svOpenDeg);
  prefs.end();
}

void setServoAngle(float deg) {
  deg = constrain(deg, (float)svClosedDeg, (float)svOpenDeg);   // dikunci tutup..buka
  if (svLock && fabsf(deg - (float)svClosedDeg) > 0.5f) {
    sendMsg("Servo terkunci pengaman: hanya boleh ke sudut TUTUP"); return;
  }
  svRawUs = 0;
  svTargetDeg = deg;
}

// rev 20: gerak MANUAL (kotak sudut, -1/+1, kalibrasi). Tidak dikunci TUTUP..BUKA: boleh
// SERVO_CAL_MIN_DEG..180, asalkan pulsa tetap SERVO_US_ABS_MIN..MAX. PID & step test tetap memakai
// setServoAngle() yang dikunci TUTUP..BUKA. Saat PID/step test aktif, perintah manual sudah ditolak.
void setServoAngleManual(float deg) {
  if (deg < SERVO_CAL_MIN_DEG || deg > 180.0f) {
    char m[48]; snprintf(m, sizeof(m), "Sudut harus %d..180 derajat", SERVO_CAL_MIN_DEG); sendMsg(m); return;
  }
  float us = servoUsFromDeg(deg);
  if (us < SERVO_US_ABS_MIN || us > SERVO_US_ABS_MAX) {
    char m[64]; snprintf(m, sizeof(m), "Ditolak: pulsa %.0f us di luar %d-%d us", us, SERVO_US_ABS_MIN, SERVO_US_ABS_MAX);
    sendMsg(m); return;
  }
  if (svLock && fabsf(deg - (float)svClosedDeg) > 0.5f) {
    sendMsg("Servo terkunci pengaman: hanya boleh ke sudut TUTUP"); return;
  }
  svRawUs = 0;
  svTargetDeg = deg;
}

void setServoPct(int pct) {
  pct = constrain(pct, 0, 100);
  setServoAngle((float)svClosedDeg + (float)(svOpenDeg - svClosedDeg) * pct / 100.0f);
}

// dipanggil tiap loop; kerja tiap 20 ms: pengaman (opsional) + gerak + tulis PWM
void servoUpdate() {
  static uint32_t last = 0;
  uint32_t now = millis();
  if (now - last < 20) return;
  float dt = (now - last) / 1000.0f;
  last = now;

#if SERVO_SAFETY
  static bool overLatched = false;
  float t = gTemp;
  bool sensorBad = isnan(t) && (now - gLastValidMs > SENSOR_FAULT_MS);
  if (!isnan(t)) {
    if (t >= TEMP_CUTOFF_C) overLatched = true;
    else if (t <= TEMP_CUTOFF_C - 10.0f) overLatched = false;
  }
  uint8_t lock = sensorBad ? 1 : (overLatched ? 2 : 0);
  if (lock != svLock) {
    svLock = lock;
    if (lock) buzzPlay(3);
    if (lock == 1)      sendMsg("PENGAMAN: sensor suhu error, katup ke sudut TUTUP");
    else if (lock == 2) sendMsg("PENGAMAN: suhu melewati batas, katup ke sudut TUTUP");
    else                sendMsg("Kunci katup dilepas");
  }
  if (svLock) { svRawUs = 0; svTargetDeg = (float)svClosedDeg; }
#endif

  if (svRawUs > 0) { servoWriteUs((float)svRawUs); return; }

  float diff = svTargetDeg - svCurDeg;
  if (SERVO_SLEW_DEG_S <= 0.0f) {
    svCurDeg = svTargetDeg;
  } else {
    float step = SERVO_SLEW_DEG_S * dt;
    if (fabsf(diff) <= step) svCurDeg = svTargetDeg;
    else svCurDeg += (diff > 0 ? step : -step);
  }
  servoWriteUs(servoUsFromDeg(svCurDeg));
}

// ---------------- STEP TEST OPEN-LOOP (rev 14) ----------------
// stState: 0 siap, 1 berjalan, 2 selesai normal, 3 dihentikan pengaman/batal
#define ST_MAX_MIN       60
volatile uint8_t stState = 0;
float    stAngle = 30, stMaxC = 170;
uint32_t stDurMs = 0, stStartMs = 0;

uint32_t stElapsedS() { return (stState == 1) ? (millis() - stStartMs) / 1000UL : 0; }

void stepTestEnd(uint8_t newState, const char* why) {
  stState = newState;
  setServoAngle((float)svClosedDeg);          // katup ke TUTUP
  sendMsg(why);
  buzzPlay(newState == 2 ? 2 : 3);
}

void stepTestStart(float angle, float maxC, int durMin) {
  float t = gTemp;
  if (stState == 1) { sendMsg("Step test sudah berjalan"); return; }
  if (pidOn) { sendMsg("Step test ditolak: matikan PID dulu"); return; }
  if (isnan(t)) { sendMsg("Step test ditolak: sensor suhu tidak valid"); return; }
  if (svLock || svRawUs > 0) { sendMsg("Step test ditolak: servo terkunci/mode pulsa"); return; }
  if (!(angle > (float)svClosedDeg + 0.5f && angle <= (float)svOpenDeg)) {
    sendMsg("Step test ditolak: sudut harus di atas TUTUP dan maks BUKA"); return;
  }
  if (!(maxC >= 60.0f && maxC <= TEMP_CUTOFF_C - 5.0f)) {
    char m[64]; snprintf(m, sizeof(m), "Step test ditolak: batas suhu 60-%.0f C", TEMP_CUTOFF_C - 5.0f);
    sendMsg(m); return;
  }
  if (t >= maxC - 10.0f) { sendMsg("Step test ditolak: suhu awal terlalu dekat batas"); return; }
  if (durMin < 1 || durMin > ST_MAX_MIN) { sendMsg("Step test ditolak: durasi 1-60 menit"); return; }
  stAngle = angle; stMaxC = maxC;
  stDurMs = (uint32_t)durMin * 60000UL;
  stStartMs = millis();
  stState = 1;
  setServoAngle(angle);
  sendMsg("Step test MULAI");
}

void stepTestUpdate() {
  if (stState != 1) return;
  uint32_t now = millis();
  float t = gTemp;
  if (isnan(t) && (now - gLastValidMs) > SENSOR_FAULT_MS) { stepTestEnd(3, "Step test BERHENTI: sensor suhu error"); return; }
  if (!isnan(t) && t >= stMaxC)                           { stepTestEnd(3, "Step test BERHENTI: suhu mencapai batas"); return; }
  if ((now - stStartMs) >= stDurMs)                       { stepTestEnd(2, "Step test SELESAI"); return; }
}

// ---------------- PID SUHU (rev 16) ----------------
float pidKp = PID_DEFAULT_KP, pidKi = PID_DEFAULT_KI, pidKd = PID_DEFAULT_KD, pidUmax = PID_DEFAULT_UMAX;  // gain DASAR (Kp0, Ki0, Kd0)
bool  pidAdapt = PID_ADAPT_DEFAULT;                                       // rev 17: adaptif ON/OFF
float pidLp = PID_DEFAULT_LP, pidLi = PID_DEFAULT_LI, pidLd = PID_DEFAULT_LD;   // lambda_p, lambda_i, lambda_d
float pidKpEff = PID_DEFAULT_KP, pidKiEff = PID_DEFAULT_KI, pidKdEff = PID_DEFAULT_KD;  // gain yang SEDANG dipakai
float pidI = 0;                   // suku integral (persen bukaan)
float pidIMem = 0;                // rev 38: integral terakhir saat PID di-STOP, dipakai lagi saat PID ON
float pidOut = 0;                 // keluaran terakhir (persen bukaan, 0..Umax)
float pidSpEff = 0;               // setpoint efektif (dengan ramp)
float pidPrevT = 0, pidDf = 0;    // untuk derivatif pada pengukuran
bool  pidPrevValid = false;       // false setelah sampel NAN: derivatif diinisialisasi ulang
bool  pidHold = false;            // rev 24: overshoot -> katup ditahan TUTUP, PID tetap ON
// rev 27: PID HANYA dimatikan pengguna (PID OFF / STOP). Kondisi bahaya -> TAHAN AMAN: katup TUTUP,
// integral 0, PID TETAP ON, lanjut sendiri saat kondisi normal. Kode (JSON "ph"):
//   1 overshoot (>= sp + 10)   2 sensor error > 5 dtk   3 suhu >= 180 C   4 data suhu berhenti   5 setpoint > batas
uint8_t pidSafeWhy = 0;
uint32_t pidLastMs = 0;
bool     pidFfOn = false;         // rev 34: feedforward beban sedang berjalan
uint32_t pidFfMs = 0;             //   waktu mulai FF
float    pidFf = 0;               //   FF yang dipakai sampel terakhir (persen, untuk web/logger)

void pidFfStart() { if (PID_FF_PCT > 0 && pidOn) { pidFfOn = true; pidFfMs = millis(); } }
void pidFfCancel() { pidFfOn = false; pidFf = 0; }

float servoOpeningPct() {         // bukaan servo sekarang (target) dalam persen TUTUP..BUKA
  float span = (float)(svOpenDeg - svClosedDeg);
  return span > 0 ? constrain(((float)svTargetDeg - (float)svClosedDeg) / span * 100.0f, 0.0f, 100.0f) : 0.0f;
}

void pidAdaptGains(float e, float dTdt);   // didefinisikan di bawah

void pidDisable(const char* why) {
  bool was = pidOn;
  if (pidOn) pidIMem = pidI;                 // rev 38: integral DIINGAT (tidak dibuang) untuk PID ON berikutnya
  pidOn = false; pidOut = 0;
  pidFfCancel();
  pidAdaptGains(0.0f, 0.0f);                 // rev 17: gain dipakai kembali = gain dasar
  setServoAngle((float)svClosedDeg);         // katup ke TUTUP (api minimum hasil kalibrasi)
  if (was && why) { sendMsg(why); buzzPlay(3); }
}

// rev 27: TAHAN AMAN (pengganti pidDisable otomatis). Pesan & buzzer hanya saat masuk/ganti alasan.
void pidSafeEnter(uint8_t why, const char* msg) {
  if (pidSafeWhy != why) { pidSafeWhy = why; sendMsg(msg); buzzPlay(3); }
  pidOut = 0; pidPrevValid = false;          // rev 38: integral DIBEKUKAN (dulu dinolkan), lanjut saat normal
  pidFfCancel();
  setServoAngle((float)svClosedDeg);         // katup TUTUP (api minimum)
}

void pidSafeExit(float T, uint32_t ms) {
  pidSafeWhy = 0;
  pidSpEff = T;                              // setpoint efektif mulai lagi dari suhu sekarang (tanpa loncatan)
  pidLastMs = ms;
  sendMsg("Kondisi normal: kontrol PID lanjut");
}

// rev 17: hukum adaptasi (lihat blok ADAPTIVE PID di konfigurasi). Adaptif OFF -> gain dasar.
void pidAdaptGains(float e, float dTdt) {
  if (!pidAdapt) { pidKpEff = pidKp; pidKiEff = pidKi; pidKdEff = pidKd; return; }
  pidKpEff = fminf(pidKp + pidLp * fabsf(e),    fmaxf(pidKp, PID_KP_MAX));
  pidKiEff = fminf(pidKi + pidLi * fabsf(e),    fmaxf(pidKi, PID_KI_MAX));
  pidKdEff = fminf(pidKd + pidLd * fabsf(dTdt), fmaxf(pidKd, PID_KD_MAX));
}

// rev 28: PID ON SELALU berhasil (dulu ditolak 7 syarat: sensor tidak valid/HELD, suhu >= 175,
// setpoint > 165, step test, servo terkunci). Kondisi yang tidak aman -> langsung TAHAN AMAN
// (katup TUTUP, PID tetap ON) dan berjalan sendiri saat normal, sama seperti rev 27.
void pidEnable() {
  if (pidOn) { sendMsg("PID sudah aktif"); return; }
  if (stState == 1) stepTestEnd(3, "Step test dihentikan: PID dinyalakan");
  svRawUs = 0;                                // keluar dari mode pulsa mentah (bila ada)
  TempSnap s = readPubSnap();
  float t = s.t;
  pidHold = false;
  pidSafeWhy = 0;
  pidAdaptGains(0.0f, 0.0f);                  // gain efektif = gain dasar saat start
  // rev 38: integral awal = integral terakhir sebelum STOP (bukaan tunak), atau bukaan katup sekarang
  // bila lebih besar. Dulu = bukaan katup saja, yang setelah STOP selalu 0% -> PID butuh menit-an
  // untuk membangun ulang bukaan tunak (~10%) dgn Ki kecil.
  pidI = constrain(fmaxf(servoOpeningPct(), pidIMem), 0.0f, pidUmax);
  pidOut = pidI;
  pidDf = 0;
  pidLastMs = s.ms;
  pidOn = true;
  if (isnan(t) || s.held) {                   // sensor belum bisa dipercaya: tunggu, katup TUTUP
    pidSpEff = gSetpoint;
    pidSafeEnter(2, "PID AKTIF - TAHAN AMAN: sensor belum valid, katup TUTUP");
    return;
  }
  pidSpEff = t;                               // ramp dimulai dari suhu sekarang
  pidPrevT = t; pidPrevValid = true;
#if PID_CUTOFF_ENABLE
  if (t >= TEMP_CUTOFF_C) {
    pidSafeEnter(3, "PID AKTIF - TAHAN AMAN: suhu >= 180 C, katup TUTUP");
    return;
  }
#endif
  sendMsg("PID AKTIF");
}

// Dipanggil SEKALI per sampel suhu TERKIRIM (gTempFresh, 1 Hz). dt dari waktu sampel (gPub.ms).
void pidUpdate() {
  if (!pidOn) return;
  TempSnap s = readPubSnap();
  float T = s.t;
  uint32_t nowMs = millis();
  if (isnan(T)) {                             // sampel buruk: tahan keluaran; TAHAN AMAN bila terlalu lama
    pidPrevValid = false;
    if (nowMs - gLastValidMs > SENSOR_FAULT_MS)
      pidSafeEnter(2, "SENSOR ERROR: katup TUTUP, PID tetap ON (lanjut saat sensor normal)");
    return;
  }
  // rev 27: tidak ada yang mematikan PID otomatis. rev 30: batas suhu hanya bila PID_CUTOFF_ENABLE 1
#if PID_CUTOFF_ENABLE
  if (T >= TEMP_CUTOFF_C) { pidSafeEnter(3, "SUHU >= 180 C: katup TUTUP, PID tetap ON"); return; }
#endif
  if (pidSafeWhy) {                           // keluar dari TAHAN AMAN hanya dgn pengukuran baru yang wajar
    if (s.held) return;
    if (pidSafeWhy == 3 && T > TEMP_CUTOFF_C - 5.0f) { setServoAngle((float)svClosedDeg); return; }
    pidSafeExit(T, s.ms);
    return;
  }

  float dt = (float)(s.ms - pidLastMs) / 1000.0f;
  pidLastMs = s.ms;
  if (dt < 0.05f || dt > 5.0f) dt = 1.0f;

  // ramp setpoint efektif (tetap jalan saat HELD: hanya bergantung waktu)
  float tgt = gSetpoint, stp = PID_SP_RAMP_C_S * dt;
  if (fabsf(tgt - pidSpEff) <= stp) pidSpEff = tgt; else pidSpEff += (tgt > pidSpEff ? stp : -stp);

  if (s.held) return;                         // nilai ditahan = bukan pengukuran baru: I & D beku, keluaran tetap

  // rev 24: OVERSHOOT -> katup ditahan TUTUP (api minimum), PID TETAP ON.
  // rev 37: integral DIBEKUKAN (dulu dinolkan). Data 31 Okt-1 Nov: setelah tiap TAHAN suhu jatuh
  // 7-18 C di bawah SP karena integral (= bukaan tunak ~10%) harus dibangun ulang dari 0 dgn Ki kecil.
  // Simulasi plant terkalibrasi: IAE -58..-89%, suhu maks tidak bertambah (L 10 & 30 s).
  // TUTUP (-3 derajat) = api sangat kecil yang tidak menaikkan suhu, jadi aman ditahan di sini.
  if (!pidHold && T >= gSetpoint + PID_HOLD_C) {
    pidHold = true;
    sendMsg("Overshoot: katup TUTUP sementara, PID tetap ON");
    buzzPlay(1);
  } else if (pidHold && T <= gSetpoint + PID_HOLD_C - PID_HOLD_HYST_C) {
    pidHold = false;
    sendMsg("Suhu turun: kontrol PID normal lagi");
  }
  if (pidHold) {
    pidOut = 0;                               // rev 37: pidI TIDAK dinolkan (beku), dipakai lagi saat lanjut
    pidFfCancel();
    pidPrevT = T; pidDf = 0;
    pidAdaptGains(pidSpEff - T, 0.0f);
    setServoAngle((float)svClosedDeg);
    return;
  }

  float e = pidSpEff - T;
  if (!pidPrevValid) { pidPrevT = T; pidDf = 0; pidPrevValid = true; }   // cegah lonjakan D setelah gangguan
  float dRaw = (T - pidPrevT) / dt; pidPrevT = T;
  pidDf = PID_D_FILTER * pidDf + (1.0f - PID_D_FILTER) * dRaw;

  pidAdaptGains(e, pidDf);                    // rev 17: Kp/Ki/Kd efektif dari |e| dan |dT/dt|
  pidFf = 0;                                  // rev 34: feedforward beban (lihat PID_FF_PCT)
  if (pidFfOn) {
    float tf = (float)(int32_t)(s.ms - pidFfMs) / 1000.0f;   // bertanda: sampel bisa sedikit lebih tua dari mulai FF
    if (tf < 0.0f) tf = 0.0f;
    if (tf > 5.0f * PID_FF_TAU_S) pidFfOn = false;
    else if (T < pidSpEff) pidFf = PID_FF_PCT * expf(-tf / PID_FF_TAU_S);
  }
  float uUnsat = pidKpEff * e + pidI - pidKdEff * pidDf + pidFf;
  float u = constrain(uUnsat, 0.0f, pidUmax);
  bool windup = (uUnsat > pidUmax && e > 0) || (uUnsat < 0.0f && e < 0);     // integrasi bersyarat
  if (!windup) pidI = constrain(pidI + pidKiEff * e * dt, 0.0f, pidUmax);
  pidOut = u;
  setServoAngle((float)svClosedDeg + (float)(svOpenDeg - svClosedDeg) * u / 100.0f);
}

// Tiap loop: PID mati bila tidak ada sampel suhu terkirim > SENSOR_FAULT_MS (mis. uiTask/SPI macet).
// Tanpa ini pidUpdate() tidak pernah dipanggil lagi dan katup tetap pada bukaan terakhir.
void pidWatchdog() {
  if (!pidOn) return;
  TempSnap s = readPubSnap();
  if (millis() - s.ms > SENSOR_FAULT_MS)          // rev 27: TAHAN AMAN, PID tetap ON
    pidSafeEnter(4, "DATA SUHU BERHENTI: katup TUTUP, PID tetap ON");
}

void pidSave() {
  prefs.begin("fryer", false);
  prefs.putFloat("pkp", pidKp); prefs.putFloat("pki", pidKi);
  prefs.putFloat("pkd", pidKd); prefs.putFloat("pum", pidUmax);
  prefs.putFloat("plp", pidLp); prefs.putFloat("pli", pidLi); prefs.putFloat("pld", pidLd);
  prefs.putBool("pad", pidAdapt);
  prefs.end();
}

bool pidParamsOk(float kp, float ki, float kd, float um) {
  return isfinite(kp) && isfinite(ki) && isfinite(kd) && isfinite(um) &&
         kp >= 0 && kp <= 50 && ki >= 0 && ki <= 5 && kd >= 0 && kd <= 200 && um >= 5 && um <= 100;
}

bool pidLambdaOk(float lp, float li, float ld) {
  return isfinite(lp) && isfinite(li) && isfinite(ld) &&
         lp >= 0 && lp <= 1 && li >= 0 && li <= 0.01f && ld >= 0 && ld <= 50;
}

// ---------------- PENGAMAN STEPPER X (tiap loop) ----------------
// ---------------- UJI SISTEM / UJI KEMATANGAN (rev 33) ----------------
// Urutan: 1 Z naik ke Z Atas -> 2 X ke X Awal -> 3 tunggu suhu di SP-3..SP+3 selama 30 dtk
// berturut-turut -> 4 Z turun (50%) sampai Z Bawah -> 5 goreng (timer, default 2 menit) ->
// 6 Z naik (60%) sampai Z Atas -> 7 X ke X Akhir -> 8 SELESAI (X tetap di X Akhir).
// Gerak Z/X TANPA batas waktu: berhenti oleh limit switch. Tombol STOP membatalkan (9).
// PID dinyalakan otomatis saat mulai dan tetap ON setelah selesai.
#define UJ_BAND_LO_C      3.0f      // batas bawah "dekat setpoint" = SP - 3
#define UJ_BAND_HI_C      3.0f      // batas atas = SP + 3 (contoh SP 160 -> 157..163); rev 36: dulu +7
#define UJ_STABLE_MS      30000UL   // lama suhu harus di dalam rentang (berturut-turut); rev 35: 10 -> 30 dtk
#define UJ_PCT_DOWN       50        // kecepatan Z turun (persen)
#define UJ_PCT_UP         60        // kecepatan Z naik (persen); rev 36: dulu 55 (kurang kuat)
#define UJ_FRY_DEFAULT_S  120       // timer goreng default (detik)
#define UJ_FRY_MIN_S      5
#define UJ_FRY_MAX_S      1800
#define UJ_X_FAR          1000000000L   // "jauh sekali": X berhenti oleh limit
volatile uint8_t ujState = 0;       // 0 siap, 1..7 berjalan, 8 selesai, 9 dibatalkan
uint32_t ujFryMs = UJ_FRY_DEFAULT_S * 1000UL;
uint32_t ujT0 = 0;                  // awal tahap sekarang
uint32_t ujInBandMs = 0;            // awal suhu masuk rentang (0 = di luar)
bool     xLimitStop = false;        // gerak X terakhir dihentikan limit (tahan pantulan kontak)

bool ujRunning() { return ujState >= 1 && ujState <= 7; }

// detik untuk web/logger: tahap 3 = lama suhu di rentang, tahap 5 = SISA timer, lainnya = lama tahap
long ujSecs() {
  uint32_t now = millis();
  if (ujState == 3) return ujInBandMs ? (long)((now - ujInBandMs) / 1000UL) : 0;
  if (ujState == 5) { uint32_t el = now - ujT0; return el >= ujFryMs ? 0 : (long)((ujFryMs - el + 999UL) / 1000UL); }
  if (ujRunning()) return (long)((now - ujT0) / 1000UL);
  return 0;
}

void ujEnd(uint8_t st, const char* why) {
  dcStop(); hardStop(stepX);
  ujState = st;
  sendMsg(why);
  buzzPlay(st == 8 ? 2 : 3);
}

void ujMoveX(int dir) {             // dir +1 = ke X Akhir, -1 = ke X Awal
  if (!driversEnabled) setDrivers(true);
  long s = X_PLUS_TOWARD_AKHIR ? UJ_X_FAR : -UJ_X_FAR;
  xLimitStop = false;
  stepX.move(dir > 0 ? s : -s);
}

void ujMoveZ(int pct) { dcSetTarget(pct); dcNoTimeout = true; }

void ujEnter(uint8_t st) {
  ujState = st; ujT0 = millis();
  switch (st) {
    case 1: if (!lsHit(LS_ZATAS)) { ujMoveZ(UJ_PCT_UP); sendMsg("Uji: Z naik ke Z Atas"); } break;
    case 2: if (!lsHit(LS_XAWAL)) { ujMoveX(-1); sendMsg("Uji: X ke X Awal"); } break;
    case 3: ujInBandMs = 0; sendMsg("Uji: menunggu suhu dekat setpoint (30 dtk)"); break;
    case 4: ujMoveZ(-UJ_PCT_DOWN); pidFfStart(); sendMsg("Uji: Z TURUN"); break;
    case 5: buzzPlay(1); sendMsg("Uji: Z Bawah kena - TIMER GORENG mulai"); break;
    case 6: buzzPlay(1); ujMoveZ(UJ_PCT_UP); sendMsg("Uji: timer habis - Z NAIK"); break;
    case 7: ujMoveX(1); sendMsg("Uji: X ke X Akhir"); break;
  }
}

void ujStart(int fryS) {
  if (ujRunning()) { sendMsg("Uji sistem sudah berjalan"); return; }
  if (BENCH_MODE) { sendMsg("Uji ditolak: BENCH_MODE aktif (limit tidak mengamankan)"); return; }
  if (fryS < UJ_FRY_MIN_S || fryS > UJ_FRY_MAX_S) { sendMsg("Uji ditolak: timer 5-1800 detik"); return; }
  if (stState == 1) { sendMsg("Uji ditolak: step test sedang berjalan"); return; }
  if (lsHit(LS_ZATAS) && lsHit(LS_ZBAWAH)) { sendMsg("Uji ditolak: Z Atas & Z Bawah kena bersamaan (cek kabel)"); return; }
  if (lsHit(LS_XAWAL) && lsHit(LS_XAKHIR)) { sendMsg("Uji ditolak: X Awal & X Akhir kena bersamaan (cek kabel)"); return; }
  ujFryMs = (uint32_t)fryS * 1000UL;
  if (!pidOn) pidEnable();
  sendMsg("Uji sistem MULAI");
  ujEnter(1);
}

void ujUpdate() {
  if (!ujRunning()) return;
  uint32_t now = millis();
  switch (ujState) {
    case 1: case 6:                                    // Z naik sampai Z Atas
      if (lsHit(LS_ZATAS) || dcLimitStop) { dcStop(); ujEnter(ujState == 1 ? 2 : 7); }
      else if (dcTarget <= 0) ujEnd(9, "Uji DIBATALKAN: gerak Z naik terhenti");
      break;
    case 4:                                            // Z turun sampai Z Bawah
      if (lsHit(LS_ZBAWAH) || dcLimitStop) { dcStop(); ujEnter(5); }
      else if (dcTarget >= 0) ujEnd(9, "Uji DIBATALKAN: gerak Z turun terhenti");
      break;
    case 2: case 7: {                                  // X sampai limit
      int li = (ujState == 2) ? LS_XAWAL : LS_XAKHIR;
      if (lsHit(li) || xLimitStop) { hardStop(stepX); if (ujState == 2) ujEnter(3); else ujEnd(8, "Uji sistem SELESAI (X di X Akhir)"); }
      else if (stepX.distanceToGo() == 0) ujEnd(9, "Uji DIBATALKAN: gerak X terhenti");
      break; }
    case 3: {                                          // tunggu suhu dekat setpoint
      float t = gTemp, sp = gSetpoint;
      bool in = !isnan(t) && t >= sp - UJ_BAND_LO_C && t <= sp + UJ_BAND_HI_C;
      if (!in) ujInBandMs = 0;
      else if (!ujInBandMs) ujInBandMs = now ? now : 1;
      else if (now - ujInBandMs >= UJ_STABLE_MS) ujEnter(4);
      break; }
    case 5:
      if (now - ujT0 >= ujFryMs) ujEnter(6);
      break;
  }
}

void enforceSafety() {
  long dx = stepX.distanceToGo();
  if (dx != 0 && limitBlocks('X', dx > 0 ? 1 : -1)) { hardStop(stepX); xLimitStop = true; sendMsg("Limit X kena: gerak dihentikan"); }
}

// ---------------- PERINTAH DARI WEB ----------------
void handleCommand(const char* cmd) {
  char ax; long steps; int v, a, b;

  // ---- rev 33: Uji Sistem "uj,<detik goreng>". Selama uji, gerak manual Z/X ditolak.
  if (sscanf(cmd, "uj,%d", &v) == 1) { ujStart(v); return; }
  if (ujRunning() && (strncmp(cmd, "jog,", 4) == 0 || strncmp(cmd, "dcz,", 4) == 0 || strncmp(cmd, "en,", 3) == 0
                      || strncmp(cmd, "stt,", 4) == 0 || strncmp(cmd, "dir,", 4) == 0)) {
    sendMsg("Uji sistem berjalan: gerak manual ditolak (STOP untuk batal)"); return;
  }
  if (sscanf(cmd, "jog,%c,%ld", &ax, &steps) == 2) {
    if (ax == 'Z') { sendMsg("Z = motor DC: pakai kotak Motor DC Z"); return; }
    if (ax != 'X') { sendMsg("Axis tidak dikenal"); return; }
    if (!driversEnabled) { sendMsg("Aktifkan driver X dulu"); return; }
    if (steps == 0 || labs(steps) > MAX_JOG_STEPS) { sendMsg("Jumlah step tidak valid"); return; }
    int dir = steps > 0 ? 1 : -1;
    if (limitBlocks('X', dir)) { sendMsg("Ditolak: limit di arah itu sedang kena"); return; }
    if (dirUnprotected('X', dir) && labs(steps) > MAX_JOG_UNVERIFIED) {
      sendMsg("Arah ini TANPA pengaman limit (tdk terverifikasi): jog dibatasi kecil"); return;
    }
    stepX.move(steps);
    return;
  }
  if (sscanf(cmd, "dir,%c,%d", &ax, &v) == 2) {
    if (ax != 'X') { sendMsg("Hanya axis X yang punya pin DIR"); return; }
    if (stepX.distanceToGo() != 0) { sendMsg("Axis sedang bergerak: STOP dulu"); return; }
    digitalWrite(PIN_X_DIR, v ? HIGH : LOW);
    sendMsg(v ? "DIR X ditahan HIGH" : "DIR X ditahan LOW");
    return;
  }
  if (strcmp(cmd, "stop") == 0) {
    hardStop(stepX); dcStop();
    if (ujRunning()) ujEnd(9, "Uji sistem DIBATALKAN (STOP)");
    bool hadPid = pidOn;
    if (hadPid) pidDisable("PID MATI (STOP): katup ke TUTUP");
    if (stState == 1) { stepTestEnd(3, "Step test DIBATALKAN (STOP)"); return; }
    if (!hadPid) sendMsg("Semua gerak dihentikan");   // pesan PID tidak ditimpa
    return;
  }
  // ---- rev 23: "lcdr" reset LCD manual. Hanya memasang flag; reset dikerjakan uiTask (core 0)
  // karena hanya task itu yang memakai bus SPI LCD/MAX31855 (tidak ada akses SPI dari 2 core).
  if (strcmp(cmd, "lcdr") == 0) {
#if !LCD_ENABLE
    sendMsg("LCD dimatikan di firmware (LCD_ENABLE 0)"); return;
#endif
    gLcdResetReq = true;
    sendMsg("Reset LCD diminta");
    return;
  }
  // ---- rev 34: "pidm,<1|0>" = PID ADAPTIF ON / PID KONVENSIONAL ON (pilih mode + nyalakan).
  // Konvensional = gain dasar Kp0/Ki0/Kd0 tetap. Ganti mode saat PID jalan: tanpa loncatan
  // (integral dalam satuan keluaran), berlaku di sampel berikutnya.
  if (sscanf(cmd, "pidm,%d", &v) == 1) {
    pidAdapt = (v != 0);
    if (!pidOn) pidAdaptGains(0.0f, 0.0f);
    pidSave();
    if (!pidOn) pidEnable();
    sendMsg(pidAdapt ? "PID ADAPTIF ON" : "PID KONVENSIONAL ON (gain dasar tetap)");
    return;
  }
  // ---- rev 17: "pida,<0|1>" adaptif ON/OFF (OFF = PID biasa, untuk pembanding) ----
  if (sscanf(cmd, "pida,%d", &v) == 1) {
    pidAdapt = (v != 0);
    if (!pidOn) pidAdaptGains(0.0f, 0.0f);   // saat aktif: berlaku di sampel berikutnya
    pidSave();
    sendMsg(pidAdapt ? "Mode ADAPTIVE PID" : "Mode PID BIASA (adaptif OFF)");
    return;
  }
  // ---- PID (rev 16): "pid,<0|1>" dan "pidk,<kp>,<ki>,<kd>,<umax>" ----
  if (sscanf(cmd, "pid,%d", &v) == 1) {
    if (v) pidEnable(); else { if (pidOn) pidDisable("PID dimatikan, katup ke TUTUP"); else sendMsg("PID sudah mati"); }
    return;
  }
  { float fk, fi, fd, fu;
    // rev 17: "pidl,<lambda_p>,<lambda_i>,<lambda_d>"
    if (sscanf(cmd, "pidl,%f,%f,%f", &fk, &fi, &fd) == 3) {
      if (!pidLambdaOk(fk, fi, fd)) { sendMsg("Lambda ditolak: lp 0-1, li 0-0.01, ld 0-50"); return; }
      pidLp = fk; pidLi = fi; pidLd = fd;
      pidSave();
      sendMsg("Lambda adaptif disimpan");
      return;
    }
    if (sscanf(cmd, "pidk,%f,%f,%f,%f", &fk, &fi, &fd, &fu) == 4) {
      if (!pidParamsOk(fk, fi, fd, fu)) {
        sendMsg("Parameter PID ditolak: Kp 0-50, Ki 0-5, Kd 0-200, Umax 5-100"); return;
      }
      pidKp = fk; pidKi = fi; pidKd = fd; pidUmax = fu;
      if (!pidOn) pidAdaptGains(0.0f, 0.0f);
      if (pidI > pidUmax) pidI = pidUmax;      // Ki disimpan dlm satuan keluaran: ganti Ki tanpa loncatan
      pidSave();
      sendMsg(pidOn ? "Parameter PID disimpan (berlaku sampel berikutnya)" : "Parameter PID disimpan");
      return;
    }
  }
  if (strcmp(cmd, "stx") == 0) {
    if (stState == 1) stepTestEnd(3, "Step test DIBATALKAN");
    else sendMsg("Tidak ada step test berjalan");
    return;
  }
  { float fa, fm; int dm;
    if (sscanf(cmd, "stt,%f,%f,%d", &fa, &fm, &dm) == 3) { stepTestStart(fa, fm, dm); return; } }
  if (stState == 1 && strncmp(cmd, "sv", 2) == 0) { sendMsg("Step test berjalan: servo dikunci (batal dulu)"); return; }
  if (pidOn && strncmp(cmd, "sv", 2) == 0) { sendMsg("PID aktif: servo manual ditolak (PID OFF dulu)"); return; }
  if (sscanf(cmd, "en,%d", &v) == 1) {
    if (v == 0) hardStop(stepX);
    setDrivers(v != 0);
    return;
  }
  if (sscanf(cmd, "spd,%c,%d", &ax, &v) == 2 && ax == 'X') {
    spdX = constrain(v, MIN_SPEED, MAX_SPEED);
    applySpeedAccel(); return;
  }
  if (sscanf(cmd, "acc,%c,%d", &ax, &v) == 2 && ax == 'X') {
    accX = constrain(v, MIN_ACCEL, MAX_ACCEL);
    applySpeedAccel(); return;
  }
  // ---- servo ----
  if (sscanf(cmd, "svcal,%d,%d", &a, &b) == 2) {
    if (!servoPulseOk(a, b)) {
      sendMsg("Kalibrasi pulsa ditolak: 300-3000 us dan selisih minimal 200"); return;
    }
    svUsMin = a; svUsMax = b;
    servoSaveCal();
    sendMsg("Kalibrasi pulsa disimpan");
    return;
  }
  // rev 18: kalibrasi - gerak ke sudut ABSOLUT 0..180 tanpa kunci TUTUP..BUKA.
  // (Ditolak saat PID aktif / step test lewat cek awalan "sv" di atas.)
  if (sscanf(cmd, "svk,%d", &v) == 1) { setServoAngleManual((float)v); return; }
  if (sscanf(cmd, "svset,%c", &ax) == 1 && (ax == 'c' || ax == 'o')) {
    if (svRawUs > 0) { sendMsg("Keluar dari mode pulsa mentah dulu (Kembali ke sudut)"); return; }
    int deg = (int)lroundf(svTargetDeg);   // rev 19: benar juga utk sudut negatif
    // rev 18: arah menutup = sudut mengecil (hasil kalibrasi awal: tutup 0, buka 55);
    // TUTUP harus lebih kecil dari BUKA minimal SERVO_MIN_SPAN_DEG agar % bukaan bermakna.
    if (ax == 'c' && deg > svOpenDeg - SERVO_MIN_SPAN_DEG) {
      sendMsg("Ditolak: TUTUP harus lebih kecil dari BUKA (selisih min 5 derajat)"); return;
    }
    if (ax == 'o' && deg < svClosedDeg + SERVO_MIN_SPAN_DEG) {
      sendMsg("Ditolak: BUKA harus lebih besar dari TUTUP (selisih min 5 derajat)"); return;
    }
    if (ax == 'c') svClosedDeg = deg; else svOpenDeg = deg;
    servoSaveCal();
    char m[48]; snprintf(m, sizeof(m), "%s = %d derajat disimpan", ax == 'c' ? "TUTUP" : "BUKA", deg);
    sendMsg(m);
    return;
  }
  if (sscanf(cmd, "svus,%d", &v) == 1) {
    if (v == 0) { svRawUs = 0; sendMsg("Kembali ke mode sudut"); return; }
    if (v < SERVO_US_ABS_MIN || v > SERVO_US_ABS_MAX) { sendMsg("Pulsa di luar 300-3000 us"); return; }
    svRawUs = v;
    return;
  }
  if (sscanf(cmd, "svad,%d", &v) == 1) { setServoAngleManual(lroundf(svTargetDeg) + v); return; }   // rev 20
  if (sscanf(cmd, "sva,%d", &v) == 1)  { setServoAngleManual((float)v); return; }                   // rev 20
  if (sscanf(cmd, "sv,%d", &v) == 1)   { setServoPct(v); return; }
  // ---- setpoint suhu (rev 12): "sp,<derajat C>" ----
  if (strncmp(cmd, "sp,", 3) == 0) {
    char* end = nullptr;
    float spv = strtof(cmd + 3, &end);
    if (end == cmd + 3 || !isfinite(spv)) { sendMsg("Setpoint tidak valid"); return; }
    // rev 29: setpoint BEBAS (permintaan pengguna). Pengaman tetap: suhu >= TEMP_CUTOFF_C (180 C)
    // -> TAHAN AMAN (katup TUTUP) sampai <= 175 C, jadi setpoint > 180 tidak membuat minyak > 180.
    gSetpoint = spv;
    prefs.begin("fryer", false);
    prefs.putFloat("sp", spv);
    prefs.end();
    sendMsg("Setpoint disimpan");
    return;
  }
  // ---- motor DC Z ----
  if (sscanf(cmd, "dcz,%d", &v) == 1) { dcSetTarget(v); return; }
  // ---- buzzer ----
  if (sscanf(cmd, "bz,%d", &v) == 1) { buzzPlay(v); return; }
  sendMsg("Perintah tidak dikenal");
}

void onWsEvent(uint8_t num, WStype_t type, uint8_t* payload, size_t length) {
  if (type != WStype_TEXT || length == 0) return;
  if (length >= 64) { sendMsg("Perintah ditolak: terlalu panjang"); return; }   // dulu dibuang diam-diam
  char buf[64];
  memcpy(buf, payload, length);
  buf[length] = 0;
  handleCommand(buf);
}

// ---------------- BROADCAST ----------------
void broadcastStatus() {
  char b[900];
  int n = snprintf(b, sizeof(b), "{\"type\":\"st\",\"ls\":[%d,%d,%d,%d],\"raw\":[%d,%d,%d,%d],\"vr\":[%d,%d,%d,%d],\"il\":[%d,%d,%d,%d],\"pn\":[%d,%d,%d,%d],",
    lsHit(0), lsHit(1), lsHit(2), lsHit(3),
    lsRaw(0), lsRaw(1), lsRaw(2), lsRaw(3),
    LS[0].verified, LS[1].verified, LS[2].verified, LS[3].verified,
    LS[0].interlock, LS[1].interlock, LS[2].interlock, LS[3].interlock,
    LS[0].pin, LS[1].pin, LS[2].pin, LS[3].pin);
  snprintf(b + n, sizeof(b) - n,
    "\"bn\":%d,\"dx\":%d,\"xp\":%ld,\"xm\":%d,\"en\":%d,\"sx\":%d,\"ax\":%d,"
    "\"sa\":%d,\"sg\":%d,\"sr\":%d,\"sl\":%d,\"um\":%d,\"ux\":%d,\"cd\":%d,\"od\":%d,\"tc\":%d,"
    "\"dcc\":%d,\"dct\":%d,\"dcm\":%d,\"dcv\":%d,\"sp\":%.1f,"
    "\"kp\":%.3f,\"ki\":%.5f,\"kd\":%.3f,\"pm\":%.1f,"           // rev 16: pm = Umax PID (um = pulsa servo); kp/ki/kd = gain DASAR
    "\"ad\":%d,\"lp\":%.4f,\"li\":%.5f,\"ld\":%.3f,"             // rev 17: adaptif ON/OFF + lambda
    "\"fw\":\"%s\",\"rr\":\"%s\",\"hp\":%lu,\"sk\":%u,\"lr\":%lu,\"wc\":%d,\"wm\":%d,"
    "\"nf\":%lu,\"nb\":%lu,\"nm\":%lu,\"nc\":%lu,\"nj\":%lu,\"cj\":%.2f}",          // rev 32: penghitung error sensor  // rev 20 versi; rev 22 diagnosa; rev 25 klien WS
    (int)BENCH_MODE, digitalRead(PIN_X_DIR), stepX.currentPosition(), stepX.distanceToGo() != 0,
    driversEnabled, spdX, accX,
    (int)lroundf(svCurDeg), (int)lroundf(svTargetDeg), (int)svRawUs, (int)svLock, svUsMin, svUsMax, svClosedDeg, svOpenDeg, (int)TEMP_CUTOFF_C,
    (int)lroundf(dcCur), (int)dcTarget, (int)(dcCap() * 100.0f + 0.5f), (int)MOTOR_SUPPLY_V, (float)gSetpoint,
    pidKp, pidKi, pidKd, pidUmax,
    (int)pidAdapt, pidLp, pidLi, pidLd, FW_REV,
    gResetWhy, (unsigned long)ESP.getMinFreeHeap(),
    gUiTask ? (unsigned)uxTaskGetStackHighWaterMark(gUiTask) : 0u, (unsigned long)gLcdResets,
    ws.connectedClients(), (int)WEBSOCKETS_SERVER_CLIENT_MAX,
    (unsigned long)gCntFault, (unsigned long)gCntFrame, (unsigned long)gCntMismatch, (unsigned long)gCntCj,
    (unsigned long)gCntJump, isnan(gCjTemp) ? -99.0f : (float)gCjTemp);
  ws.broadcastTXT(b);
}

void broadcastTemp() {
  // rev 16: t/ms/held dari snapshot terkirim yang SAMA dengan yang dipakai PID
  TempSnap s = readPubSnap();
  float t = s.t;
  uint32_t r = gRaw;
  const char* d = rawDiag(r);
  float sp = gSetpoint;
  unsigned long seq = gTempSeq, ms = s.ms;
  // rev 15: tr = mentah (null bila fault), held = nilai ditahan, ec = jumlah error sejak boot
  float tr = gTempRaw;
  char trs[16];
  if (isnan(tr)) strcpy(trs, "null"); else snprintf(trs, sizeof(trs), "%.2f", tr);
  int held = s.held ? 1 : 0;
  unsigned long ec = gErrCount;
  // rev 16: pe = PID aktif, pu = keluaran PID (%), se = setpoint efektif (null bila PID mati)
  // rev 17: kpe/kie/kde = gain yang SEDANG dipakai (adaptif); saat PID mati = gain dasar
  bool pe = pidOn;
  char ses[16];
  if (pe) snprintf(ses, sizeof(ses), "%.2f", pidSpEff); else strcpy(ses, "null");
  char b[700];
  // rev 34: pf = feedforward beban (%), am = mode PID (1 adaptif, 0 konvensional)
  // rev 33: uj = tahap Uji Sistem, us = detik tahap (tahap 5 = SISA timer), uf = timer goreng (dtk)
  // sp, seq, ms (rev 12): setpoint, nomor urut sampel, waktu sampel ESP32 (ms)
  if (isnan(t)) snprintf(b, sizeof(b), "{\"type\":\"temp\",\"t\":null,\"ok\":false,\"f\":%d,\"raw\":\"%08lX\",\"d\":\"%s\",\"up\":%lu,\"sp\":%.1f,\"seq\":%lu,\"ms\":%lu,\"st\":%d,\"te\":%lu,\"tr\":%s,\"held\":%d,\"ec\":%lu,\"pe\":%d,\"pu\":%.2f,\"se\":%s,\"kpe\":%.4f,\"kie\":%.5f,\"kde\":%.4f,\"ph\":%d,\"uj\":%d,\"us\":%ld,\"uf\":%lu,\"pf\":%.1f,\"am\":%d}",
                         (int)gFault, (unsigned long)r, d, millis() / 1000, sp, seq, ms, (int)stState, (unsigned long)stElapsedS(), trs, held, ec, (int)pe, pidOut, ses, pidKpEff, pidKiEff, pidKdEff, pe ? (pidSafeWhy ? (int)pidSafeWhy : (pidHold ? 1 : 0)) : 0, (int)ujState, ujSecs(), (unsigned long)(ujFryMs / 1000UL), pidFf, (int)pidAdapt);
  else          snprintf(b, sizeof(b), "{\"type\":\"temp\",\"t\":%.2f,\"ok\":true,\"raw\":\"%08lX\",\"d\":\"%s\",\"up\":%lu,\"sp\":%.1f,\"seq\":%lu,\"ms\":%lu,\"st\":%d,\"te\":%lu,\"tr\":%s,\"held\":%d,\"ec\":%lu,\"pe\":%d,\"pu\":%.2f,\"se\":%s,\"kpe\":%.4f,\"kie\":%.5f,\"kde\":%.4f,\"ph\":%d,\"uj\":%d,\"us\":%ld,\"uf\":%lu,\"pf\":%.1f,\"am\":%d}",
                         t, (unsigned long)r, d, millis() / 1000, sp, seq, ms, (int)stState, (unsigned long)stElapsedS(), trs, held, ec, (int)pe, pidOut, ses, pidKpEff, pidKiEff, pidKdEff, pe ? (pidSafeWhy ? (int)pidSafeWhy : (pidHold ? 1 : 0)) : 0, (int)ujState, ujSecs(), (unsigned long)(ujFryMs / 1000UL), pidFf, (int)pidAdapt);
  ws.broadcastTXT(b);
}

// ---------------- UI TFT + BACA MAX31855 (task di core 0) ----------------
struct Field { char last[96]; uint16_t color; Field() { last[0] = 1; last[1] = 0; color = 0; } };

void putText(Field& f, const char* str, int x, int y, int size, uint16_t color, int pad) {
  if (f.color == color && strcmp(f.last, str) == 0) return;
  strncpy(f.last, str, sizeof(f.last) - 1); f.last[sizeof(f.last) - 1] = 0; f.color = color;
  tft.setTextSize(size);
  tft.setTextColor(color, TFT_BLACK);
  tft.setTextPadding(pad);
  tft.drawString(str, x, y);
}

void drawLimitBox(int i, bool hit, bool raw, bool il) {
  int x = 6 + i * 118, y = 112;
  uint16_t bg = hit ? TFT_MAROON : TFT_DARKGREEN;
  tft.fillRect(x, y, 112, 62, bg);
  tft.setTextColor(TFT_WHITE, bg);
  tft.setTextPadding(0);
  tft.setTextSize(2);
  tft.drawString(LS[i].name, x + 6, y + 6);
  tft.drawString(hit ? "KENA" : "BEBAS", x + 6, y + 28);
  tft.setTextSize(1);
  char b[28];
  snprintf(b, sizeof(b), "GPIO%d=%c%s", LS[i].pin, raw ? 'H' : 'L', il ? "" : " no-IL");
  tft.drawString(b, x + 6, y + 50);
}

#define CH_N 100
float chartBuf[CH_N];
int   chartCnt = 0;

void chartPush(float v) {
  if (chartCnt < CH_N) chartBuf[chartCnt++] = v;
  else { memmove(chartBuf, chartBuf + 1, (CH_N - 1) * sizeof(float)); chartBuf[CH_N - 1] = v; }
}

void chartDraw() {
  const int X = 270, Y = 28, W = 204, H = 74;
  tft.fillRect(X, Y, W, H, TFT_BLACK);
  tft.drawRect(X, Y, W, H, TFT_DARKGREY);
  float lo = 1e9, hi = -1e9; int n = 0;
  for (int k = 0; k < chartCnt; k++) if (!isnan(chartBuf[k])) { lo = min(lo, chartBuf[k]); hi = max(hi, chartBuf[k]); n++; }
  if (n < 2) return;
  if (hi - lo < 5) { float m = (hi + lo) / 2; lo = m - 2.5; hi = m + 2.5; }
  int px = -1, py = 0;
  for (int k = 0; k < chartCnt; k++) {
    if (isnan(chartBuf[k])) { px = -1; continue; }
    int x = X + 2 + k * (W - 4) / (CH_N - 1);
    int y = Y + H - 3 - (int)((chartBuf[k] - lo) / (hi - lo) * (H - 6));
    if (px >= 0) tft.drawLine(px, py, x, y, TFT_GREEN);
    px = x; py = y;
  }
  tft.setTextColor(TFT_LIGHTGREY, TFT_BLACK);
  tft.setTextPadding(0);
  tft.setTextSize(1);
  char b[16];
  snprintf(b, sizeof(b), "%.0f", hi); tft.drawString(b, X + 4, Y + 3);
  snprintf(b, sizeof(b), "%.0f", lo); tft.drawString(b, X + 4, Y + H - 11);
}

void uiStatic() {
  tft.fillScreen(TFT_BLACK);
  tft.setTextDatum(TL_DATUM);
  tft.setTextColor(TFT_CYAN, TFT_BLACK);
  tft.setTextPadding(0);
  tft.setTextSize(2);
  tft.drawString("DEEP FRYER CERDAS", 6, 4);
  if (BENCH_MODE) {
    tft.setTextColor(TFT_WHITE, TFT_RED);
    tft.drawString(" BENCH ", 380, 4);
  }
  tft.drawFastHLine(0, 24, tft.width(), TFT_DARKGREY);
}

void fieldReset(Field& f) { f.last[0] = 1; f.last[1] = 0; f.color = 0; }

void uiUpdate() {
  static Field fTemp, fSens, fZ, fX, fDrv, fSv, fMsg, fWifi;
  static int8_t lHit[LS_COUNT] = { -1, -1, -1, -1 }, lRaw[LS_COUNT] = { -1, -1, -1, -1 };
  char b[80];

  if (gUiForce) {                    // rev 22: LCD baru di-reset -> semua elemen digambar ulang
    gUiForce = false;
    Field* all[] = { &fTemp, &fSens, &fZ, &fX, &fDrv, &fSv, &fMsg, &fWifi };
    for (Field* f : all) fieldReset(*f);
    for (int i = 0; i < LS_COUNT; i++) { lHit[i] = -1; lRaw[i] = -1; }
  }

  float t = gTemp;
  if (isnan(t)) {
    putText(fTemp, "ERR", 10, 34, 6, TFT_RED, 250);
    const char* why = (gFault & 1) ? "thermocouple LEPAS" : (gFault & 2) ? "short ke GND" : (gFault & 4) ? "short ke VCC"
                    : (gFault == 0x20) ? "SPI terganggu" : (gFault == 0x10 || gFault == 0x40) ? "frame rusak" : "tdk ada data";
    snprintf(b, sizeof(b), "ERR %08lX %s", (unsigned long)gRaw, gRaw == 0 ? "SO=LOW" : (gRaw == 0xFFFFFFFFUL ? "SO=HIGH" : why));
    putText(fSens, b, 10, 86, 2, TFT_RED, 470);
  } else {
    bool held = gTempHeld;
    snprintf(b, sizeof(b), "%.1f C", t);
    putText(fTemp, b, 10, 34, 6, held ? TFT_YELLOW : TFT_WHITE, 250);
    if (held) snprintf(b, sizeof(b), "HELD (error sesaat) raw %08lX", (unsigned long)gRaw);
    else      snprintf(b, sizeof(b), "Sensor OK  raw %08lX", (unsigned long)gRaw);
    putText(fSens, b, 10, 86, 2, held ? TFT_YELLOW : TFT_GREEN, 470);
  }

  for (int i = 0; i < LS_COUNT; i++) {
    int8_t h = lsHit(i), r = lsRaw(i);
    if (h != lHit[i] || r != lRaw[i]) { lHit[i] = h; lRaw[i] = r; drawLimitBox(i, h, r, LS[i].interlock); }
  }

  snprintf(b, sizeof(b), "Z DC: %d%% (tgt %d%%) %s", (int)lroundf(dcCur), (int)dcTarget, dcTarget > 0 ? "NAIK" : (dcTarget < 0 ? "TURUN" : "diam"));
  putText(fZ, b, 10, 180, 2, TFT_WHITE, 470);
  snprintf(b, sizeof(b), "X: %ld step %s D:%c", stepX.currentPosition(), stepX.distanceToGo() ? "[gerak]" : "", digitalRead(PIN_X_DIR) ? 'H' : 'L');
  putText(fX, b, 10, 202, 2, TFT_WHITE, 470);

  snprintf(b, sizeof(b), "Drv X:%s %d/%d", driversEnabled ? "AKTIF" : "MATI", spdX, accX);
  putText(fDrv, b, 10, 224, 2, driversEnabled ? TFT_GREEN : TFT_LIGHTGREY, 470);

  uint8_t lk = svLock;
  int raw = svRawUs;
  if (raw > 0) snprintf(b, sizeof(b), "Servo: PULSA %d us", raw);
  else         snprintf(b, sizeof(b), "Servo: %d deg (tgt %d)%s", (int)lroundf(svCurDeg), (int)lroundf(svTargetDeg),
                        lk == 1 ? " KUNCI:SENSOR" : (lk == 2 ? " KUNCI:SUHU" : ""));
  putText(fSv, b, 10, 246, 2, lk ? TFT_RED : TFT_CYAN, 470);

  char m[40];
  strncpy(m, gMsg[0] ? gMsg : "-", sizeof(m) - 1); m[sizeof(m) - 1] = 0;
  putText(fMsg, m, 10, 270, 2, TFT_YELLOW, 470);

  // rev 22: IP diformat langsung (tanpa String -> tidak membebani/memecah heap tiap 150 ms)
  snprintf(b, sizeof(b), "WiFi AP: %s  IP: %u.%u.%u.%u  klien:%d  up:%lus", AP_SSID,
           AP_IP[0], AP_IP[1], AP_IP[2], AP_IP[3], WiFi.softAPgetStationNum(), millis() / 1000);
  putText(fWifi, b, 6, 302, 1, TFT_DARKGREY, 470);
}

// rev 22: reset LCD NON-BLOCKING (pola blink-without-delay). Dulu delay(10)+delay(50)+delay(150)
// menghentikan uiTask 210 ms. Sekarang tiap tahap hanya memeriksa millis() lalu kembali, sehingga
// pembacaan suhu tetap berjalan selama pin RESET LCD ditahan.
enum LcdState : uint8_t { LCD_START, LCD_RST_HIGH, LCD_RST_LOW, LCD_RST_WAIT, LCD_READY };
LcdState lcdState = LCD_START;
uint32_t lcdT0 = 0;
bool     sensorReady = false;       // MAX31855 sudah di-begin() (setelah init LCD pertama)

// ---------------- FILTER SENSOR SUHU: CASCADED FILTERING 3 TAHAP (rev 21) ----------------
// Menggantikan Savitzky-Golay (rev 15). Per sampel valid (200 ms):
//   Tahap 1  MEDIAN-5      : median 5 sampel terakhir -> membuang lonjakan 1-2 sampel berturut
//                            (frame MAX31855 rusak/noise EMI) tanpa ambang tetap.
//   Tahap 2  MOVING AVG-5  : rata-rata 5 keluaran median -> menekan noise acak (std / ~sqrt(5)).
//   Tahap 3  EMA (alpha)   : low-pass orde-1  y += alpha*(x - y) -> menghaluskan sisa riak.
// SIFAT (simulasi Python, Ts 200 ms, alpha 0.3; lihat Python/uji_filter_sensor.py):
//   - jeda pada suhu yang naik/turun linear ~6.3 sampel = ~1.3 dtk (median 2 + MA 2 + EMA 2.3).
//     Jeda ini IKUT masuk ke dead time hasil step test dan ke loop PID (kecil dibanding dead
//     time plant ~10-20 dtk, tetapi tidak nol).
//   - std noise acak turun ke ~34% (SG rev 15: ~76%).
//   - lonjakan 1 atau 2 sampel berturut dibuang 100%; 3 sampel berturut lolos sebagian (~45%).
//   - respons loncatan: tanpa overshoot, 90% tercapai ~2 dtk.
//   - pengaman suhu-lebih (TEMP_CUTOFF, PID_OVER) memakai nilai tersaring -> ikut tertunda ~1.3 dtk.
// Awal data / setelah reset: median & MA memakai sampel yang ada (1..5), EMA mulai dari nilai
// pertama -> tidak menunggu jendela penuh.
// FAULT (NaN dari MAX31855): HOLD nilai tersaring terakhir maks SENSOR_HOLD_MS (filter dibekukan,
// tidak diisi); lewat itu gTemp = NAN (pengaman servo/step test/PID bekerja seperti semula) dan
// seluruh filter direset. gLastValidMs hanya diperbarui oleh sampel valid.
#define FILT_MED_N      5
#define FILT_MA_N       5
#define FILT_EMA_ALPHA  0.3f

struct SensorFilter {
  float    med[FILT_MED_N]; uint8_t mn = 0, mh = 0;   // tahap 1: buffer sirkular median
  float    ma[FILT_MA_N];   uint8_t an = 0, ah = 0;   // tahap 2: buffer sirkular moving average
  float    ema = NAN;                                  // tahap 3
  bool     have = false;                               // sudah ada sampel valid sejak reset
  float    lastOut = NAN;                              // keluaran terakhir (yang ditahan saat error)
  float    lastRaw = NAN;                              // rev 26: bacaan mentah wajar terakhir
  float    cand = NAN;  uint8_t candN = 0;             // rev 32: calon acuan (perlu SENSOR_REF_N sampel)
  bool     ref = false;                                // rev 26: lastRaw/lastGoodMs berlaku sebagai acuan.
                                                       // TIDAK dihapus saat masa tahan habis: batas lompatan
                                                       // melebar 5 C/dtk x waktu sejak bacaan wajar terakhir.
  uint32_t lastGoodMs = 0;

  void reset() { mn = mh = an = ah = 0; ema = NAN; have = false; }

  float stage1Median(float v) {
    med[mh] = v; mh = (mh + 1) % FILT_MED_N; if (mn < FILT_MED_N) mn++;
    float t[FILT_MED_N];
    for (int i = 0; i < mn; i++) t[i] = med[i];          // urutan tidak penting untuk median
    for (int i = 1; i < mn; i++) {                       // insertion sort (n <= 5)
      float x = t[i]; int j = i - 1;
      while (j >= 0 && t[j] > x) { t[j + 1] = t[j]; j--; }
      t[j + 1] = x;
    }
    return (mn % 2) ? t[mn / 2] : 0.5f * (t[mn / 2 - 1] + t[mn / 2]);
  }
  float stage2MovAvg(float v) {
    ma[ah] = v; ah = (ah + 1) % FILT_MA_N; if (an < FILT_MA_N) an++;
    float sum = 0;
    for (int i = 0; i < an; i++) sum += ma[i];           // dijumlah ulang: tanpa drift pembulatan
    return sum / an;
  }
  float stage3Ema(float v) {
    ema = isnan(ema) ? v : ema + FILT_EMA_ALPHA * (v - ema);
    return ema;
  }
};
SensorFilter sf;
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
void loop() {
  esp_task_wdt_reset();             // rev 22: loop() masih hidup
  server.handleClient();
  ws.loop();

  enforceSafety();
  stepX.run();
  stepTestUpdate();
  ujUpdate();                       // rev 33: Uji Sistem (sebelum dcUpdate: limit dicek di sini dulu)
  servoUpdate();
  dcUpdate();
  buzzerUpdate();

  pidWatchdog();
  if (gTempFresh) { gTempFresh = false; pidUpdate(); broadcastTemp(); }   // PID 1 Hz, dari nilai tersaring

  unsigned long now = millis();
  if (now - lastStatus >= 250) { lastStatus = now; broadcastStatus(); }
}
