asadbahauddin/thermoadapt-fryer/Python/uji_pid.py

"""Uji logika (Adaptive) PID firmware rev 17 TANPA hardware:  python uji_pid.py

Pid = porting baris-per-baris pidAdaptGains()/pidEnable()/pidUpdate()/pidWatchdog() dari dep_frayer.ino
(tidak ada compiler C++ host). Konstanta dibaca dari .ino. Plant = FOPDT DUGAAN
(K, tau, L di bawah), BUKAN model alat: hasil overshoot hanya ilustrasi logika, bukan tuning.
"""
import math
import os
import re
import unittest

INO = os.path.join(os.path.dirname(os.path.abspath(__file__)), "..", "dep_frayer", "dep_frayer.ino")
SRC = open(INO, encoding="utf-8").read()


def c(nama):
    return float(re.search(r"#define\s+%s\s+([-\d.]+)f?" % nama, SRC).group(1))


KP, KI, KD, UMAX = c("PID_DEFAULT_KP"), c("PID_DEFAULT_KI"), c("PID_DEFAULT_KD"), c("PID_DEFAULT_UMAX")
RAMP, HOLD, HYST, DF = c("PID_SP_RAMP_C_S"), c("PID_HOLD_C"), c("PID_HOLD_HYST_C"), c("PID_D_FILTER")
CUTOFF, FAULT_MS = c("TEMP_CUTOFF_C"), c("SENSOR_FAULT_MS")
SP_MAX = CUTOFF - 15
CUTOFF_ON = bool(int(re.search(r"#define\s+PID_CUTOFF_ENABLE\s+(\d)", SRC).group(1)))   # rev 30
LP, LI, LD = c("PID_DEFAULT_LP"), c("PID_DEFAULT_LI"), c("PID_DEFAULT_LD")
KP_MAX, KI_MAX, KD_MAX = c("PID_KP_MAX"), c("PID_KI_MAX"), c("PID_KD_MAX")
FF_PCT, FF_TAU = c("PID_FF_PCT"), c("PID_FF_TAU_S")                   # rev 34


class Pid:
    def __init__(self, kp=KP, ki=KI, kd=KD, umax=UMAX, adapt=True, lp=LP, li=LI, ld=LD):
        self.kp, self.ki, self.kd, self.umax = kp, ki, kd, umax
        self.adapt, self.lp, self.li, self.ld = adapt, lp, li, ld
        self.kpe, self.kie, self.kde = kp, ki, kd
        self.hold = False
        self.safe = 0                                    # rev 27: kode TAHAN AMAN (0 = normal)
        self.on = False
        self.I = self.out = self.sp_eff = self.prev_t = self.df = 0.0
        self.prev_valid = False
        self.last_ms = 0
        self.alasan_mati = None
        self.ff_on, self.ff_ms, self.ff = False, 0, 0.0      # rev 34: feedforward beban
        self.I_mem = 0.0                                     # rev 38: integral terakhir saat STOP

    def ff_start(self, ms):                              # pidFfStart (dipanggil di tahap 4 Uji Sistem)
        if FF_PCT > 0 and self.on:
            self.ff_on, self.ff_ms = True, ms

    def ff_cancel(self):
        self.ff_on, self.ff = False, 0.0

    def gains(self, e, dTdt):
        if not self.adapt:
            self.kpe, self.kie, self.kde = self.kp, self.ki, self.kd
            return
        self.kpe = min(self.kp + self.lp * abs(e), max(self.kp, KP_MAX))
        self.kie = min(self.ki + self.li * abs(e), max(self.ki, KI_MAX))
        self.kde = min(self.kd + self.ld * abs(dTdt), max(self.kd, KD_MAX))

    def safe_enter(self, why):                           # rev 27: pidSafeEnter
        self.safe = why
        self.out = 0.0                                   # rev 38: integral dibekukan
        self.prev_valid = False
        self.ff_cancel()

    def disable(self, why):
        if self.on:
            self.I_mem = self.I                          # rev 38: integral diingat
        self.on, self.out = False, 0.0
        self.ff_cancel()
        self.alasan_mati = why

    def enable(self, t, ms, held, setpoint, opening_pct):   # rev 28: SELALU berhasil
        self.hold = False
        self.safe = 0
        self.gains(0.0, 0.0)
        self.I = min(max(opening_pct, self.I_mem, 0.0), self.umax)   # rev 38
        self.out = self.I
        self.df = 0.0
        self.last_ms = ms
        self.on = True
        if math.isnan(t) or held:
            self.sp_eff = setpoint
            self.safe_enter(2)
            return True
        self.sp_eff, self.prev_t, self.prev_valid = t, t, True
        if CUTOFF_ON and t >= CUTOFF:
            self.safe_enter(3)
        return True

    def update(self, t, ms, held, setpoint, now_ms, last_valid_ms):
        if not self.on:
            return
        if math.isnan(t):
            self.prev_valid = False
            if now_ms - last_valid_ms > FAULT_MS:
                self.safe_enter(2)                       # rev 27: TAHAN AMAN, tetap ON
            return
        if CUTOFF_ON and t >= CUTOFF:
            self.safe_enter(3); return
        if self.safe:                                    # keluar hanya dgn pengukuran baru yang wajar
            if held:
                return
            if self.safe == 3 and t > CUTOFF - 5:
                return
            self.safe, self.sp_eff, self.last_ms = 0, t, ms
            return
        dt = (ms - self.last_ms) / 1000.0
        self.last_ms = ms
        if dt < 0.05 or dt > 5.0:
            dt = 1.0
        stp = RAMP * dt
        self.sp_eff = setpoint if abs(setpoint - self.sp_eff) <= stp else self.sp_eff + (stp if setpoint > self.sp_eff else -stp)
        if held:
            return
        if not self.hold and t >= setpoint + HOLD:        # rev 24: overshoot -> tahan TUTUP, tetap ON
            self.hold = True
        elif self.hold and t <= setpoint + HOLD - HYST:
            self.hold = False
        if self.hold:
            self.out = 0.0                               # rev 37: integral DIBEKUKAN (tidak dinolkan)
            self.ff_cancel()
            self.prev_t, self.df = t, 0.0
            self.gains(self.sp_eff - t, 0.0)
            return
        e = self.sp_eff - t
        if not self.prev_valid:
            self.prev_t, self.df, self.prev_valid = t, 0.0, True
        d_raw = (t - self.prev_t) / dt
        self.prev_t = t
        self.df = DF * self.df + (1 - DF) * d_raw
        self.gains(e, self.df)
        self.ff = 0.0
        if self.ff_on:
            tf = max((ms - self.ff_ms) / 1000.0, 0.0)
            if tf > 5.0 * FF_TAU:
                self.ff_on = False
            elif t < self.sp_eff:
                self.ff = FF_PCT * math.exp(-tf / FF_TAU)
        u_unsat = self.kpe * e + self.I - self.kde * self.df + self.ff
        u = min(max(u_unsat, 0.0), self.umax)
        windup = (u_unsat > self.umax and e > 0) or (u_unsat < 0 and e < 0)
        if not windup:
            self.I = min(max(self.I + self.kie * e * dt, 0.0), self.umax)
        self.out = u

    def watchdog(self, now_ms, pub_ms):
        if self.on and now_ms - pub_ms > FAULT_MS:
            self.safe_enter(4)                           # rev 27: TAHAN AMAN, tetap ON


def simulasi(detik=3600, sp=150.0, K=4.0, tau=600.0, L=20.0, T0=30.0, ganggu=None, pid=None, beban=None):
    """Loop tertutup 1 Hz dengan plant FOPDT dugaan. ganggu(i, T) -> (t_ukur, held) opsional.
    Catatan: suhu maks yang bisa dicapai = T0 + K*Umax. Dengan Umax 40%, setpoint 150 C hanya
    tercapai bila K >= (150-30)/40 = 3 C per % bukaan (K=2.2 -> maks 118 C)."""
    pid = pid or Pid()
    T, hist, rows = T0, [0.0] * int(L), []
    pid.enable(T, 0, False, sp, 0.0)
    last_valid = 0
    for i in range(1, detik):
        u_tunda = hist[-int(L)]
        T += (K * u_tunda - (T - T0)) / tau
        if beban is not None:
            T += beban(i)                                    # gangguan beban (ubi masuk)
        t_ukur, held = (T, False) if ganggu is None else ganggu(i, T)
        if not math.isnan(t_ukur) and not held:
            last_valid = i * 1000
        pid.update(t_ukur, i * 1000, held, sp, i * 1000, last_valid)
        hist.append(pid.out if pid.on else 0.0)
        rows.append((i, T, pid.out, pid.I, pid.sp_eff, pid.on, pid.kpe, pid.kie, pid.kde))
    return pid, rows


class UjiPid(unittest.TestCase):
    def test_bumpless_start(self):
        p = Pid()
        self.assertTrue(p.enable(100.0, 0, False, 150.0, 25.0))
        p.update(100.0, 1000, False, 150.0, 1000, 1000)
        # e = sp_eff - T = 0.15 -> keluaran hampir sama dengan bukaan saat start (25%)
        self.assertAlmostEqual(p.out, 25.0 + (KP + LP * RAMP) * RAMP, places=6)   # Kp efektif (adaptif)

    def test_enable_selalu_berhasil(self):                       # rev 28
        for t, held, harapan in ((float("nan"), False, 2), (100, True, 2), (CUTOFF + 20, False, 3 if CUTOFF_ON else 0),
                                 (CUTOFF - 5, False, 0), (170, False, 0), (100, False, 0)):
            p = Pid()
            self.assertTrue(p.enable(t, 0, held, 150, 30.0))
            self.assertTrue(p.on)
            self.assertEqual(p.safe, harapan, (t, held))
            if harapan:
                self.assertEqual(p.out, 0.0)                         # katup TUTUP saat tahan aman

    def test_enable_saat_sensor_error_lalu_sensor_pulih(self):
        p = Pid(); p.enable(float("nan"), 0, False, 150, 30.0)
        self.assertEqual(p.safe, 2)
        p.update(100.0, 1000, False, 150, 1000, 1000)                # bacaan wajar datang
        self.assertEqual(p.safe, 0); self.assertTrue(p.on)
        self.assertEqual(p.sp_eff, 100.0)                            # ramp mulai dari suhu sekarang

    def test_antiwindup_integral_tidak_lewat_umax(self):
        pid, rows = simulasi(detik=1200)
        self.assertTrue(all(0.0 <= r[3] <= UMAX + 1e-9 for r in rows))
        self.assertTrue(all(0.0 <= r[2] <= UMAX + 1e-9 for r in rows))

    def test_loop_tertutup_mencapai_setpoint(self):
        pid, rows = simulasi(detik=7200, sp=150.0)
        T_akhir = rows[-1][1]
        maks = max(r[1] for r in rows)
        self.assertTrue(pid.on)
        self.assertLess(abs(T_akhir - 150.0), 1.0)
        print("\n  [ilustrasi plant dugaan] suhu akhir %.2f C, maks %.2f C (overshoot %.2f C)"
              % (T_akhir, maks, maks - 150.0))

    def test_umax_terlalu_kecil_terdeteksi(self):
        pid, rows = simulasi(detik=7200, sp=150.0, K=2.2, pid=Pid(umax=40.0))   # maks 30 + 2.2*40 = 118 C
        self.assertLess(rows[-1][1], 119.0)
        self.assertAlmostEqual(rows[-1][2], 40.0)                  # keluaran mentok di Umax

    def test_held_membekukan_integral(self):
        def g(i, T):
            return (T, 400 <= i < 403)                       # 3 sampel ditahan
        pid, rows = simulasi(detik=600, ganggu=g)
        I = {r[0]: r[3] for r in rows}
        out = {r[0]: r[2] for r in rows}
        self.assertEqual(I[400], I[399]); self.assertEqual(I[402], I[399])
        self.assertEqual(out[402], out[399])

    def test_sensor_error_tahan_aman_tetap_on_lalu_lanjut(self):
        def g(i, T):
            return (float("nan"), False) if 300 <= i < 330 else (T, False)
        pid, rows = simulasi(detik=400, ganggu=g)
        self.assertTrue(all(r[5] for r in rows))            # PID TIDAK PERNAH mati
        out = {r[0]: r[2] for r in rows}
        self.assertTrue(all(out[i] == 0.0 for i in range(305, 330)))   # > 5 dtk: katup TUTUP
        self.assertEqual(pid.safe, 0)                       # sensor normal -> lanjut sendiri
        self.assertGreater(max(out[i] for i in range(331, 400)), 0.0)

    def test_overshoot_tahan_tetap_on(self):
        p = Pid(); p.enable(100, 0, False, 150, 30.0)
        p.update(161.0, 1000, False, 150, 1000, 1000)          # >= sp + 10
        self.assertTrue(p.on); self.assertTrue(p.hold)
        self.assertEqual(p.out, 0.0)                            # katup TUTUP
        self.assertEqual(p.I, 30.0)                             # rev 37: integral beku (bukan nol)
        p.update(158.0, 2000, False, 150, 2000, 2000)          # masih > sp + 7: tetap tahan
        self.assertTrue(p.hold)
        p.update(157.0, 3000, False, 150, 3000, 3000)          # <= sp + 7: normal lagi
        self.assertFalse(p.hold); self.assertTrue(p.on)

    def test_tanpa_batas_suhu_rev30(self):
        self.assertFalse(CUTOFF_ON)                                  # PID_CUTOFF_ENABLE 0
        p = Pid(); p.enable(CUTOFF + 20, 0, False, 250, 30.0)        # PID ON saat 200 C, setpoint 250
        p.update(CUTOFF + 20, 1000, False, 250, 1000, 1000)
        self.assertTrue(p.on); self.assertEqual(p.safe, 0)
        self.assertGreater(p.out, 0.0)                               # tetap memanaskan menuju setpoint

    def test_hanya_pengguna_yang_mematikan(self):
        p = Pid(); p.enable(100, 0, False, 150, 0)
        for t in (float("nan"), 500.0, 170.0, 60.0):
            p.update(t, 10_000, False, 150, 10_000, 0)
        p.watchdog(99_999, 0)
        self.assertTrue(p.on)
        p.disable("pengguna"); self.assertFalse(p.on)

    def test_watchdog_tahan_aman(self):
        p = Pid(); p.enable(100, 0, False, 150, 30.0)
        p.watchdog(5000, 0); self.assertEqual(p.safe, 0)
        p.watchdog(5001, 0); self.assertTrue(p.on); self.assertEqual((p.safe, p.out), (4, 0.0))
        p.update(100.0, 6000, False, 150, 6000, 6000)          # data masuk lagi -> lanjut
        self.assertEqual(p.safe, 0)

    def test_derivatif_tanpa_lonjakan_setelah_gangguan(self):
        p = Pid(kd=10.0); p.enable(100, 0, False, 150, 0)
        p.update(100, 1000, False, 150, 1000, 1000)
        p.update(float("nan"), 2000, False, 150, 2000, 1000)
        p.update(104, 3000, False, 150, 3000, 3000)          # suhu loncat 4 C setelah NAN
        self.assertEqual(p.df, 0.0)


def sim_beban(ff=True, adapt=True, L=10, sp=150.0, dur=400, t_load=60):
    """Plant terkalibrasi data 31 Okt: dT/dt = a*u(t-L) - c*(T-30) - beban keripik
    (a 0.015 C/s per %, u tunak 11% pada 165 C; beban 0.6 C/s meluruh 180 s, mereproduksi
    siklus SP150 nyata: turun ke ~137 C, +180 s ~146 C). FF mulai saat Z mulai turun (t_load-10)."""
    a = 0.015
    k = a * 11.0 / (165.0 - 30.0)
    pid = Pid(adapt=adapt)
    T = sp
    u0 = k * (T - 30.0) / a
    hist = [u0] * (L + 1)
    pid.enable(T, 0, False, sp, u0)
    rows = []
    for i in range(1, dur):
        q = 0.6 * math.exp(-(i - t_load) / 180.0) if i >= t_load else 0.0
        T += a * hist[-(L + 1)] - k * (T - 30.0) - q
        if ff and i == t_load - 10:
            pid.ff_start(i * 1000)
        pid.update(T, i * 1000, False, sp, i * 1000, i * 1000)
        hist.append(pid.out)
        rows.append((i, T, pid.out, pid.ff))
    return rows


class UjiFeedforward(unittest.TestCase):                                  # rev 34
    def test_ff_menaikkan_suhu_terendah_tanpa_overshoot(self):
        for adapt in (True, False):
            for L in (10, 30):
                tanpa = sim_beban(ff=False, adapt=adapt, L=L)
                pakai = sim_beban(ff=True, adapt=adapt, L=L)
                tmin0, tmin1 = min(r[1] for r in tanpa), min(r[1] for r in pakai)
                tmax0, tmax1 = max(r[1] for r in tanpa), max(r[1] for r in pakai)
                iae0 = sum(abs(150 - r[1]) for r in tanpa)
                iae1 = sum(abs(150 - r[1]) for r in pakai)
                self.assertGreater(tmin1, tmin0 + 3, (adapt, L))
                self.assertLess(iae1, iae0 * 0.85, (adapt, L))
                self.assertLess(tmax1, tmax0 + 2.5, (adapt, L))
                if L == 10:
                    print("\n  [plant terkalibrasi] %-12s L=%d: suhu terendah %.1f -> %.1f C, IAE %.0f -> %.0f, maks %.1f -> %.1f"
                          % ("adaptif" if adapt else "konvensional", L, tmin0, tmin1, iae0, iae1, tmax0, tmax1))

    def test_ff_ditahan_saat_suhu_di_atas_setpoint(self):
        p = Pid(adapt=False)
        p.enable(155.0, 0, False, 150.0, 10.0)
        p.sp_eff = 150.0
        p.ff_start(0)
        p.update(155.0, 1000, False, 150.0, 1000, 1000)
        self.assertEqual(p.ff, 0.0)
        self.assertTrue(p.ff_on)                            # tidak dibatalkan, hanya ditahan
        p.update(149.0, 2000, False, 150.0, 2000, 2000)
        self.assertAlmostEqual(p.ff, FF_PCT * math.exp(-2.0 / FF_TAU), places=4)

    def test_ff_batal_saat_tahan_overshoot_dan_meluruh(self):
        p = Pid()
        p.enable(140.0, 0, False, 150.0, 10.0)
        p.ff_start(0)
        p.update(161.0, 1000, False, 150.0, 1000, 1000)     # >= sp + 10 -> TAHAN
        self.assertFalse(p.ff_on)
        q = Pid(); q.enable(140.0, 0, False, 150.0, 10.0); q.ff_start(0)
        for i in range(1, int(5 * FF_TAU) + 3):
            q.update(140.0, i * 1000, False, 150.0, i * 1000, i * 1000)
        self.assertFalse(q.ff_on)                            # habis setelah 5 tau

    def test_firmware_ff_dipicu_saat_z_turun_dan_mode_pidm(self):
        self.assertIn("case 4: ujMoveZ(-UJ_PCT_DOWN); pidFfStart();", SRC)
        self.assertRegex(SRC, r'sscanf\(cmd, "pidm,%d", &v\) == 1')
        self.assertIn("send('pidm,1')", SRC)
        self.assertIn("send('pidm,0')", SRC)
        self.assertIn("send('pid,0')", SRC)
        self.assertNotIn("send('pida,", SRC)
        self.assertEqual(SRC.count("pidFfCancel();"), 3)    # pidDisable, pidSafeEnter, TAHAN


class UjiTahanIntegralBeku(unittest.TestCase):                       # rev 37
    def _sim(self, skenario, L=10):
        a, k = 0.015, 0.015 * 11.0 / 135.0
        sp = 150.0
        T = 165.0 if skenario == 2 else sp
        u0 = k * (T - 30.0) / a
        p = Pid()
        hist = [u0] * (L + 1)
        p.enable(T, 0, False, 165.0 if skenario == 2 else sp, u0)
        rows = []
        for i in range(1, 900):
            T += a * hist[-(L + 1)] - k * (T - 30.0)
            ukur = T + (14.0 if (skenario == 1 and 100 <= i < 125) else 0.0)   # artefak probe tercelup
            p.update(ukur, i * 1000, False, sp, i * 1000, i * 1000)
            hist.append(0.0 if p.hold else p.out)
            rows.append((i, T))
        return rows, p

    def test_artefak_sesaat_tidak_menjatuhkan_suhu(self):
        for L in (10, 30):
            rows, _ = self._sim(1, L)
            t_min = min(T for i, T in rows if i >= 100)
            self.assertGreater(t_min, 145.5, L)                # rev 36 (integral nol): 145.2 / 143.7
            iae = sum(abs(150 - T) for i, T in rows if i >= 100)
            self.assertLess(iae, 400, L)                         # rev 36: ~1700

    def test_overshoot_sungguhan_tidak_bertambah(self):
        for L in (10, 30):
            rows, _ = self._sim(2, L)
            self.assertLess(max(T for i, T in rows if i >= 60), 160.5, L)
            self.assertGreater(min(T for i, T in rows), 148.0, L)   # rev 36: 145.2 / 143.1

    def test_firmware_tidak_menolkan_integral_saat_tahan(self):
        blok = SRC[SRC.index("  if (pidHold) {"):]
        blok = blok[:blok.index("return;")]
        self.assertNotIn("pidI = 0", blok)


class UjiIntegralTidakDinolkan(unittest.TestCase):                    # rev 38
    def test_stop_lalu_on_memakai_integral_terakhir(self):
        p = Pid(); p.enable(150.0, 0, False, 150.0, 0.0)
        p.I = 11.0
        p.disable("STOP")
        self.assertEqual(p.out, 0.0)                                # katup TUTUP saat STOP
        p.enable(140.0, 10_000, False, 150.0, 0.0)                  # katup 0% setelah STOP
        self.assertEqual((p.I, p.out), (11.0, 11.0))                # dulu 0 -> menit-an membangun ulang

    def test_bukaan_lebih_besar_tetap_dipakai(self):
        p = Pid(); p.I_mem = 5.0
        p.enable(140.0, 0, False, 150.0, 20.0)
        self.assertEqual(p.I, 20.0)

    def test_tahan_aman_sensor_membekukan_integral(self):
        p = Pid(); p.enable(150.0, 0, False, 150.0, 12.0)
        p.update(float("nan"), 6000, False, 150.0, 6000, 0)         # sensor error > 5 dtk
        self.assertEqual((p.safe, p.out, p.I), (2, 0.0, 12.0))

    def test_firmware_tidak_ada_pidI_nol(self):
        import re
        kode = re.sub(r"//[^\n]*", "", SRC)
        kode = re.sub(r"/\*.*?\*/", "", kode, flags=re.S)
        self.assertNotRegex(kode, r"(?<!float )pidI\s*=\s*0\s*;")   # deklarasi awal boleh
        self.assertIn("pidIMem = pidI", kode)


class UjiAdaptif(unittest.TestCase):
    def test_default_ki_tidak_diadaptasi(self):
        p = Pid(); p.gains(50.0, 0.0)
        self.assertEqual(LI, 0.0); self.assertEqual(p.kie, KI)

    def test_adaptif_off_sama_dengan_pid_biasa(self):
        a = simulasi(detik=1500, pid=Pid(adapt=False))[1]
        b = simulasi(detik=1500, pid=Pid(lp=0, li=0, ld=0))[1]
        self.assertEqual([r[1] for r in a], [r[1] for r in b])
        self.assertTrue(all(r[6] == KP and r[7] == KI for r in a))

    def test_gain_mengikuti_hukum_dan_batas(self):
        p = Pid(li=0.0005)                                  # default rev 24 lambda_i = 0; uji hukumnya
        p.gains(10.0, 0.2)
        self.assertAlmostEqual(p.kpe, KP + LP * 10)
        self.assertAlmostEqual(p.kie, KI + 0.0005 * 10)
        self.assertAlmostEqual(p.kde, KD + LD * 0.2)
        p.gains(200.0, 50.0)
        self.assertEqual((p.kpe, p.kie, p.kde), (max(KP, KP_MAX), max(KI, KI_MAX), max(KD, KD_MAX)))
        q = Pid(kp=5.0)                                      # Kp0 > Kp_max: tidak diturunkan
        q.gains(0.0, 0.0); self.assertEqual(q.kpe, 5.0)

    def test_gain_dipakai_selalu_dalam_batas(self):
        rows = simulasi(detik=3000)[1]
        self.assertTrue(all(r[6] <= KP_MAX + 1e-9 and r[7] <= KI_MAX + 1e-9 and r[8] <= KD_MAX + 1e-9 for r in rows))

    def test_gangguan_ubi_adaptif_vs_biasa(self):
        # steady di 150 C, lalu ubi masuk pada t = 4000 s: suhu turun 10 C dalam 10 s
        beban = lambda i: -1.0 if 4000 <= i < 4010 else 0.0
        hasil = {}
        for nama, pid in (("biasa", Pid(adapt=False)), ("adaptif", Pid())):
            rows = simulasi(detik=6000, pid=pid, beban=beban)[1]
            seg = [r for r in rows if r[0] >= 4000]
            iae = sum(abs(150.0 - r[1]) for r in seg)
            turun = 150.0 - min(r[1] for r in seg)
            pulih = next((r[0] - 4000 for r in seg if r[0] > 4010 and abs(150.0 - r[1]) < 1.0), None)
            hasil[nama] = (iae, turun, pulih)
            print("\n  [plant dugaan] %-7s IAE %.0f C*s | turun maks %.2f C | pulih (<1 C) %s s"
                  % (nama, iae, turun, pulih))
        self.assertLessEqual(hasil["adaptif"][0], hasil["biasa"][0])


if __name__ == "__main__":
    print("Konstanta dari firmware: Kp %.3f Ki %.4f Kd %.2f Umax %.0f ramp %.2f | lambda %.3f %.4f %.2f | max %.1f %.3f %.1f"
          % (KP, KI, KD, UMAX, RAMP, LP, LI, LD, KP_MAX, KI_MAX, KD_MAX))
    unittest.main(verbosity=2)
