asadbahauddin/thermoadapt-fryer/(commit log)

2026-10-19 Init: firmware rev 11, model Simulink Adaptive PID, toolkit step test FOPDT/SIMC
    [FRITZINK.fzz]
2026-10-19 Firmware rev 12: setpoint suhu di web (garis putus-putus), sp/seq/ms di JSON
    - Setpoint 20-200 C diatur dari web (perintah sp,<C>), disimpan di flash
    - Grafik web menggambar setpoint sebagai garis putus-putus oranye
    - Pesan temp menyertakan sp, seq (nomor sampel), ms (waktu sampel) untuk logger
    - Belum ada PID: setpoint hanya referensi
2026-10-19 Logger Python via WebSocket + nama kolom MATLAB diselaraskan
    - logger.py: grafik live suhu vs setpoint (putus-putus) dan bukaan servo, jendela 5 menit
    - CSV semua sensor/aktuator, ditulis tiap sampel (flush + fsync berkala)
    - Tutup jendela atau Ctrl+C: CSV ditutup, PNG seluruh pengujian disimpan
    - Waktu sampel dari jam ESP32, deteksi paket hilang/ESP reset, sambung ulang otomatis
    - Limit switch yang kena sesaat di antara sampel tetap tercatat
    - Mode --demo dan uji otomatis (parser, server WebSocket tiruan, end-to-end)
    - analisis_step_test.m: kolom default elapsed_s / servo_target_pct / suhu_c
    [config.py, demo_esp.py, grafik.py, koneksi.py, logger.py, parser_esp.py, pencatat.py, uji_logger.py]
2026-10-20 Firmware rev 13-14 (perubahan pengguna, apa adanya)
    - rev 13: pemetaan ulang limit switch (17 Z Atas, 35 Z Bawah, 39 X Awal, 34 X Akhir),
    servo dikunci 0..55 derajat, kalibrasi dihapus dari web
    - rev 14: step test open-loop di web (stt/stx), analisis R, L, usulan Kp/Ki/Kd di browser
2026-10-20 Firmware rev 15: pin BTS7960 baru + filter sensor suhu (tolak lonjakan, hold, SG kausal)
    - BTS7960: RPWM=26, LPWM=27, EN=14; DC_POS_USES_RPWM kembali true (arah wajib diuji ulang)
    - MAX31855 dibaca tiap 200 ms; lonjakan > 5 C ditolak; hold maks 3000 ms lalu NAN
    (static_assert HOLD < FAULT); gLastValidMs hanya dari sampel valid
    - Savitzky-Golay kausal 11/2, koefisien hardcode (n/143) dari scipy savgol_coeffs
    - Kirim tetap 1 Hz; JSON temp + tr, held, ec; HELD tampil di web & LCD
    - SENSOR_FILTER_ENABLE 0 = perilaku lama
    - Python/uji_filter_sensor.py: uji koefisien dari .ino + porting logika hold
2026-10-20 Logger: catat suhu mentah, flag ditahan, jumlah error sensor, status step test
    - Kolom baru: suhu_mentah_c (tr), suhu_ditahan (held), sensor_error_total (ec),
    step_test_status (st), step_test_elapsed_s (te); pesan firmware lama tetap terbaca
    - Demo mengikuti format rev 15 (hold 2 detik lalu error)
    - Uji: 11 tes logger + 8 tes filter lulus
    [demo_esp.py, parser_esp.py, uji_logger.py]
2026-10-20 BTS7960: RPWM dan LPWM ditukar (RPWM=GPIO27, LPWM=GPIO26)
    Pin ditukar pengguna setelah pengecekan; komentar dan teks web diselaraskan.
    EN tetap GPIO14. Arah naik/turun tetap wajib diuji dengan Naik 25%.
2026-10-20 Firmware rev 16: PID suhu digabung ke rev 15 + perbaikan hasil tinjauan; logger PID
    Firmware (dasar rev 15: filter sensor, pin RPWM 27/LPWM 26/EN 14 tidak diubah):
    - PID suhu dari versi pengguna: pidEnable/pidUpdate/pidDisable, kotak web, perintah pid/pidk,
    ramp setpoint efektif, anti-windup bersyarat, bumpless, D pada pengukuran
    - PID 1 Hz dari nilai tersaring; dt dari waktu sampel terkirim
    - Perbaikan: Umax pakai key pm (um = pulsa servo), watchdog PID bila data suhu berhenti,
    I dan D beku saat HELD, snapshot suhu/waktu/flag di critical section, derivatif diinisialisasi
    ulang setelah NAN, perintah >= 64 karakter dibalas (tidak dibuang diam-diam), pesan STOP tidak
    saling menimpa, pa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
2026-10-20 Firmware rev 17: Adaptive PID (hukum adaptasi sama dengan model Simulink)
    - Kp = Kp0 + lp|e|, Ki = Ki0 + li|e|, Kd = Kd0 + ld|dT/dt|, dibatasi Kp<=3, Ki<=0.065, Kd<=5
    (batas dipilih dari cek Ms pada model FOPDT dugaan; Kp 6/Ki 0.2 terbukti tidak aman)
    - Integral disimpan dalam satuan keluaran: perubahan Ki tanpa loncatan
    - Web: ADAPTIF ON/OFF (OFF = PID biasa sebagai pembanding), lambda, gain yang dipakai
    - JSON temp + kpe/kie/kde (gain dipakai tiap sampel); st + ad, lp, li, ld; disimpan di flash
    - Tanpa deadband integral (keputusan pengguna)
    - Logger: kp/ki/kd = gain dipakai, kp0/ki0/kd0, lambda, pid_adaptif
    - uji_pid.py: 14 tes, termasuk adaptif OFF = PID biasa dan gangguan ubi adaptif v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
2026-10-20 Web: setpoint dan parameter PID bisa diubah (isian tidak lagi ditimpa status ESP)
    - Bug: status tiap 250 ms menimpa isian yang baru diketik saat fokus pindah ke tombol,
    sehingga nilai lama yang terkirim. Isian yang sudah diketik kini tidak ditimpa sampai dikirim.
    - Setpoint menerima koma atau titik, Enter langsung mengirim, ada pesan konfirmasi
    - Tombol PID diberi nama jelas: MULAI KONTROL (PID ON) / BERHENTI KONTROL (PID OFF)
    [dep_frayer.ino]
2026-10-21 Firmware rev 18: kalibrasi katup servo lewat kotak sudut per derajat
    - Slider dihapus; kotak sudut + tombol -1/+1 untuk pemakaian dan kalibrasi
    - svk,<deg>: gerak 0..180 untuk mencari titik rapat (ditolak saat PID/step test)
    - Simpan sbg TUTUP/BUKA (TUTUP < BUKA, selisih >= 5 derajat), koreksi pulsa 0/180 derajat
    - Kalibrasi dimuat dari flash saat boot (rev 13 memaku 0/55), nilai rusak -> default
    - Step test & label web memakai sudut TUTUP/BUKA tersimpan
    - TUTUP = katup rapat, api padam (keputusan pengguna); peringatan di web dan header
2026-10-21 Firmware rev 19: kalibrasi katup boleh sudut negatif (mis. TUTUP -3 derajat)
    - svk menerima -30..180, ditolak bila pulsa < 300 us (sekitar -18 derajat dengan pulsa default)
    - TUTUP tersimpan boleh negatif; pembulatan sudut negatif diperbaiki (lroundf)
    - Kotak sudut di web menerima tanda minus di HP
2026-10-21 Firmware rev 20: perbaikan servo mentok di 0 derajat
    - Penyebab: tombol -1/+1 dan kotak Sudut memakai setServoAngle() yang diam-diam mengunci
    ke TUTUP..BUKA, jadi di 0 derajat -1 tidak berbuat apa-apa
    - Semua perintah manual (sva, svad, svk) kini memakai setServoAngleManual(): -30..180 derajat,
    dibatasi pulsa 300-3000 us, dan memberi pesan bila ditolak; PID dan step test tetap dikunci
    - Halaman web dikirim dengan header no-cache; versi firmware tampil di judul
    - Web menampilkan pulsa yang dikirim ke servo untuk membedakan bug firmware vs servo mentok mekanis
    - Python/uji_servo.py: cek statis + porting jalur perintah servo (8 tes)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
    [dep_frayer.ino, uji_servo.py]
2026-10-21 Teks TUTUP disesuaikan hasil kalibrasi: api minimum, bukan padam
    Servo mentok di -3 derajat dan katup masih menyisakan api kecil yang tidak menaikkan suhu.
    Teks web dan komentar firmware diperbarui: TUTUP = api minimum (seperti pilot), servo bukan
    pemutus gas, cara kalibrasi berhenti di sudut terakhir yang servonya diam. FW_REV rev 20b.
2026-10-21 Firmware rev 21: Cascaded Filtering 3 tahap + servo default hasil kalibrasi
    - Filter suhu: Median-5 -> Moving Average-5 -> EMA (alpha 0.3), menggantikan tolak-lonjakan + SG
    (jeda ~1.3 s, std noise ~34%, lonjakan 1-2 sampel dibuang); HOLD saat fault dipertahankan
    - Servo default TUTUP -3 derajat, BUKA 55 derajat (hasil kalibrasi di alat)
    - PID Umax default 100% (seluruh rentang -3..55); simulasi: overshoot naik ke ~6-7 C,
    bisa diturunkan dari web
    - uji_filter_sensor.py ditulis ulang untuk filter cascade (9 tes); uji_pid menyesuaikan Umax
    [dep_frayer.ino, parser_esp.py, uji_filter_sensor.py, uji_pid.py]
2026-10-21 Firmware rev 22: LCD reset tiap 30 dtk, watchdog, non-blocking penuh
    - LCD di-reset dan diinisialisasi ulang tiap 30 dtk lewat state machine millis()
    (blink-without-delay); MAX31855 di-begin ulang karena berbagi bus SPI; sampling suhu
    tetap jalan selama pin RESET ditahan
    - Watchdog 10 dtk untuk loop() dan uiTask: macet -> ESP restart, katup TUTUP, PID mati
    - Semua delay() dihapus dari kode; sisa tunggu hanya delay internal tft.init() library
    (~295 ms tiap 30 dtk, core 0) dan delayMicroseconds(2) setup CS MAX31855
    - Diagnosa di web: alasan boot terakhir, heap minimum, sisa stack uiTask, jumlah reset LCD
    - IP di LCD diformat tanpa String (tanpa fragmentasi heap)
    - Python/uji_robust.py: c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
    [dep_frayer.ino, uji_robust.py]
2026-10-21 Firmware rev 23: reset LCD otomatis dimatikan, diganti tombol Reset LCD di web
    - LCD_REINIT_MS 0: reset tiap 30 dtk (rev 22) terasa kurang stabil di alat
    - Perintah lcdr / tombol Reset LCD: pin RESET -> tft.init() -> MAX31855 begin() -> gambar ulang,
    dikerjakan uiTask (core 0) lewat flag, non-blocking; loop() tidak menyentuh SPI
    - Watchdog, diagnosa, dan pola non-blocking rev 22 tetap
    - uji_robust.py: default tanpa reset otomatis, reset manual, flag-only (10 tes)
    [dep_frayer.ino, uji_robust.py]
2026-10-27 Firmware rev 24: overshoot tidak mematikan PID, validasi step test web, gain sementara
    - Suhu >= setpoint + 10 C: katup ditahan TUTUP, integral 0, PID tetap ON; normal lagi di
    setpoint + 7 C. PID mati total hanya di 180 C, sensor error, atau STOP
    - Step test web: hasil TIDAK VALID (gain disembunyikan) bila R^2 < 0.9, kenaikan < 10 C,
    kemiringan tidak konsisten, atau durasi < 3 x dead time
    - Jendela kemiringan 1/5 durasi (60..300 dtk); jendela 60 dtk salah membaca dead time
    (uji: L asli 80 dtk terbaca 225 dtk, sekarang 90 dtk)
    - Gain default sementara Kp 1.46, Ki 0.0054, lambda_i 0 (step test 28 Okt tidak valid)
    - Logger: kolom pid_tahan; uji_pid 16 tes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
    [dep_frayer.ino, parser_esp.py, uji_logger.py, uji_pid.py]
2026-10-27 Firmware rev 25: heartbeat WebSocket + uji halaman web di browser sungguhan
    - Halaman web rev 24 diuji di Chrome headless (klik mouse dan sentuh HP, ESP tiruan):
    55/55 tombol mengirim perintah, tanpa error JS, tidak ada elemen menutupi tombol
    - Penyebab yang mungkin di alat: koneksi WebSocket mati (tab lama, HP tidur, logger ditutup
    paksa) menghabiskan 5 jatah klien library -> halaman tampil tapi tidak tersambung
    - ws.enableHeartbeat(5 dtk, 3 dtk, 2): klien mati diputus ~15 dtk; logger Python terbukti
    membalas ping otomatis (websocket-client 1.8.0)
    - Jumlah klien WebSocket tampil di baris diagnosa web
    - Python/uji_browser.py: uji halaman di Chrome/Edge headless (mode mouse dan touch)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
    [dep_frayer.ino, uji_browser.py]
2026-10-27 Firmware rev 26: cek kewajaran sensor, bacaan salah tidak mematikan PID
    - Bacaan yang melompat > 5 C/dtk (+ margin 2 C) dari bacaan wajar terakhir dianggap salah:
    nilai terakhir ditahan, PID tetap hidup (kasus lapangan: setpoint 65 C, bacaan 200 C)
    - Bertahan > 3 dtk -> NAN, > 5 dtk -> PID mati dengan alasan sensor error (bukan suhu)
    - Acuan tidak dihapus saat masa tahan habis (bug ditemukan tes: bacaan salah sempat diterima
    sebagai acuan baru setelah 3 dtk); bacaan di luar -20..450 C selalu ditolak
    - Kenaikan nyata bertahap dan suhu turun saat ubi masuk tetap lolos; batas akhir 180 C tetap
    - uji_filter_sensor.py: 15 tes termasuk skenario filter + PID bersama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
    [dep_frayer.ino, uji_filter_sensor.py]
2026-10-28 Firmware rev 27: PID tidak pernah mati otomatis, hanya lewat PID OFF/STOP
    - Sensor error > 5 dtk, suhu >= 180 C, data suhu berhenti, setpoint > batas, dan overshoot
    -> TAHAN AMAN: katup TUTUP (api minimum), integral 0, PID tetap ON, lanjut sendiri saat
    normal (180 C: lanjut di <= 175 C); kode alasan di JSON ph dan tampil di web
    - Setelah ESP restart PID tetap OFF (api tidak menyala sendiri tanpa orang)
    - Tidak ada perubahan kode LCD/SPI/MAX31855 sejak rev 24 (dicek dengan git diff)
    - Tes: uji_pid 17, uji_filter_sensor 15 (bacaan salah 200 C: kode 2 lalu kode 3, PID tetap ON),
    halaman web di Chrome 55/55 tombol (mouse dan touch)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
    [dep_frayer.ino, uji_browser.py, uji_filter_sensor.py, uji_pid.py]
2026-10-28 Firmware rev 28: PID ON selalu bisa dinyalakan
    - pidEnable dulu menolak bila sensor tidak valid/HELD, suhu >= 175 C, setpoint > 165 C,
    step test berjalan, atau servo terkunci; dengan bacaan sensor 200 C (rev 26 menahannya)
    PID ON selalu ditolak
    - Sekarang PID ON selalu berhasil; kondisi tidak aman -> langsung TAHAN AMAN (katup TUTUP)
    dan berjalan sendiri saat normal; step test yang berjalan dihentikan otomatis
    - Setpoint maks 165 C di web dan firmware (dulu web menerima sampai 200 lalu PID menolak)
    - Tes: uji_pid 18 (enable selalu berhasil, sensor pulih -> lanjut), halaman web 55/55 di Chrome
2026-10-28 Firmware rev 29: setpoint bebas, pengaman 180 C tetap
    - Setpoint menerima angka berapa pun (web dan firmware); kode TAHAN 5 dihapus
    - Pengaman 180 C tetap: TAHAN AMAN (katup TUTUP, PID ON) sampai <= 175 C
    - Simulasi plant dugaan: dead time 20 s -> setpoint 200 memuncak 183 C; dead time 80 s ->
    sampai ~208 C (panas yang sudah di jalan). Pengaman prediktif diuji (horizon 80-240 s)
    tetapi tidak dipasang: tidak aman di semua model dan mengganggu kontrol setpoint normal.
    Batas suhu sebenarnya harus ditentukan dari step test yang valid.
2026-10-28 Firmware rev 30: batas suhu 180 C di PID dinonaktifkan (pakai E-stop manual)
    - PID_CUTOFF_ENABLE 0: tidak ada batas suhu otomatis (keputusan pengguna; E-stop fisik
    memutus gas). Kode tetap ada, ganti ke 1 untuk mengaktifkan lagi.
    - Tetap: TAHAN saat sensor error / data suhu berhenti / overshoot setpoint + 10 C (PID ON)
    - Web: setpoint > 200 C minta konfirmasi (penangkal salah ketik, bukan batas)
    - Tes: uji_pid 18, uji_filter_sensor 15, halaman web 55/55 di Chrome
    [dep_frayer.ino, uji_browser.py, uji_filter_sensor.py, uji_pid.py]
2026-10-28 Firmware rev 31: LCD dimatikan (SPI fokus termokopel), sudut servo minimum -1 derajat
    - LCD_ENABLE 0: LCD tidak diinisialisasi/digambar; MAX31855 di-begin langsung; CS LCD (4)
    dan CS touch (16) ditahan HIGH; GPIO15 (RESET LCD) tidak dikendalikan. LCD_ENABLE 1 tetap
    terkompilasi bersih (jalur LCD utuh untuk dipakai lagi)
    - Sudut paling minimum -1 (manual, kalibrasi, TUTUP); TUTUP tersimpan -3 -> default -1
    - Tes: uji_servo 9, uji_robust 11 (LCD mati hanya menyentuh MAX31855), halaman web di
    Chrome 54/55 mengirim (tombol -1 kalibrasi di -1 ditolak dengan pesan: benar)
    [dep_frayer.ino, uji_browser.py, uji_robust.py, uji_servo.py]
2026-10-28 Firmware rev 32: pembacaan MAX31855 diperkuat (analisis bacaan 200 C)
    Temuan analisis software:
    - readCelsius() Adafruit hanya cek bit fault D2..D0: frame rusak (bit D16/D17/D3, cold
    junction aneh) lolos sebagai suhu sah; 0x00000000 terbaca 0 C
    - Firmware membaca 2-3x per sampel (maxReadRaw, readCelsius, readError): diagnosa tidak
    konsisten dengan suhu yang dipakai PID
    - Cek kewajaran rev 26 mengambil acuan dari 1 sampel: sampel rusak saat boot jadi acuan
    Perbaikan:
    - Tiap sampel dibaca 2x berturut-turut; berbeda = data rusak di SPI -> ditolak
    (simulasi 5% baca rusak: nilai salah lolos 1.7% -> 0.0003%)
    - Dekode sendiri dengan validasi datasheet (D16, D17, D3, 0x0/0xFFFFFFFF, cold junc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
2026-10-30 Firmware rev 33: Uji Sistem otomatis (uji kematangan) + kolom logger
    Z naik ke Z Atas -> X ke X Awal -> suhu di SP-3..SP+7 selama 10 dtk -> Z turun 50%
    sampai Z Bawah -> timer goreng (default 120 dtk, bisa diubah di web) -> Z naik 55%
    sampai Z Atas -> X ke X Akhir. Gerak uji tanpa batas waktu (berhenti oleh limit),
    PID ON otomatis, STOP membatalkan, gerak manual ditolak selama uji.
    Logger: kolom uji_tahap, uji_detik, uji_timer_s. Uji: Python/uji_sistem.py (16 tes).
2026-10-31 Firmware rev 34: tombol PID Adaptif/Konvensional/STOP PID + feedforward beban keripik
    - Web: PID ADAPTIF ON (pidm,1), PID KONVENSIONAL ON (pidm,0, gain dasar tetap), STOP PID.
    - Feedforward beban: saat Uji Sistem menurunkan keranjang, keluaran +25% meluruh (tau 90 s),
    ditahan saat suhu >= setpoint, batal saat TAHAN/PID mati; sama untuk kedua mode.
    Simulasi plant terkalibrasi log 31 Okt: suhu terendah 136.3 -> 142.2 C, IAE -29%.
    - Gain dasar tidak diubah (identifikasi closed-loop: sudah di rentang SIMC).
    - Logger: kolom pid_ff_pct; pid_adaptif dari sampel temp.
    - Python/bandingkan_pid.py: metrik per siklus goreng (turun maks, overshoot, waktu pulih,
    IAE/ISE) + grafik Adaptif vs Konvensi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
    [bandingkan_pid.py, dep_frayer.ino, parser_esp.py, uji_browser.py, uji_pid.py, uji_sistem.py]
2026-10-31 Firmware rev 37: TAHAN overshoot membekukan integral (dulu dinolkan)
    Log 31 Okt & 1 Nov: setelah tiap TAHAN suhu jatuh 7-18 C di bawah SP (8 kejadian) karena
    integral dibangun ulang dari 0. Simulasi plant terkalibrasi: IAE -58..-89%, suhu maks sama.
    [dep_frayer.ino, uji_pid.py]
2026-10-31 Firmware rev 38: integral PID tidak pernah dinolkan
    Dibekukan saat TAHAN AMAN (sensor error/data berhenti), diingat saat STOP PID/STOP dan dipakai
    lagi saat PID ON (dulu mulai dari bukaan katup = 0% setelah STOP). Berlaku kedua mode.
    [dep_frayer.ino, uji_pid.py]
